deep-diary/trotbot_ws/src/trotbot_status_led/README.md

# trotbot_status_led（RQ-023）

鲁班猫 RK3588 上驱动 **WS2812** 直线灯带（默认 **8** 灯）：优先 **`spidev`（SPI MOSI）** 或 **`rockchip_mmap`（GPIO 寄存器）** / **`gpiod`**；订阅 `power_sequence_node` 的 **`/power_sequence/state`**、**`/power_sequence/gate_open`**，按 YAML 显示灯语。

## 依赖

- ROS 2 Humble：`rclcpp`、`std_msgs`、`yaml_cpp_vendor`
- 系统：**`libgpiod-dev`**（提供 `gpiod.h` 与 `libgpiod`）。若构建时未安装，CMake 会生成 **stub** 二进制（**不链 libgpiod**，**灯带绝不会亮**）。实机请先 **`sudo apt install -y libgpiod-dev`** 再 **`colcon build`**，并用 **`ldd …/status_led_node | grep gpiod`** 确认已链接。

## 构建

```bash
sudo apt install libgpiod-dev   # 实机 / 交叉编译环境（若仅用 rockchip_mmap 可不链 gpiod，仍建议安装以便可选 gpiod 后端）
cd /path/to/trotbot_ws
source /opt/ros/humble/setup.bash
colcon build --packages-select trotbot_status_led --allow-overriding trotbot_status_led
source install/setup.bash
```

### 完整编译 + 实机灯语自测（可复制）

在 **工作空间根目录** 执行。

- 默认参数为 **`ws2812_backend: spidev`**：只需 **`/dev/spidev*`** 存在且用户有权限（常见：`dialout` 组），**一般不必 sudo**。
- 若仍使用 **`rockchip_mmap`**：**必须 `sudo`** 才能 mmap **`/dev/mem`**（见「常见故障」）。

```bash
cd ~/trotbot_ws
source /opt/ros/humble/setup.bash
colcon build --packages-select trotbot_status_led --allow-overriding trotbot_status_led
source install/setup.bash

bash ~/trotbot_ws/install/trotbot_status_led/share/trotbot_status_led/scripts/test_status_led_manual.sh
```

使用 **`rockchip_mmap`** 时用：

```bash
sudo -E env "PATH=$PATH" bash -lc '
  source /opt/ros/humble/setup.bash
  source ~/trotbot_ws/install/setup.bash
  export TROTBOT_WS=$HOME/trotbot_ws
  bash ~/trotbot_ws/install/trotbot_status_led/share/trotbot_status_led/scripts/test_status_led_manual.sh
'
```

若工作空间不在 `~/trotbot_ws`，把路径与 **`TROTBOT_WS`** 改成实际目录。

也可 **`bash …/install/.../scripts/test_status_led_manual.sh`**：脚本会向上查找 **`install/setup.bash`**。失败时请 **`export TROTBOT_WS=/你的/trotbot_ws`**。

## 后端：`spidev`（默认）、`rockchip_mmap`、`gpiod`

- **`ws2812_backend: spidev`（推荐）**：通过 **`/dev/spidevX.Y`** 用 **MOSI** 送出编码后的字节流；波形由 **SPI 硬件** 移位，**CPU 抖动小**，通常**不需 root**。鲁班猫 **40PIN Pin19 = `SPI0_MOSI_M2`**，灯带 **DIN** 接该脚（详见 [`docs/SPI_WS2812_RK3588.md`](docs/SPI_WS2812_RK3588.md)）。需在设备树中 **启用对应 SPI 控制器 + `spidev`**，`ls /dev/spidev*` 应可见设备。
- **`ws2812_backend: rockchip_mmap`**：通过 **`/dev/mem`** mmap GPIO。**RK3588 为 GPIO V2**，须 **掩码写 DR**；启动时用 **gpiod 一次性 mux**。**需 `sudo`**。
- **`gpiod`**：**ioctl 过慢**，易 **发白**，仅调试用。

参数 **`mmap_gpio_phys_base`**（仅 mmap）：RK3588 **GPIO3** 一般为 **`0xFEC40000`**，与 **`gpio_line_offset`**（Pin16=`GPIO3_C1`→ **17**）组合。

## 参数与映射

- 默认参数：[`config/status_led_params.yaml`](config/status_led_params.yaml）（**spidev**：填写 **`spidev_path`**；**mmap**：按 **`gpioinfo`** 填写 **`gpiochip`** / **`gpio_line_offset`**）。
- 灯语规则：[`config/status_led_map.yaml`](config/status_led_map.yaml)（状态 → RGB；YAML 字段 **`effect`**：`solid` / `breath` / `chase`（流水预留）；**`breath_period_s`** 用于呼吸周期）。
- **`led_count`**：灯珠数量，默认 **8**。
- **刷新策略**：**`refresh_on_change_only`**（默认 **true**）— 仅在 **`/power_sequence/state`** 或 **`gate_open`** 变化（及启动延迟首帧）时写 WS2812；固态规则不按固定 **`refresh_hz`** 连续刷。**`change_repeat_count`** / **`change_repeat_interval_ms`**：同一变化下重复写次数与间隔（抗偶发丢帧）。**`animation_refresh_hz`**：呼吸等动画的独立刷新频率。**`initial_push_delay_ms`**：启动后延迟首帧，便于 **`transient_local`** 状态先到。**`refresh_on_change_only:=false`** 时恢复旧行为：按 **`refresh_hz`** 周期刷新（仍可用于排查闪烁）。
- **`simulate_hardware: true`**：不访问 GPIO（订阅与映射仍运行），用于无硬件桌面调试。
- **`debug_fixed_color: true`**：忽略灯语映射，全条同一 **`debug_fixed_r/g/b`**（再乘 **`global_brightness`**），由 **`refresh_hz`** 周期刷新；量产请 **`false`**。
- **联调话题（无需另写节点）**：**`publish_debug_rgb: true`** 时发布 **`debug_rgb_topic`**（默认 **`/status_led/debug_rgb`**，`std_msgs/UInt8MultiArray` 3 字节 R、G、B，已乘 **`global_brightness`**）与 **`debug_meta_topic`**（默认 **`/status_led/debug_meta`**，`std_msgs/String`，含 `state`、`gate_open`、**`map_match`** 等）。`map_match=0` 且灯色与预期不符时，多为状态字符串与 YAML 不一致。联调可并行：`ros2 topic echo /power_sequence/state` 与 `ros2 topic echo /status_led/debug_meta`。

## 启动

单独：

```bash
ros2 launch trotbot_status_led status_led.launch.py
```

仅 **`ros2 run`** 时若**不加参数文件**，只会用节点内置默认值（已与 **`ws2812_backend:=spidev`** 对齐）。要完整使用 **`config/status_led_params.yaml`**（灯语 / `debug_fixed_color` 等），请二选一：

```bash
ros2 launch trotbot_status_led status_led.launch.py
```

```bash
ros2 run trotbot_status_led status_led_node --ros-args \
  --params-file "$(ros2 pkg prefix trotbot_status_led)/share/trotbot_status_led/config/status_led_params.yaml"
```

整机（示例，`trotbot_basic` **默认不启用**，需显式打开）：

```bash
ros2 launch trotbot trotbot_basic.launch.py use_can_bridge:=true use_status_led:=true
```

覆盖参数文件：

```bash
ros2 launch trotbot_status_led status_led.launch.py params_file:=/path/to/my_params.yaml
```

## PS4 手柄灯条 / 振动反馈（`ds4_feedback_node`）

除了 WS2812 灯带，本包还提供 **PS4（DualShock 4）灯条 + 振动** 反馈：`ds4_feedback_node` 直接读 `status_led_map.yaml` 的灯语，把狗子状态同步到手柄。可与 WS2812 节点**并行运行**，两者互不冲突。

### 反馈内容

| 来源 | 手柄表现 |
|---|---|
| `/power_sequence/state` + `/power_sequence/gate_open` | 按 [`config/status_led_map.yaml`](config/status_led_map.yaml) 显示颜色（Idle 蓝、Running 绿、Precheck/SoftStand 橙、SoftProne 橙红、ProneHold 蓝、Fault 红等） |
| 进入 Running（gate 开） | 绿灯 + 弱震 120 ms |
| 进入 ProneHold | 蓝灯 + 弱震 120 ms |
| 进入 Idle/Disable/SoftProne 且 gate 关 | 对应灯色 + 强震 500 ms（下电/失控能提示） |
| `Fault` 或电机故障 | 红灯双闪 + 双强震（各 200 ms，间隔 350 ms） |
| `/cmd_vel` 行走/静止 | Running 时行走高亮绿灯，静止压暗到 35%；起步弱震 80 ms（可关） |
| `/diagnostics` 电机故障 | `trotbot_can_bridge:motor_feedback:*` 的 ERROR 或 `fault_mask != 0` → 红灯双闪 + 双震 |

> 电机故障需要 `trotbot_can_bridge/config/control_gains.yaml` 中 `publish_motor_diagnostics: true`（本仓库默认已开）。

### 依赖与权限

- Python：`rclpy`、`std_msgs`、`geometry_msgs`、`diagnostic_msgs`、`ament_index_python`、`python3-yaml`。
- 设备：自动扫描 `/dev/hidraw*`（DS4 VID `054C`，PID `05C4/09CC/0BA0`），USB/蓝牙均可；也可用 `hidraw_path` 指定。
- 权限：当前用户需对 `/dev/hidraw*` 可读写（常见为 `dialout` 组或 udev 规则）。无权限/无手柄时节点只 WARN 一次并继续发布调试话题，不影响遥控。

### 启动

```bash
# 单独启动
ros2 launch trotbot_status_led ps4_feedback.launch.py

# 随 teleop 一起（trotbot_teleop.launch.py 默认 use_ps4_feedback:=true）
ros2 launch trotbot trotbot_teleop.launch.py use_joystick:=true use_ps4_feedback:=true

# 整机（use_teleop:=true 时透传）
ros2 launch trotbot trotbot_basic.launch.py use_can_bridge:=true use_teleop:=true \
  use_joystick:=true use_xterm:=false use_status_led:=true use_ps4_feedback:=true
```

关闭手柄反馈：传 `use_ps4_feedback:=false`，或 `ros2 param set /ds4_feedback_node ...` 后重启。

### 调试话题

`/trotbot/ps4/feedback`（`std_msgs/String`，JSON）变化即发，并每 1 s 心跳一次，字段：

```json
{"state":"Running","gate":true,"cmd_linear_x":0.1,"cmd_angular_z":0.0,"moving":true,
 "class":"ready","rgb":[0,255,0],"color":"#00FF00","pattern":"solid",
 "rumble_weak":0.0,"rumble_strong":0.0,"motor_fault":false,"map_match":true,"device":"hidraw2"}
```

无手柄时 `device` 为空，其余逻辑仍可验收：

```bash
ros2 topic pub --once /power_sequence/gate_open std_msgs/msg/Bool "{data: true}"
ros2 topic pub --once /power_sequence/state std_msgs/msg/String "{data: Running}"
ros2 topic echo /trotbot/ps4/feedback
```

参数文件：[`config/ps4_feedback_params.yaml`](config/ps4_feedback_params.yaml)（振动强度/时长、行走阈值与亮度、调试心跳周期等）。

## 降级语义

- **GPIO 打开失败**或 **stub 构建**：节点保持运行，**不打断**运动栈；仅 WARN 一次，无灯带输出。
- **绿灯（就绪）语义**：仅在 **完整 ROS 栈已启动**、**映射条件成立**且 **硬件驱动成功**时成立；若 systemd 未拉起状态灯节点或映射未进入「可遥控」状态，**不得**仅凭「无灯」推断整机状态。

## RK3588 / GPIO 实测

填写模板见 [`docs/RK3588_GPIO_WS2812_HAL.md`](docs/RK3588_GPIO_WS2812_HAL.md)（**GPIO3_C1**、**Pin16**、`gpiochip`+line、镜像记录）。

## systemd 示例

- **只跑灯带**（不启整机）可用下例；**更常见**是开机直接起 **`trotbot_basic`**（含 `use_status_led:=true`），见仓库根 **`README.md`「开机自启（systemd）」** 与包内 **`trotbot/config/systemd/trotbot-basic.service.example`**。

```ini
[Unit]
Description=TrotBot WS2812 status LED (ROS 2)
After=network-online.target

[Service]
Type=simple
User=bot
Environment="ROS_DOMAIN_ID=0"
ExecStart=/bin/bash -lc 'source /opt/ros/humble/setup.bash && source /home/bot/trotbot_ws/install/setup.bash && ros2 launch trotbot_status_led status_led.launch.py'
Restart=on-failure

[Install]
WantedBy=multi-user.target
```

将 `ExecStart` 与整机 bringup 对齐；灯带与 `trotbot_basic` 同进程时，用 **同一 install/setup** 与 **`use_status_led:=true`** 的顶层 launch 即可，**不要**再单独 enable 上例，避免双起 `status_led`。

## 验证

```bash
ros2 node list | grep status_led
ros2 topic echo /power_sequence/state --once
# 预期 Running + gate_open 时呈绿色整条（见 status_led_map.yaml）
```

## 常见故障

| 现象 | 排查 |
|---|---|
| **各色都像白 / 全亮** | 多为位时序被判成全 **1**。已默认 **AArch64 CNTVCT 忙等** + 可调 **`timing_*_ns`**；建议 **`sudo`** 并启用 **`mlock_all`** / **`realtime_sched_priority`**（见 `status_led_params.yaml`）。仍发白则继续**减小** `timing_t0h_ns`、`timing_t1h_ns` 或微调 `t0l`/`t1l`。 |
| **无 sudo 时似乎永远停在上一档灯语（例如一直是 Precheck）** | `rockchip_mmap` 打不开 **`/dev/mem`** → 节点**不发帧**；灯珠仍显示**上一次成功点亮会话的最后一帧**，不是话题没更新。请 **`sudo`** 运行节点，或改用 **`ws2812_backend:=gpiod`**（见日志 WARN/ERROR）。 |
| **第一颗灯高频率闪、且偏绿** | WS2812 协议为 **GRB**，线路上**第一字节是 G**；首 bit 时序或总线边沿略抖时，常先反映为**绿通道**闪。可试：① 设 **`timing_lead_in_reset_us`** 为 **500～800**（帧前长低，比 `pre_frame` 更稳）；② 略增 **`timing_reset_us`**；③ 将 **`refresh_hz`** 降到 **30～40**；④ 硬件上 DIN 串 **200～470Ω**、**3.3V/5V 电平**与**共地**可靠。若仍明显，需考虑 **SPI/MOSI 发码** 等更稳的物理层。 |
| **第一颗灯偶尔乱色 / 闪**（一般） | 当不用 `lead_in` 时，可增大 **`timing_pre_frame_idle_us`**；与上一行二选一或组合试验。 |
| `Device or resource busy` | DTS/其它驱动占用该 GPIO；见野火文档与 `docs/RK3588_GPIO_WS2812_HAL.md` |
| 灯色错乱 | 微调 `timing_*_ns` / `timing_reset_us`；检查电平与供电共地 |
| 构建提示 stub | 安装 `libgpiod-dev` 后 **`colcon build` 重编** |
| **`spidev 打开失败`**（日志 WARN） | 常见为 **`/dev/spidev0.0` 权限不足**（如属 root 且 `600`）。临时：`sudo chmod 666 /dev/spidev0.0`；长期：用户加入 **`dialout`** 组并配置 **udev** 规则，或 **`sudo`** 运行节点。 |
| **SPI 灯色不对 / 全白乱闪** | 核对 **`spidev_max_speed_hz`**（默认 6.4 MHz）与 **`spidev_bit0_byte` / `spidev_bit1_byte`**；官方 overlay 若固定别的时钟需重算编码，见 **`docs/SPI_WS2812_RK3588.md`**。 |
| **SPI 首灯偶发闪绿** | WS2812 为 **GRB**，首字节为 G。可试：**`spidev_pre_write_idle_us`**（80～200）、**`spidev_reset_trailer_bytes`**（180～300）、**`spidev_leading_spi_zero_bytes`**（0～32，无效则置 0）、略降 **`refresh_hz`**；硬件：**DIN 串电阻**、电平与共地。 |
