deep-diary/trotbot_ws/.trae/documents/机器狗过温保护实现计划.md

# 机器狗过温保护（等效 R3 下电）实现计划

## 一、需求与结论

**需求**：任意电机温度达到 100°C 时，自动执行与「按下 R3」完全一致的动作——退出当前模式 → 软趴 safe-park → 失能 → 回到 `Idle` 休息降温。

**现状结论：狗子目前不具备该功能。**

- 温度数据已经存在：`/can_rx_frames` 里 `0x18`（主动上报）/`0x02`（应答反馈）帧的 `data[6..7]` 已被解析为 `MotorFeedback::current_temp`（单位 °C，分辨率 0.1，大端）。
- 但温度只被用于：`/motor_feedback` 字符串打印、`/diagnostics` 的 `temp_c` 字段；**不参与任何动作决策**。
- 固件 `temp_error` 故障位（CAN ID bit18）只被塞进诊断 `fault_mask` 的 bit3，进而只影响手柄红灯/震动，**不会停车或失能**。
- `SequenceState::Fault` 是空壳（无任何 `EnterState(Fault)`、无出口逻辑），不可直接复用。
- 全仓无 `thermal` / `overheat` / `max_temp` 之类阈值保护；`README.md:566` 的 `safety_manager_node` 仍是 Backlog。

**已确认的设计选择（用户选择）**

1. **锁定 + 滞回**：触发后屏蔽 L3 上电，直到所有有效电机温度降到恢复阈值（默认 80°C）以下，且仍需人工按 L3 才会上电。
2. **仅日志**：触发/解除只打 `RCLCPP_ERROR`/`WARN` 日志，不新增话题、不改状态机、不接灯。

## 二、现状关键代码位置（已实测确认）

| 关注点 | 位置 |
|---|---|
| 温度解码（唯一可信源） | [protocol_codec.hpp](file:///home/cat/trotbot_ws/src/trotbot_can_bridge/include/trotbot_can_bridge/protocol_codec.hpp#L139-L163)，温度在 **L160** |
| 反馈缓存（已订阅 `/can_rx_frames`） | [power_sequence_node.cpp](file:///home/cat/trotbot_ws/src/trotbot_can_bridge/src/power_sequence_node.cpp#L229-L255)，角度缓存在 **L237-242** |
| 参数声明区 | 同文件 **L66-136**；反馈相关参数在 **L98-100** |
| 主循环 `OnTimer` | **L338-429**；`motor_init_active_` 早退在 **L375-377**；`Idle` 分支 **L379-388** |
| R3 分支（`Running` L394-398、`ProneHold` L407-410、启动过程 L420-425） | 同文件 |
| 软趴/失能链路 | `BeginSoftProne(true)` **L504-520** → `TickState` **L463-479** → `Disable` **L484-495** → `Idle` |
| 状态枚举 | **L47-58** |
| 成员变量区 | **L1087-1194**；反馈缓存在 **L1152-1154** |
| 配置 | [power_sequence.yaml](file:///home/cat/trotbot_ws/src/trotbot_can_bridge/config/power_sequence.yaml) |
| 文档（按键表） | [README.md](file:///home/cat/trotbot_ws/README.md#L454-L464) |

## 三、改动方案

### 3.1 `src/trotbot_can_bridge/config/power_sequence.yaml`

在「反馈新鲜度」块之后（现 L88 之后）追加，并保持现有中文注释风格：

```yaml
    # --- 过温保护（等效按 R3：软趴 -> 失能 -> Idle）---
    # 任一路有效反馈温度 >= thermal_limit_c 并持续 thermal_debounce_s 后触发一次；
    # 触发后锁存，屏蔽 L3/start 上电，直到所有有效温度 <= thermal_recover_c 才解锁（仍需人工按 L3）。
    enable_thermal_protection: true
    thermal_limit_c: 100.0
    thermal_recover_c: 80.0
    thermal_debounce_s: 0.5
    # 超过该秒数没有 0x18/0x02 反馈的电机视为无效，不参与判定
    thermal_fresh_timeout_s: 2.0
```

### 3.2 `src/trotbot_can_bridge/src/power_sequence_node.cpp`

**(a) 构造函数新增参数（插在 L100 `motor_feedback_fresh_timeout_s_` 之后）**

```cpp
enable_thermal_protection_ = this->declare_parameter<bool>("enable_thermal_protection", true);
thermal_limit_c_ = this->declare_parameter<double>("thermal_limit_c", 100.0);
thermal_recover_c_ = this->declare_parameter<double>("thermal_recover_c", 80.0);
thermal_debounce_s_ = this->declare_parameter<double>("thermal_debounce_s", 0.5);
thermal_fresh_timeout_s_ = this->declare_parameter<double>("thermal_fresh_timeout_s", 2.0);
if (thermal_recover_c_ >= thermal_limit_c_) {
  RCLCPP_WARN(
    this->get_logger(), "thermal_recover_c=%.1f >= thermal_limit_c=%.1f invalid, fallback to %.1f",
    thermal_recover_c_, thermal_limit_c_, thermal_limit_c_ * 0.8);
  thermal_recover_c_ = thermal_limit_c_ * 0.8;
}
```

**(b) 成员变量（加在 L1111 `motor_feedback_fresh_timeout_s_` 之后 + 反馈缓存区 L1153-1154 之后）**

```cpp
bool enable_thermal_protection_{true};
double thermal_limit_c_{100.0};
double thermal_recover_c_{80.0};
double thermal_debounce_s_{0.5};
double thermal_fresh_timeout_s_{2.0};
double thermal_over_s_{0.0};      // 连续超限累计时间
bool thermal_latched_{false};     // 锁存：置位后禁止上电
int thermal_hot_motor_id_{-1};    // 最近一次触发电机（日志用）
double thermal_hot_temp_c_{0.0};
std::array<double, 64> last_feedback_temp_c_{};  // 新增，紧邻 last_feedback_angle_rad_
```

**时间戳复用**：不新增温度时间戳数组。温度与角度来自同一反馈帧，直接用现有 `last_feedback_stamp_ns_[id]`（L1154）判定新鲜度。

**(c) `OnCanRxFrame`（L237-242 现有 block 内）追加一行**

```cpp
last_feedback_temp_c_[fb->motor_id] = fb->current_temp;
```

**(d) 新增两个私有方法**（建议放在 `BeginSoftProne` 之前，L504 附近）

```cpp
/// 扫描缓存，返回最高有效温度；无有效数据返回 -1.0
double MaxFreshMotorTempC(int * motor_id_out)
{
  double max_temp = -1.0;
  int max_id = -1;
  const int64_t now_ns = this->now().nanoseconds();
  for (size_t id = 0; id < last_feedback_temp_c_.size(); ++id) {
    if (last_feedback_stamp_ns_[id] <= 0) {
      continue;
    }
    const double age_s = static_cast<double>(now_ns - last_feedback_stamp_ns_[id]) / 1e9;
    if (age_s > thermal_fresh_timeout_s_) {
      continue;
    }
    if (last_feedback_temp_c_[id] > max_temp) {
      max_temp = last_feedback_temp_c_[id];
      max_id = static_cast<int>(id);
    }
  }
  if (motor_id_out) {
    *motor_id_out = max_id;
  }
  return max_temp;
}

/// 过温判定 + 锁存/滞回。返回 true 表示本 tick 已触发（调用方应立即 return）
bool UpdateThermalProtection(double dt)
{
  if (!enable_thermal_protection_) {
    return false;
  }
  int max_id = -1;
  const double max_temp = MaxFreshMotorTempC(&max_id);

  if (thermal_latched_) {
    // 所有有效温度都回落到恢复阈值以下才解锁；无有效数据时保持锁存（保守）
    if (max_temp >= 0.0 && max_temp <= thermal_recover_c_) {
      thermal_latched_ = false;
      thermal_over_s_ = 0.0;
      RCLCPP_WARN(
        this->get_logger(),
        "thermal protection cleared: max temp %.1f C <= %.1f C; press L3 to power on again",
        max_temp, thermal_recover_c_);
    }
    return false;
  }

  if (max_temp >= thermal_limit_c_) {
    thermal_over_s_ += dt;
    if (thermal_over_s_ < thermal_debounce_s_) {
      return false;
    }
    thermal_latched_ = true;
    thermal_hot_motor_id_ = max_id;
    thermal_hot_temp_c_ = max_temp;
    RCLCPP_ERROR(
      this->get_logger(),
      "thermal protection TRIGGERED: motor=%d temp=%.1f C >= %.1f C; "
      "perform R3-equivalent safe-park -> disable (state=%s)",
      max_id, max_temp, thermal_limit_c_, StateName(state_));
    TriggerThermalShutdown();
    return true;
  }

  thermal_over_s_ = 0.0;
  return false;
}

/// 与 R3 完全等价的下电路径复用
void TriggerThermalShutdown()
{
  switch (state_) {
    case SequenceState::Running:
    case SequenceState::Precheck:
    case SequenceState::EnableInit:
    case SequenceState::SoftStand:
      BeginSoftProne(true);
      break;
    case SequenceState::SoftProne:
      // 已在趴下途中：不重新锚定 z0（避免高度跳变），仅升级为「趴完再失能」
      pending_start_after_prone_ = false;
      use_stand_resume_for_softstand_ = false;
      soft_prone_then_disable_ = true;
      break;
    case SequenceState::ProneHold:
      EnterState(SequenceState::Disable);
      break;
    case SequenceState::Idle:
    case SequenceState::Disable:
    case SequenceState::Fault:
    default:
      break;
  }
}
```

**(e) `OnTimer` 挂载（L375-377 的 `motor_init_active_` 早退之后、L379 `Idle` 分支之前）**

```cpp
    // 过温保护：等效 R3，最高优先级；触发当 tick 直接接管
    if (UpdateThermalProtection(dt)) {
      return;
    }
```

放在 `motor_init_active_` 之后的原因：设零期间电机未使能、门禁关闭，不应被热保护打断；且此时 `state_` 为 `Idle`，`TriggerThermalShutdown()` 本身也是 no-op。

**(f) 锁存期间屏蔽上电（3 处）**

1. `OnTimer` `Idle` 分支（L381）：

```cpp
      if (l3_edge) {
        if (thermal_latched_) {
          RCLCPP_WARN(
            this->get_logger(),
            "joy L3 ignored: thermal protection latched (motor=%d was %.1f C, need <= %.1f C)",
            thermal_hot_motor_id_, thermal_hot_temp_c_, thermal_recover_c_);
          return;
        }
        ... 原逻辑
      }
```

2. `OnTimer` `ProneHold` 分支的 `square_edge`（站起也是使能态延续）：同样先判 `thermal_latched_`，命中则 `WARN` 并忽略。

3. `OnCommand` 的 `start` 分支入口（L280 之后）：`if (thermal_latched_) { WARN; return; }`。

`R3`/`shutdown`/`prone`/`set_zero` 不受锁存影响（继续允许下电）。

## 四、行为定义（决策完备）

| 触发时状态 | 动作 |
|---|---|
| `Running` / `Precheck` / `EnableInit` / `SoftStand` | `BeginSoftProne(true)` → 软趴 2.5s → `Disable` 失能 → 0.25s → `Idle` |
| `SoftProne`（○ 趴下途中） | 升级为「趴完即失能」，不重锚 `z0` |
| `ProneHold` | 直接 `EnterState(Disable)` |
| `Idle` / `Disable` / `Fault` | 只记录日志并锁存，无额外动作（已失能） |

- **去抖**：连续 `>= thermal_limit_c` 累计 `thermal_debounce_s`（默认 0.5s ≈ 25 个 tick）才触发，避免单帧毛刺。
- **新鲜度**：只用 `<= thermal_fresh_timeout_s`（默认 2s）内的反馈；全部超时则视为无数据，不触发也不解锁。
- **锁存与解锁**：触发即锁存；当**有有效数据且最大值 `<= thermal_recover_c`** 时自动解锁并打 WARN；解锁后仍需人工按 L3。
- **进程重启**：锁存为内存态，重启节点/断电后清零（符合「休息降温后再上电」的直觉）。

## 五、假设与非目标

- 假设温度字段可信（`protocol_codec.hpp:160` 已验证 0.1°C、大端）。
- 不新增 `Fault` 状态、不改状态灯 `status_led_map.yaml`、不改 `ds4_feedback_node`。
- 不新增话题；不处理固件 `temp_error` 位（该位仍只走原诊断/红灯链路）。
- 不改 `motor_protocol_node`、不改 `motor_monitor_node`。
- 阈值仅对反馈温度生效，不做电流/力矩热模型估算。

## 六、验证步骤

1. **编译**

```bash
cd /home/cat/trotbot_ws
colcon build --packages-select trotbot_can_bridge --symlink-install
source install/setup.bash
```

2. **参数生效**

```bash
ros2 param get /power_sequence_node thermal_limit_c        # 100.0
ros2 param get /power_sequence_node thermal_recover_c      # 80.0
ros2 param get /power_sequence_node enable_thermal_protection  # True
```

3. **无硬件注入测试**（推荐先做，不接电机）

`power_sequence_node` 已订阅 `/can_rx_frames`，手工发一帧伪造的 `0x18` 上报帧即可。打包格式见 [frame_codec.hpp](file:///home/cat/trotbot_ws/src/trotbot_can_bridge/include/trotbot_can_bridge/frame_codec.hpp#L16-L19)：`[bus, is_ext, dlc, id3, id2, id1, id0, d0..d7]`。

电机 51、温度 100.0°C（1000 = 0x03E8）时 `can_id = 0x180033FD`：

```bash
ros2 topic pub --once /can_rx_frames std_msgs/msg/UInt8MultiArray \
  "{data: [0, 1, 8, 24, 0, 51, 253, 0, 0, 0, 0, 0, 0, 3, 232]}"
```

- 以 `thermal_limit_c:=35.0 thermal_debounce_s:=0.0` 启动节点，发上述帧后应出现
  `thermal protection TRIGGERED: motor=51 temp=100.0 C`。
- 发温度 20°C（200 = 0x00C8 → `[...,0,0,0,200]`，即 `data[6]=0x00,data[7]=0xC8`）后，应出现
  `thermal protection cleared`，随后 L3 可上电。

4. **实机测试**

低阈值跑一次全链路（`thermal_limit_c:=40.0`）：确认 `Running` → `SoftProne` → 软趴到 `prone_z` → `Disable` 失能 → `Idle`，且 `/power_sequence/state` 序列与按 R3 时一致；锁存期间按 L3 应被 WARN 拒绝。

5. **回归**

R3 / ○ / □ / L3 / L1+R1 原行为不变（重点确认 `Running` 下 R3 仍先软趴再失能，`ProneHold` 下 R3 直接失能）。

## 七、文档更新

`README.md` 的按键/状态机章节（L454-464 表格后）补一小段「过温保护」，说明阈值参数、等效 R3 行为、锁存与滞回、恢复方式。`power_sequence.yaml` 注释已覆盖参数语义，不另建文档。
