deep-diary/trotbot_ws/docs/trotbot/本地运行指南.md

# 本地运行指南（入口）

## 主文档位置

**详细步骤（安装、编译、遥控、RViz、CAN 调研章节等）**在包内：

- **`src/trotbot/本地运行指南.md`**

本文档为 `docs/trotbot/` 下的**入口与实机基线摘要**，便于与需求/架构文档交叉引用。

---

## 实机 EL05 双 CAN + 遥控（当前推荐基线）

1. **编译与环境**（至少包含 `trotbot`、`trotbot_can_bridge`、`champ_base`、`champ_teleop`）：
   ```bash
   source /opt/ros/humble/setup.bash
   cd ~/trotbot_ws
   colcon build --symlink-install --packages-select champ_msgs champ champ_base champ_teleop trotbot trotbot_can_bridge
   source install/setup.bash
   ```
2. **CAN**：确认 `can0`/`can1` 已 `up`、波特率与电机一致（常见 1Mbps）。参见根目录 **`README.md`**「MIT 双 CAN」章节与 `src/trotbot/本地运行指南.md` 11.7 节。
3. **整机启动**（步态 + CAN 桥 + 上电状态机，默认 **无** `servo_interface` 时勿再依赖舵机）：
   ```bash
   ros2 launch trotbot trotbot_basic.launch.py use_servo_interface:=false use_can_bridge:=true
   ```
4. **遥控**（另一终端，`champ_teleop` + 手柄/键盘）：
   ```bash
   ros2 launch trotbot trotbot_teleop.launch.py use_joystick:=true use_xterm:=false
   ```
5. **启停与姿态**：由 **`power_sequence_node`** 处理（默认随 `can_bridge.launch.py` 启动）。手柄约定见 **`src/trotbot_can_bridge/config/power_sequence.yaml`** 与 **[遥控与电源启停.md](./遥控与电源启停.md)**；无手柄时可用 `/power_sequence/command`（`start` / `prone` / `shutdown` / **`set_zero`**（仅 Idle+门禁关））。
6. **RViz 双模型**：`trotbot_basic.launch.py` 设 `rviz:=true` 时加载 `share/trotbot/rviz/trotbot.rviz`；反馈模型订阅 `/robot_description_feedback` 与 `fb/` TF 前缀，依赖 **`/joint_states_feedback`**（`motor_protocol_node` 定时发布 + CAN 更新缓存）。

---

## 文档放置原则

| 路径 | 用途 |
|---|---|
| `docs/trotbot/` | 需求清单、架构、问题跟踪、本入口（协作型） |
| `src/trotbot/本地运行指南.md` | 逐步操作、排障、CHAMP 补丁、长章节（执行型） |
| 根 `README.md` | 编译/启动、常用话题查看、遥控简表 |
| **CAN配置与报文调试.md** | 设备树 overlay、can-up、1Mbps 配置、`cansend` / `candump` |
| `src/trotbot_can_bridge/README.md` | 桥接脚本、协议调试、`power_sequence` 按键与话题 |
| **[音频使用说明.md](./音频使用说明.md)** | 实机蓝牙/板载音频：`pactl`、默认设备、录音与播放命令 |
