deep-diary/trotbot_ws/docs/trotbot/架构说明.md

# TrotBot 架构说明（ROS 2 Humble + EL05 双 CAN）

本文档面向当前硬件与代码基线，给出可落地的软件架构、ROS 节点、话题分布与数据流向。

- 计算平台：鲁班猫4-V1（RK3588S）
- 系统：ROS 2 Humble
- 执行器：灵足 EL05 无刷关节电机（12 路）
- 总线拓扑：`can0` 前腿 6 电机（11/12/13/21/22/23），`can1` 后腿 6 电机（51/52/53/61/62/63）
- 通信基线：CAN 2.0，`1Mbps`

---

## 1. 设计目标与边界

### 1.1 版本目标（当前阶段）

1. 打通 CHAMP 轨迹到 12 电机的稳定执行链路。
2. 建立可观测闭环（至少覆盖原始反馈和映射后状态）。
3. 对总线、越限、失联等问题具备基础保护能力。
4. 保持架构可演进，支持后续一键上/下电流程与双模型可视化。

### 1.2 边界约束

- 步态控制核心继续复用 `champ_base`，不改 CHAMP 内核。
- 下位机协议遵循 EL05 文档，控制模式以 MIT 运控链路为主。
- 现阶段优先“功能可用与稳定”，控制频率后续按实测再收敛。

---

## 2. 当前代码基线架构（As-Is）

当前真实链路（已与代码对齐）如下：

```mermaid
flowchart LR
  teleop[champ_teleop<br/>键盘/手柄] -->|/cmd_vel| qc
  teleop -->|/body_pose| qc
  teleop -->|/joy| ps
  qc[champ_base/quadruped_controller_node] -->|/joint_group_effort_controller/joint_trajectory| mp
  ps[power_sequence_node] -->|/power_sequence/gate_open Bool| mp
  ps -->|/body_pose Pose| qc
  ps -->|/can_tx_frames UInt8MultiArray| ct
  se[champ_base/state_estimation_node]:::node
  mp[motor_protocol_node] -->|/can_tx_frames UInt8MultiArray| ct
  ct[can_transport_node] -->|SocketCAN can0| can0[(Front 6 motors)]
  ct -->|SocketCAN can1| can1[(Rear 6 motors)]
  can0 -->|feedback frames| ct
  can1 -->|feedback frames| ct
  ct -->|/can_rx_frames UInt8MultiArray| mp
  mp -->|/motor_feedback String| obs[观测/日志]
  mp -->|/mit_motor_position_rad JointState| obs
  mp -->|/joint_states_feedback JointState| rspfb[robot_state_publisher_feedback]
  rsp[robot_state_publisher] --> rviz[RViz]
  rspfb --> rviz
  classDef node fill:#eef,stroke:#88a;
```

### 2.1 已落地节点

- `champ_base/quadruped_controller_node`
  - 订阅 `cmd_vel`，发布关节轨迹到 `joint_group_effort_controller/joint_trajectory`。
- `champ_base/state_estimation_node`
  - 状态估计节点，提供 CHAMP 状态闭环所需估计量。
- `trotbot_can_bridge/motor_protocol_node`
  - 订阅 `joint_trajectory`，按关节映射生成 MIT 五元组并发布到 `can_tx_frames`。
  - 订阅 `can_rx_frames`，解析 **0x02 应答反馈** 与 **0x18 主动上报**（数据域与 0x02 一致）；`enable_rx_decode_log` **仅**控制 `/motor_feedback` 字符串与解码 INFO，**不**影响反馈解析与关节角缓存。
  - 发布 `/joint_states_feedback`（CHAMP 关节名顺序，`SensorDataQoS`）；默认 **`feedback_joint_states_timer_hz`** 定时发布，与 CAN 反馈解耦，供 `robot_state_publisher_feedback` 与 RViz **`RobotModelFeedback`** 使用。**RQ-012**：当 **`publish_feedback_velocity_effort=true`** 时填充 **`velocity`**（rad/s，CHAMP 语义，`ω_champ = ω_mit / joint_signs`）与 **`effort`**（Nm，EL05 电机报告力矩，与 MIT `tau_ff` 同号）；缺失样本由 **`feedback_joint_fill_nan`** 决定 NaN 或 0。可选 **`publish_motor_diagnostics`** → **`motor_diagnostics_topic`**（默认 `/diagnostics`）发布 **`diagnostic_msgs/DiagnosticArray`**（每关节 `mode_status`、`temp_c`、`fault_*`）。**RQ-022**：MIT **`tau_ff`** = **`Clamp(runtime_tau_bus + gravity_ff_scale * tau_ff_nominal_nm[i], …)`**，由 **`enable_joint_tau_ff`** 开关；关闭时仍为前后总线标量 **`runtime_tau_can0/can1`**。
  - 可发布 MIT 映射角到 `/mit_motor_position_rad`。
  - 可选 `enable_power_sequence_gate`：仅当 `/power_sequence/gate_open=true` 时透传轨迹（与 `power_sequence_node` 联调）。
- `trotbot_dynamics/pinocchio_tau_ff_node`（**RQ-025**，可选，默认不启动）
  - 用 URDF（launch 通过 `xacro` 注入 `robot_description`）建立 **定基 12 自由度** Pinocchio 模型，校验关节名与 `DogMapper::kChampJointNames` 一致。
  - 订阅 `/joint_states_feedback`（按关节名映射），以 **`publish_hz`（默认 50Hz）** 计算广义重力项 `g(q)`，发布 `/model_tau_ff`（`sensor_msgs/JointState`，仅 `name` + `effort`，URDF 关节符号）。
  - 反馈超过 `input_timeout_s`（默认 0.2s）未更新时停止发布，由 `motor_protocol_node` 回落到查表/总线偏置。
- `trotbot_can_bridge/can_transport_node`
  - 订阅 `/can_tx_frames`，通过 SocketCAN 下发 `can0/can1`。
  - 轮询 `can0/can1` 回包并发布 `/can_rx_frames`。
  - 内置队列、重试、统计日志。
- `trotbot_can_bridge/power_sequence_node`
  - 订阅 `/joy`、`/power_sequence/command`、`/body_pose`（可选跟踪当前高度指令），处理上电/下电/趴下与 **`start`/`prone`/`shutdown`/`set_zero`/`motor_init`** 话题。
  - 发布 `/power_sequence/gate_open`、`/power_sequence/state`；可选 **`set_zero_event_topic`**（事件字符串：`set_zero_ok` / `set_zero_rejected:…`）与 **`motor_init_event_topic`**（`motor_init_ok` / `motor_init_fail` / `motor_init_rejected` / `zero_sta_verify_*`）。
  - 状态含 **`Idle / Precheck / EnableInit / SoftStand / Running / SoftProne / ProneHold / Disable / Fault`**：**`L3` 短按** = 上电/使能 **`start`**（唯一上电入口）；**`○` 短按** → `SoftProne` → **`ProneHold`**（idle 趴姿，保持使能）；**`□` 短按** → 从 `ProneHold` **`SoftStand`** 站起（stand，Running 时无动作）；`shutdown` 与 **`R3` 短按** → `SoftProne` → **`Disable`**（全机 Reset；`R3` 为唯一下电入口，Running/启动过程走 SoftProne，ProneHold 直接 Disable）。
  - `SoftProne`/`SoftStand` 高度：默认 **`track_body_pose_height`** 用当前 `body_pose.z` 作趴下起点；**`□` 短按站起**目标为 **`stand_z`**（名义站姿），话题 `start` 路径沿用 `stand_resume_z`。
  - **RQ-024**：话题 **`set_zero`** → **`TryRemoteSetZero`**：仅 **`Idle`** 且 **`gate_open=false`** 时连续 **`set_zero_repeat_count`** 轮 **`SendSetZeroAll()`**（CMD 0x06），轮间隔 **`set_zero_repeat_interval_ms`**；否则 WARN 拒绝。`Options` / `Share+Options` 手柄入口已取消。
  - **一次性电机标定初始化**：唯一手柄入口是未上电时 **`L1+R1`** 长按 **`motor_init_longpress_s`**（或话题 **`motor_init`**）→ 12 路 **`set_zero`**（当前姿态=机械零位，仅 `motor_init_do_set_zero=true`）→ 写 `zero_sta(0x7029)=1`（-180°~180°）→ CMD 0x16 保存 flash（data `01..08`）→ CMD 0x11 回读校验；仅 **`Idle`** 且 **`gate_open=false`**，初始化期间屏蔽 start/shutdown/prone，**必须在零位工装姿态下操作，写后需断电重启生效**。日常上电不再 set_zero。
  - 直接发布使能/失能/MIT 保持帧到 `/can_tx_frames` 完成启停编排；**`start`** 时先校验 12/12 反馈新鲜（`require_feedback_before_enable`），再使能，并按各电机当前反馈角发 MIT 保持帧（`send_mit_hold_in_startup`，不再发 `p=0`）。可选 **launch 后 Idle**（参数 **`enable_active_report_at_launch`**）即写 **0x7026** 并打开 **0x18**，无需等待 **`start`**；**`start`** 后的 **`EnableInit`** 仍会再跑完整使能链（可与 launch 阶段重复发上报，无害）。**`Disable` 仅发失能，不发送「上报 OFF」**，以便进程与 RViz 仍在运行时仍能收到周期反馈；需要关上报请用 `el05_motor_cansend.sh reset` 等。
- `trotbot_status_led/status_led_node`（**可选**，`trotbot/launch/trotbot_basic.launch.py` 中 **`use_status_led:=true`** 时随 **`trotbot_status_led/launch/status_led.launch.py`** 启动，默认不启用以免无硬件开发机失败）
  - 订阅 `/power_sequence/state`、`/power_sequence/gate_open`（**QoS** 与 `power_sequence` 发布端一致：`transient_local` + `reliable`），按 **`trotbot_status_led/config/status_led_map.yaml`** 将状态映射为 **8×WS2812** RGB 帧；**默认**在状态或 gate **变化时**写硬件（`refresh_on_change_only`，固态不周期狂刷），呼吸类规则用独立动画定时器。硬件输出由参数 **`ws2812_backend`** 选择：**`spidev`（SPI MOSI，默认）**、**`rockchip_mmap`（GPIO 寄存器 + `/dev/mem`）** 或 **`gpiod`**。设备不可用时**降级**（仅 WARN，不阻塞运动栈；见包 **README**）。

### 2.2 当前主要话题

| 话题 | 类型 | 方向 | 说明 |
|---|---|---|---|
| `/cmd_vel` | `geometry_msgs/Twist` | teleop -> CHAMP | 速度输入 |
| `/joint_group_effort_controller/joint_trajectory` | `trajectory_msgs/JointTrajectory` | CHAMP -> bridge | 12关节目标 |
| `/power_sequence/gate_open` | `std_msgs/Bool` | power_sequence -> protocol | 启动门禁开关（true 才透传轨迹） |
| `/power_sequence/command` | `std_msgs/String` | 外部 -> power_sequence | 无手柄时 `start`/`prone`/`shutdown` 文本指令 |
| `/power_sequence/state` | `std_msgs/String` | power_sequence -> 观测 | 状态机字符串（如 `Running`、`ProneHold`） |
| `/body_pose` | `geometry_msgs/Pose` | teleop / power_sequence -> quadruped_controller | 体态指令（`position.z` 为相对名义高度增量）；`power_sequence` 亦订阅以跟踪高度 |
| `/can_tx_frames` | `std_msgs/UInt8MultiArray` | protocol -> transport | 编码后的 CAN 帧 |
| `/can_rx_frames` | `std_msgs/UInt8MultiArray` | transport -> protocol | 回读 CAN 帧 |
| `/motor_feedback` | `std_msgs/String` | protocol -> debug | 解析后的电机反馈摘要（受 `enable_rx_decode_log` 控制是否刷屏） |
| `/mit_motor_position_rad` | `sensor_msgs/JointState` | protocol -> debug | 映射后的 MIT 位置 |
| `/joint_states_feedback` | `sensor_msgs/JointState` | protocol -> RSP/RViz | CHAMP 语义反馈：**`position`**；可选 **`velocity`/`effort`**（参数 **`publish_feedback_velocity_effort`**）；供 **`robot_state_publisher_feedback`**（`fb/` TF）与 RViz 反馈模型 |
| `/model_tau_ff`（可配置 **`pinocchio_tau_ff_topic`**） | `sensor_msgs/JointState` | dynamics -> protocol | **RQ-025** 模型重力前馈：`name` 为 12 个 CHAMP 关节，`effort` 为 URDF 关节空间 `g(q)`（Nm）；`motor_protocol_node` 经 `tau_signs`/`pinocchio_tau_ff_scale` 转换后写入 MIT `tau_ff` |
| `/diagnostics`（可配置 **`motor_diagnostics_topic`**） | `diagnostic_msgs/DiagnosticArray` | protocol -> 监控 | 可选：每关节电机 **`mode_status`**、温度、离散故障位（**`publish_motor_diagnostics`**） |

> 注：CHAMP 控制器仍发布 **`/joint_states`**（指令/估计链）；**反馈实测链**使用 **`/joint_states_feedback`**，与双模型 RViz 配置对应。

> **RQ-023**：`status_led_node` **仅订阅**上表已列出的 `/power_sequence/state` 与 `/power_sequence/gate_open`，不新增对外发布话题。

**MIT `tau_ff`（RQ-022）**：轨迹与最小刷新路径均使用 **`ComputeMitTorqueFf(i, bus)`**；总线偏置仍来自 **`default_tau_ff`** 与 **`/mit_gains_cmd`**（`runtime_tau_can0/can1`）；按关节前馈表为参数 **`tau_ff_nominal_nm`**（12 维，顺序同 **`DogMapper::kChampJointNames`**），全局增益 **`gravity_ff_scale`**，总开关 **`enable_joint_tau_ff`**（默认 **false**）。限幅：`ProtocolCodec::kTMin/kTMax`。

**RQ-025 模型前馈数据流（首版：定基 + 仅重力项）**：

```mermaid
flowchart LR
  js["/joint_states_feedback<br/>JointState.position"] --> dyn["pinocchio_tau_ff_node<br/>50Hz · computeGeneralizedGravity"]
  dyn -->|"/model_tau_ff<br/>JointState.effort (URDF 符号)"| mp["motor_protocol_node<br/>ComputeMitTorqueFf()"]
  mp -->|"MIT tau_ff"| can["/can_tx_frames"]
```

- 合并策略由 **`pinocchio_tau_ff_mode`** 决定：`off`（默认）/ `replace`（替代查表）/ `add`（与查表叠加，注意双计重力）。
- 安全链：模型数据超过 **`pinocchio_tau_ff_timeout_s`** 未更新 → 回落查表/总线偏置；门禁打开后按 **`pinocchio_tau_ff_ramp_s`** 线性斜坡；总增益 **`pinocchio_tau_ff_scale`** + 每关节 **`pinocchio_tau_ff_gain`**（默认 `0.5` / 全 1.0）；输出限幅 `kTMin/kTMax`。
- URDF τ → 电机 τ 的符号由 **`tau_signs`**（12 维）单独配置，初值同 `joint_signs`，但**必须逐关节做静力验证**，不得默认沿用位置符号。

---

## 3. 推荐目标架构（To-Be，V1.1）

目标是在不打断现有链路前提下，补齐“标准状态闭环 + 安全流程编排”。

```mermaid
flowchart LR
  subgraph Input["输入层"]
    joy[手柄/键盘]
    teleop2[champ_teleop]
  end
  subgraph Ctrl["控制层"]
    qc2[quadruped_controller_node]
    se2[state_estimation_node]
  end
  subgraph Bridge["执行桥接层"]
    mp2[motor_protocol_node]
    ct2[can_transport_node]
    sm[safety_manager_node<br/>建议新增]
    ps2[power_sequence_node<br/>已落地]
  end
  subgraph HW["硬件层"]
    can0b[(can0 front)]
    can1b[(can1 rear)]
    mtrs[(12x EL05)]
  end
  subgraph Viz["可视化与观测"]
    js[/joint_states feedback]
    cjs[/cmd_joint_states command]
    rviz2[RViz 单狗/双狗]
    diag[/diagnostics]
  end

  joy --> teleop2 -->|/cmd_vel| qc2
  qc2 -->|/joint_group_effort_controller/joint_trajectory| mp2
  mp2 -->|/can_tx_frames| ct2
  ct2 --> can0b --> mtrs
  ct2 --> can1b --> mtrs
  mtrs --> can0b --> ct2
  mtrs --> can1b --> ct2
  ct2 -->|/can_rx_frames| mp2

  mp2 --> js
  mp2 --> cjs
  mp2 --> diag
  ct2 --> diag
  sm -->|急停/限幅/门禁| mp2
  ps2 -->|gate_open / body_pose| mp2
  js --> rviz2
  cjs --> rviz2
```

### 3.1 新增/增强建议

1. ~~`motor_protocol_node` 增强反馈反解并发布标准 JointState~~：**已实现** `/joint_states_feedback`（反解 `urdf_pos = (motor_pos - offset) / sign`，顺序同 `kChampJointNames`；可选与标准 `/joint_states` 命名合并属产品口径问题）。
2. 增加 `cmd_joint_states`（命令态）用于双模型可视化（当前 RViz 指令侧仍主要依赖 `/joint_states`）。
3. 增加 `safety_manager_node`（可先内聚在 `motor_protocol_node`，后续再拆分）
   - 负责急停、越限截断、超时门禁、恢复条件。
4. ~~增加 `power_sequence_node`~~（**已落地**：`trotbot_can_bridge/power_sequence_node.cpp`，参数 `power_sequence.yaml`）
   - 后续可增强：与 `safety_manager` 统一急停接口、Action/Service 封装。

---

## 4. 数据流与时序

### 4.0 频率分解总览（2026-04-29 实测）

> 目的：定位“期望 200Hz 为何在链路中下降”。

```mermaid
flowchart LR
  joy["/cmd_vel<br/>geometry_msgs/Twist<br/>人工输入"] --> qc
  qc["quadruped_controller_node"] -->|"topic: /joint_group_effort_controller/joint_trajectory<br/>type: trajectory_msgs/JointTrajectory<br/>配置: loop_rate=200Hz<br/>真链路实测: ~200.0Hz"| mp

  mp["motor_protocol_node"] -->|"topic: /can_tx_frames<br/>type: std_msgs/UInt8MultiArray<br/>真链路实测: ~253.5fps"| ct
  mp -.->|"MP TX window(5s) 真链路:<br/>traj_cb:1000(≈200Hz)<br/>tx_total:3000(600fps)<br/>tx_traj:2976~3000(can0≈can1)<br/>tx_refresh:0~24<br/>skip_max_rate:9000+ "| mp

  ct["can_transport_node"] -->|"SocketCAN can0<br/>前腿ID:11/12/13/21/22/23"| can0
  ct -->|"SocketCAN can1<br/>后腿ID:51/52/53/61/62/63"| can1
  can0 -->|"反馈 /can_rx_frames<br/>真链路统计: enq_can0≈342~495/5s"| ct
  can1 -->|"反馈 /can_rx_frames<br/>真链路统计: enq_can1≈1248~1334/5s"| ct

  subgraph ext["外部显式脚本链路（非ROS）"]
    s1["el05_mit_stream_200hz_12_direct.sh<br/>目标:200Hz"] -->|"实测 loop:23.2Hz<br/>约 139fps/总线"| s2["cansend + sleep 调度"]
    s2 --> can0
    s2 --> can1
  end
```

- 关键结论1：真链路下 `/joint_group_effort_controller/joint_trajectory` 已稳定在约 `200Hz`，上游 CHAMP 频率本身正常。
- 关键结论2：`motor_protocol_node` 已观测到大量 `skip_max_rate`（每 5 秒约 `9000`），`max_tx_rate_per_motor_hz=60` 会主动削峰，导致协议层无法把 200Hz 全量透传到 `can_tx_frames`。
- 关键结论3（历史现象，已修复）：曾出现 `motor_protocol` 统计 `can0/can1` 近似 1:1，但 `can_transport` 的 `TX enqueue bus split(5s)` 偏向 `can1`。根因为 **`/can_tx_frames` 使用 BEST_EFFORT 浅队列导致 DDS 丢帧**；现改为 **Reliable + 足够深度** 后，两节点统计已一致（约 **1:1**，ratio≈1.01）。
- 关键结论4：外部 `bash+cansend` 显式脚本本身达不到 200Hz（实测约 23Hz loop），不能作为高频基线发送器。

### 4.1 控制主链路时序

```mermaid
sequenceDiagram
  participant U as 用户/手柄
  participant T as champ_teleop
  participant Q as quadruped_controller
  participant MP as motor_protocol
  participant CT as can_transport
  participant M as EL05电机

  U->>T: 摇杆/按键
  T->>Q: /cmd_vel
  Q->>MP: /joint_group_effort_controller/joint_trajectory
  MP->>MP: sign/offset 映射 + MIT打包
  MP->>CT: /can_tx_frames
  CT->>M: can0/can1 帧发送
  M-->>CT: 反馈帧
  CT-->>MP: /can_rx_frames
  MP-->>MP: 反馈解码 + 反向映射(建议)
  MP-->>RVIZ: /joint_states 与调试话题
```

### 4.3 频率预算（建议排障顺序）

1. 上游输入频率：先确认 `/joint_group_effort_controller/joint_trajectory` 实际 Hz（不要只看配置值）。
2. 协议层限频：观察 `MP TX window(5s)` 的 `skip_max_rate` 是否持续偏大。
3. 刷新补发：观察 `tx_refresh` 占比，若过高说明上游输入不稳或掉拍。
4. 传输层分配：对照 `can_transport_node` 的 `TX enqueue bus split(5s)` 是否接近 1:1。
5. 总线与电机反馈：最终用 `candump` 对照 can0/can1 的发送与反馈帧率是否同量级。

### 4.2 上/下电流程状态机（建议）

```mermaid
stateDiagram-v2
  [*] --> Idle
  Idle --> Zeroing: 上电触发
  Zeroing --> ZeroCheck
  ZeroCheck --> InitMotors: 零位通过
  ZeroCheck --> SafeAbort: 零位失败
  InitMotors --> LaunchControl
  LaunchControl --> AutoStand
  AutoStand --> Ready
  Ready --> MoveToProne: 下电触发
  MoveToProne --> DisableMotors
  DisableMotors --> ShutdownReady
  SafeAbort --> Idle
  ShutdownReady --> [*]
```

---

## 5. 话题与接口规划（建议基线）

### 5.1 运动与状态接口

- 输入
  - `/cmd_vel`
  - `/joint_group_effort_controller/joint_trajectory`
- 执行桥接内部
  - `/can_tx_frames`
  - `/can_rx_frames`
- 输出（建议强制标准化）
  - `/joint_states`（实时反馈，URDF语义）
  - `/cmd_joint_states`（命令态，便于双模型）
  - `/motor_feedback`（保留调试文本）
  - `/diagnostics`（总线/协议/保护状态）

### 5.2 参数分层建议

- `control_gains.yaml`
  - `kp` `kd` `default_velocity` `default_tau_ff`
- `calibration_profiles.yaml`
  - `joint_signs[12]` `joint_offsets_rad[12]` `joint_limits_*`
- `motor_map.yaml`
  - `joint -> motor_id -> can_bus`
- `bridge.yaml`
  - `rx_poll_ms` `tx_queue_max` `max_retry_per_frame`

---

## 6. 故障处理流向（建议）

```mermaid
flowchart TD
  A[运行中] --> B{检测异常}
  B -->|CAN超时/掉线| C[进入降级: 停止轨迹下发]
  B -->|越限/非法参数| D[截断并计数告警]
  B -->|电机故障位| E[触发急停流程]
  C --> F{恢复条件满足?}
  D --> F
  E --> G[失能并锁故障态]
  F -->|是| H[复位门禁后恢复]
  F -->|否| G
  H --> A
```

---

## 7. 与硬件平台匹配建议（RK3588S）

1. 进程部署
   - `can_transport_node` 与 `motor_protocol_node` 常驻，建议 systemd 级守护。
2. 资源隔离
   - 控制节点与可视化节点分组运行，避免 RViz 抢占实时链路。
3. 总线诊断
   - 保留 `can_transport_node` 5s 统计日志，作为现场首要健康指标。
4. 调参顺序
   - 先保守 `kp/kd` 与低速动作，再逐步提高动态性能。

---

## 8. 当前版本建议优先级（从功能性出发）

### P0（立即）

1. ~~完成反馈 JointState 发布~~：已实现 **`/joint_states_feedback`**（与标准 `/joint_states` 并存；字段扩展见 RQ-012）。
2. ~~在 launch 中明确真机 CAN~~：`trotbot_basic.launch.py` 使用 **`use_can_bridge`**；舵机路径由 **`use_servo_interface`** 控制（实机无刷常关）。
3. 增加最小安全门禁：反馈超时停止下发（可部分由 `motor_protocol` 步进限幅与门禁覆盖，独立 **safety_manager** 仍为 To-Be）。

### P1（短期）

1. ~~上/下电流程状态机节点化~~：**`power_sequence_node`** 已提供 Idle→Running、ProneHold、Disable 等。
2. ~~双模型 RViz~~：指令模型 + **`RobotModelFeedback`**（`/joint_states_feedback`，`fb/` TF）；`cmd_joint_states` 仍为可选增强。
3. 统一故障码与 `/diagnostics` 输出。

### P2（中期）

1. 安全管理独立成 `safety_manager_node`。
2. 形成自动化验收脚本（链路、方向、零位、故障注入）。

---

## 9. 架构相关关键文件索引

- 启动编排：`src/trotbot/launch/trotbot_basic.launch.py`（默认 `description_file=minidog_champ.urdf.xacro`、`gait_config_file=gait_minidog.yaml`）
- CHAMP 控制：`src/trotbot/launch/champ_controllers.launch.py`（同上默认，与 basic 传入一致）
- CAN bridge 启动：`src/trotbot_can_bridge/launch/can_bridge.launch.py`
- 协议节点：`src/trotbot_can_bridge/src/motor_protocol_node.cpp`
- 传输节点：`src/trotbot_can_bridge/src/can_transport_node.cpp`
- 上电状态机：`src/trotbot_can_bridge/src/power_sequence_node.cpp`
- 关节映射：`src/trotbot_can_bridge/include/trotbot_can_bridge/dog_mapper.hpp`
- 增益参数：`src/trotbot_can_bridge/config/control_gains.yaml`
- 启停与按键：`src/trotbot_can_bridge/config/power_sequence.yaml`
- 总线映射：`src/trotbot_can_bridge/config/motor_map.yaml`
- RViz 双模型：`src/trotbot/rviz/trotbot.rviz`

---

## 10. 备注

1. 本文档优先描述“可落地架构与演进路径”，目录级说明已弱化。
2. 如果你确认，我下一步可以直接补一版“节点接口契约表（消息字段级）”和“上/下电流程接口定义（service/action）”到本文件，便于直接进入开发。
