deep-diary/trotbot_ws/docs/README.md

# Workspace 文档总览

## 目录建议

- `docs/trotbot/`：TrotBot 项目核心文档（需求、架构、问题跟踪、运行指南入口）
- `docs/*.txt|*.cmd`：历史调试记录与临时脚本（建议后续按主题归档）

## TrotBot 文档入口

- `docs/trotbot/README.md`
- 根 `README.md` 的运行 / 调试专题已拆分到 `docs/trotbot/`：CAN 配置与报文调试、遥控与电源启停、CAN 桥架构与话题细节、CAN 频率与负载、模型重力前馈、部署与开机自启。
