deep-diary/trotbot_ws/docs/trotbot/部署与开机自启.md

# 部署与开机自启（systemd）

## 1) 改代码后：编译 + systemd 重启

`systemctl restart` 会按单元里的 `ExecStart` 重新跑一遍 `source install/setup.bash` 和 `ros2 launch …`，**前提是已把新代码编进 `install/`**。主栈包可只编到 `trotbot` 相关，避免工作区里 **minidog**（需 catkin）、**champ_gazebo**（需 Gazebo 依赖）等包导致全量 `colcon build` 失败：

```bash
cd ~/trotbot_ws
source /opt/ros/humble/setup.bash
colcon build --symlink-install --allow-overriding champ champ_msgs --packages-up-to trotbot trotbot_status_led trotbot_can_bridge trotbot_dynamics
sudo systemctl restart trotbot-basic
sudo systemctl status trotbot-basic --no-pager
# 可选：看启动日志
# journalctl -u trotbot-basic -b -e --no-pager
```

- 服务名以 `/etc/systemd/system/` 下实际 **`.service` 文件名** 为准（示例为 **`trotbot-basic`**）。若曾修改过 unit 文件，需先 **`sudo systemctl daemon-reload`** 再 **`restart`**。  
- 仅手跑 launch、**未**用 systemd 时，没有可 `restart` 的 unit，请用 `./main.sh restart` 或自行 `ros2 launch`。

## 2) 开机自启（systemd）

将示例单元复制为系统服务并修改 **`User`**、**`/home/bot/trotbot_ws`** 为你的账户与工作空间路径：

```bash
source /opt/ros/humble/setup.bash && source ~/trotbot_ws/install/setup.bash
sudo cp "$(ros2 pkg prefix trotbot)/share/trotbot/config/systemd/trotbot-basic.service.example" /etc/systemd/system/trotbot-basic.service
sudo nano /etc/systemd/system/trotbot-basic.service   # 改 User、WorkingDirectory、ExecStart 中的路径
sudo systemctl daemon-reload
sudo systemctl enable --now trotbot-basic.service
journalctl -u trotbot-basic.service -f
```

**灯带与 sudo**：`use_status_led:=true` 时，`status_led` 默认 **`sudo -E`** 启动灯节点；systemd 无交互终端，若未配置 **NOPASSWD**，请在 **`ExecStart` 同一行末尾**追加 **`status_led_use_sudo:=false`**（适用 **spidev** + 用户已在 **dialout** 等组）。详见 [`src/trotbot_status_led/README.md`](../../src/trotbot_status_led/README.md)。

**遥控**：无图形、无分配 TTY 时，键盘遥控无法像终端里一样使用；手柄需运行用户在 **`input`** 组。

## 3) `restart_trotbot_basic.sh`（已废弃，兼容保留）

脚本仍在原路径并可执行，但只是转发到 `trotbot_ctl.sh restart`（改为后台运行、带 PID/日志）。新操作请统一用 `./main.sh restart`。若由 **systemd** 管理整机启动，请优先用本文第 1 节，不要在机器上双起第二套 launch。
