deep-diary/trotbot_ws/docs/image/LubanCat-4-V1 pins.png

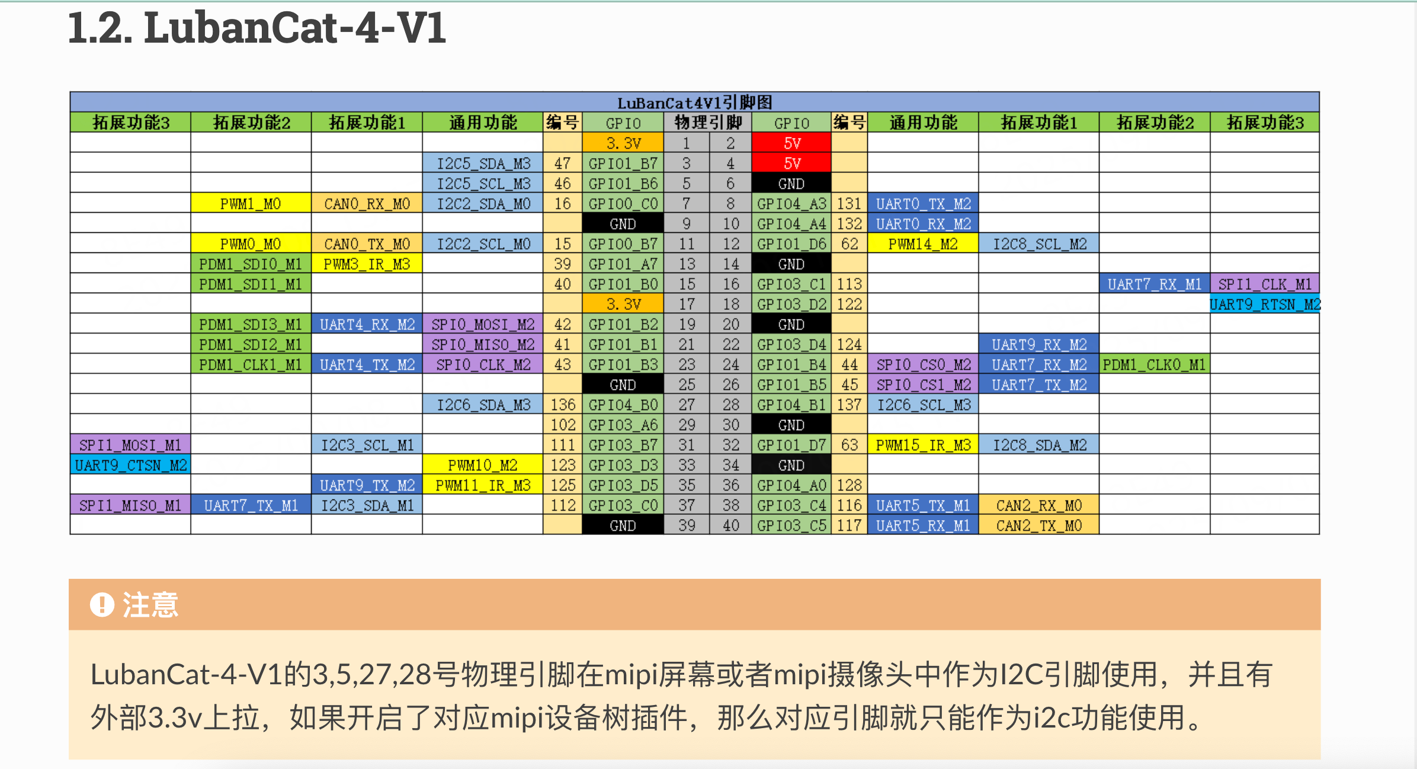
docs/image/LubanCat-4-V1 pins.png
