deep-diary/trotbot_ws/src/champ/champ_description/meshes/arm/wrist2.stl

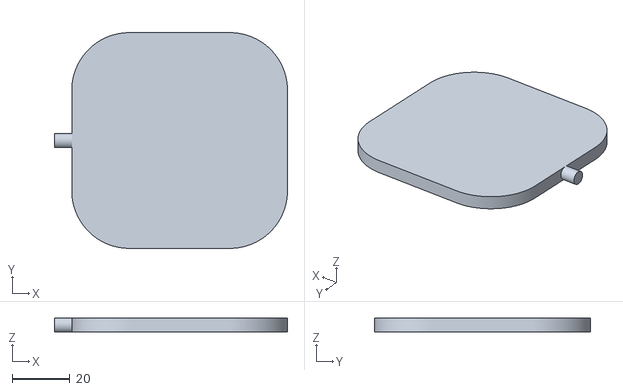
[picture p2: CAD file, 2026-04-12]
src/champ/champ_description/meshes/arm/wrist2.stl
81.0 x 75.0 x 5.00
