deep-diary/trotbot_ws/src/champ/champ_description/meshes/lower_leg_simple.stl

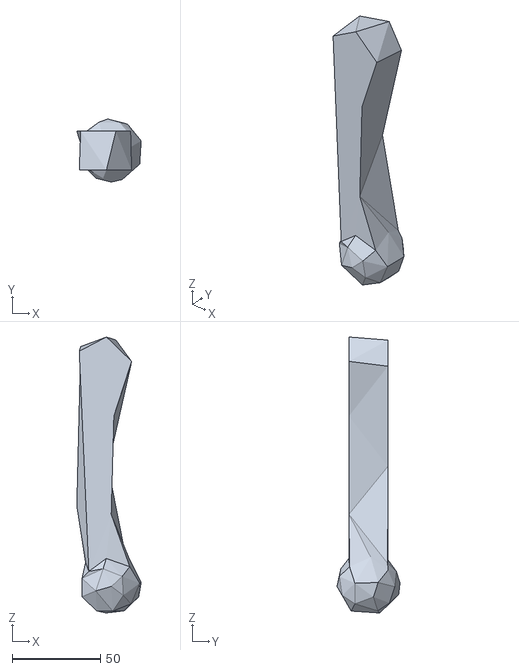
[picture p3: CAD file, 2026-04-12]
src/champ/champ_description/meshes/lower_leg_simple.stl
36.4 x 35.6 x 156.0
