deep-diary/trotbot_ws/src/minidog/meshes/lr_calf.STL

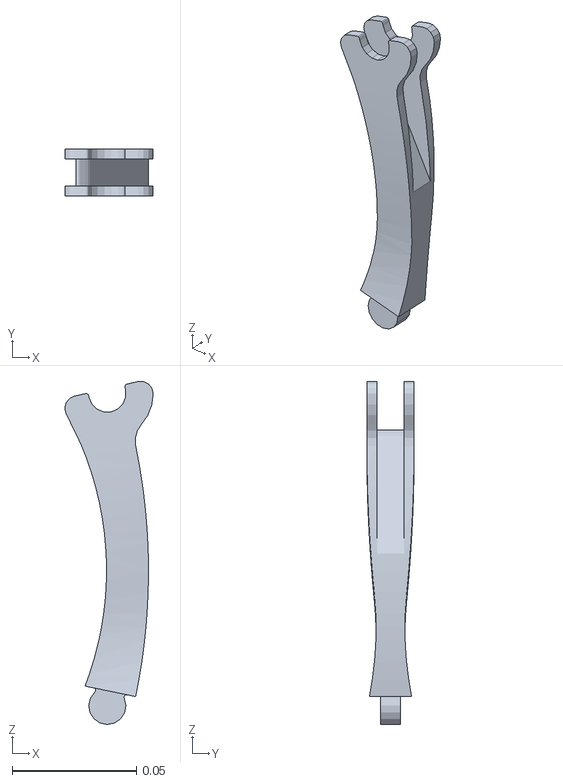
[picture p4: CAD file, 2026-04-12]
src/minidog/meshes/lr_calf.STL
0.0357 x 0.019 x 0.138
