deep-diary/trotbot_ws/src/trotbot/meshes/minidog/base_head.STL

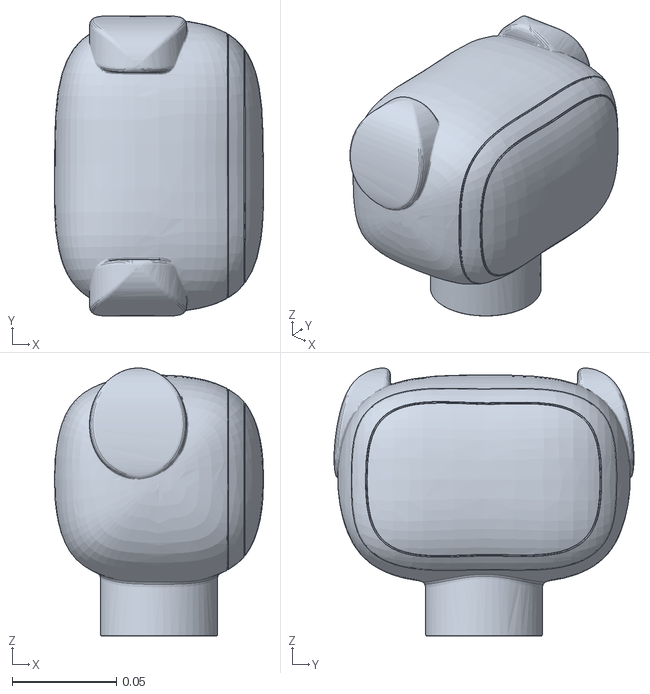
[picture p5: CAD file, 2026-11-03]
src/trotbot/meshes/minidog/base_head.STL
0.1 x 0.144 x 0.128
