deep-diary/trotbot_ws/src/trotbot/meshes/trotbot/rf2.STL

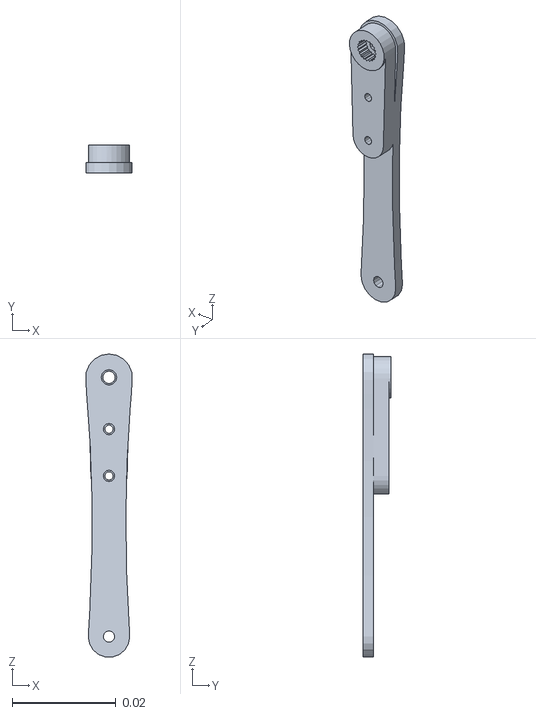
[picture p6: CAD file, 2026-04-12]
src/trotbot/meshes/trotbot/rf2.STL
0.00894 x 0.0054 x 0.0584
