deep-diary/trotbot_ws/src/champ/champ_description/meshes/arm/wrist1.stl

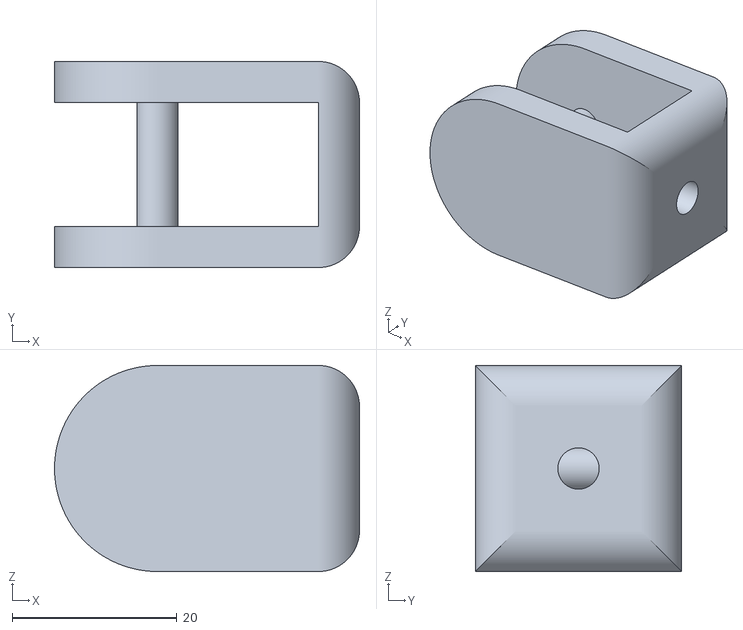
[picture p7: CAD file, 2026-04-12]
src/champ/champ_description/meshes/arm/wrist1.stl
37.0 x 25.0 x 25.0
