deep-diary/trotbot_ws/src/champ/champ_description/meshes/upper_leg_simple.stl

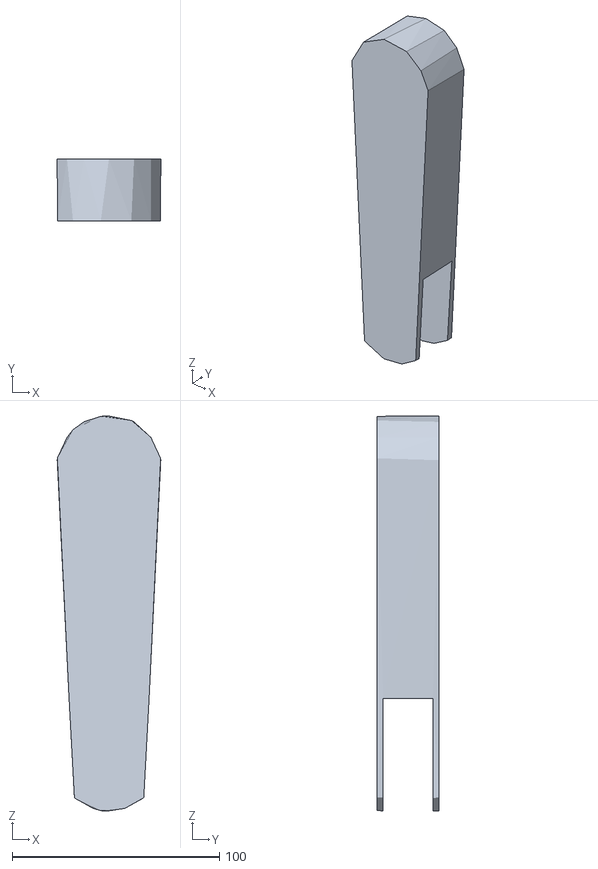
[picture p8: CAD file, 2026-04-12]
src/champ/champ_description/meshes/upper_leg_simple.stl
50.0 x 30.0 x 190.6
