deep-diary/trotbot_ws/src/trotbot/meshes/minidog/base_body.STL

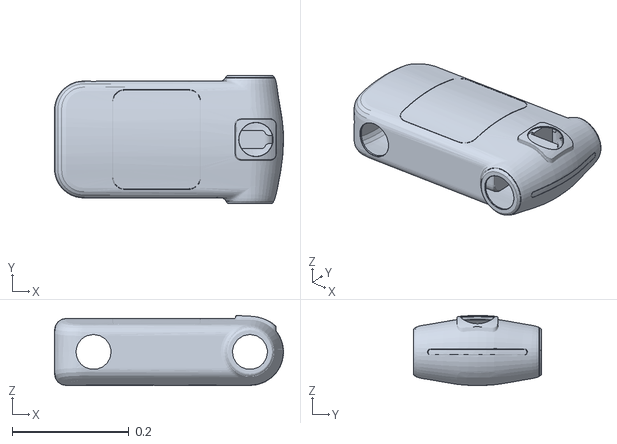
[picture p9: CAD file, 2026-11-03]
src/trotbot/meshes/minidog/base_body.STL
0.392 x 0.22 x 0.12
