deep-diary/trotbot_ws/src/trotbot/meshes/trotbot/rpf1.STL

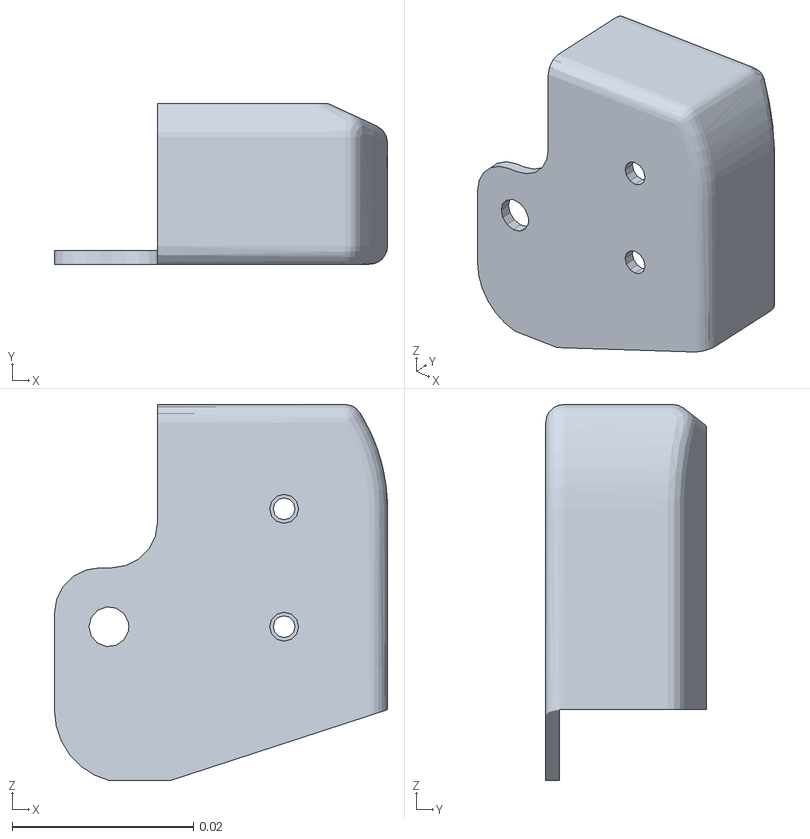
[picture p10: CAD file, 2026-04-12]
src/trotbot/meshes/trotbot/rpf1.STL
0.0367 x 0.0177 x 0.0415
