deep-diary/trotbot_ws/src/champ/champ_description/meshes/arm/lower_arm.stl

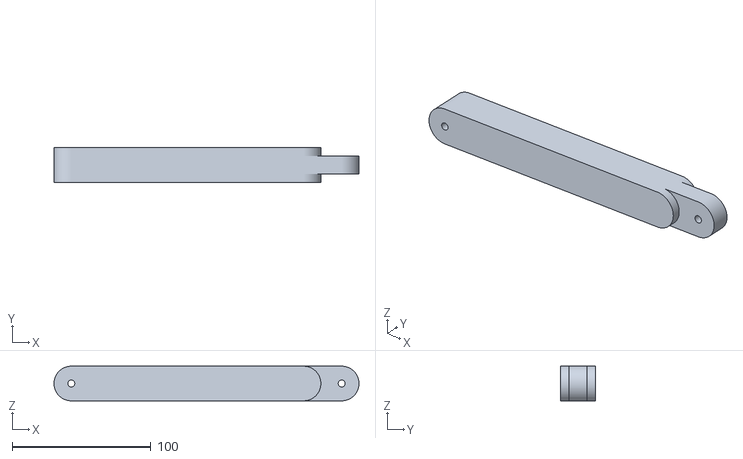
[picture p11: CAD file, 2026-04-12]
src/champ/champ_description/meshes/arm/lower_arm.stl
220.0 x 25.0 x 25.0
