deep-diary/trotbot_ws/src/champ/champ_description/meshes/lower_leg.stl

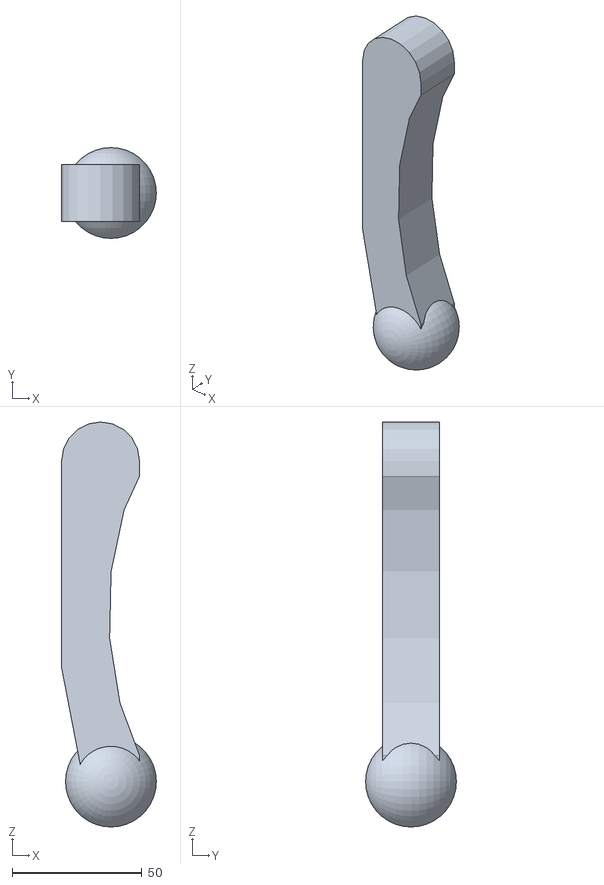
[picture p12: CAD file, 2026-04-12]
src/champ/champ_description/meshes/lower_leg.stl
36.5 x 35.0 x 156.0
