deep-diary/trotbot_ws/src/minidog/meshes/lr_hip.STL

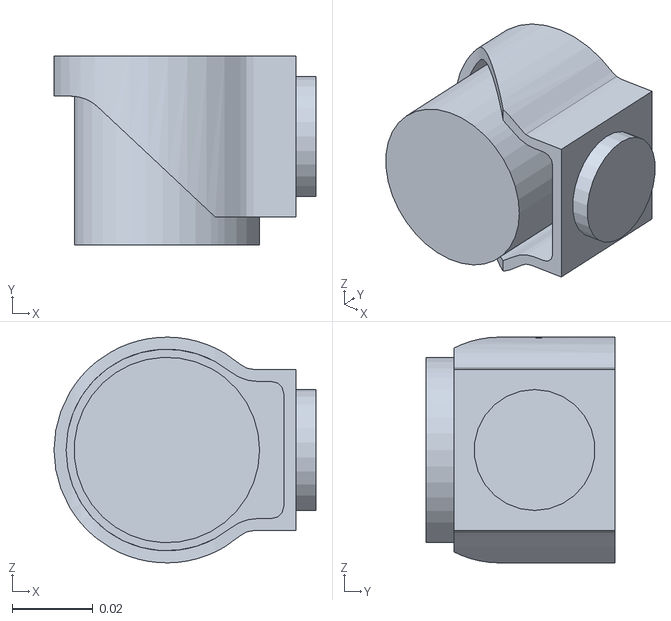
[picture p13: CAD file, 2026-04-12]
src/minidog/meshes/lr_hip.STL
0.065 x 0.047 x 0.056
