deep-diary/trotbot_ws/src/trotbot/meshes/minidog/lf_thigh.STL

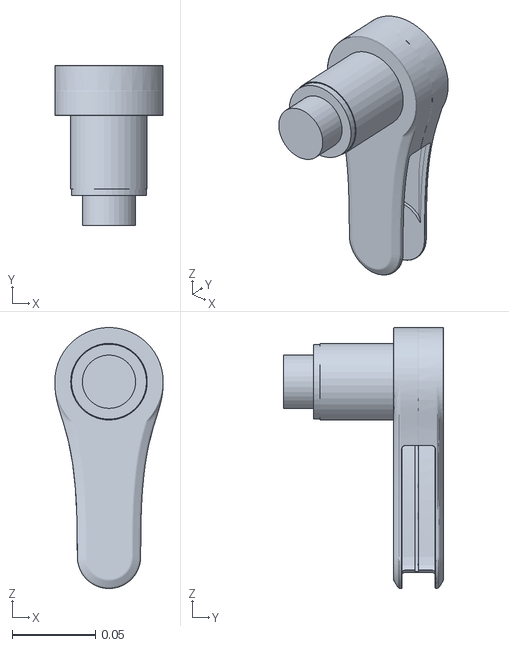
[picture p14: CAD file, 2026-04-12]
src/trotbot/meshes/minidog/lf_thigh.STL
0.065 x 0.096 x 0.156
