deep-diary/trotbot_ws/src/trotbot/meshes/minidog/base.STL

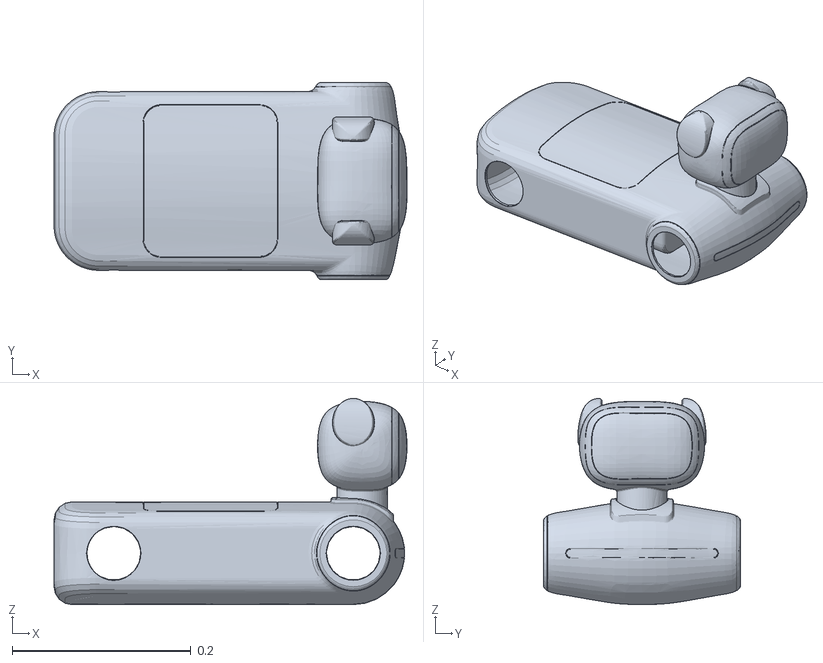
[picture p16: CAD file, 2026-04-12]
src/trotbot/meshes/minidog/base.STL
0.395 x 0.22 x 0.231
