deep-diary/trotbot_ws/src/trotbot/meshes/trotbot/rf3.STL

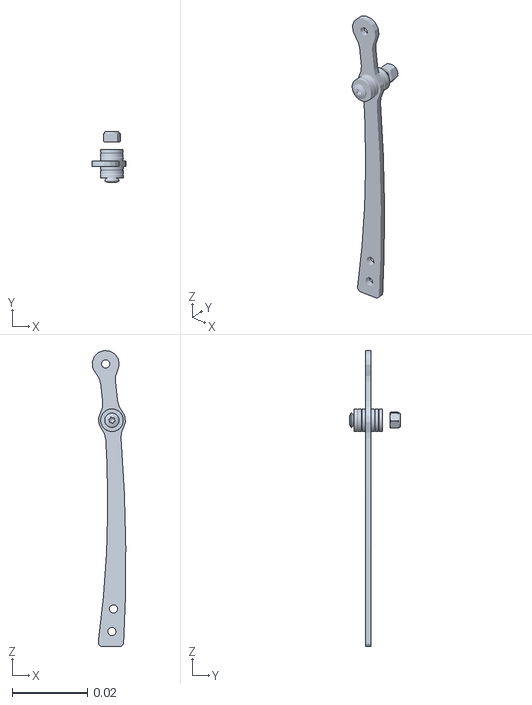
[picture p17: CAD file, 2026-04-12]
src/trotbot/meshes/trotbot/rf3.STL
0.0089 x 0.0136 x 0.0784
