deep-diary/trotbot_ws/src/champ/champ_description/meshes/arm/base.stl

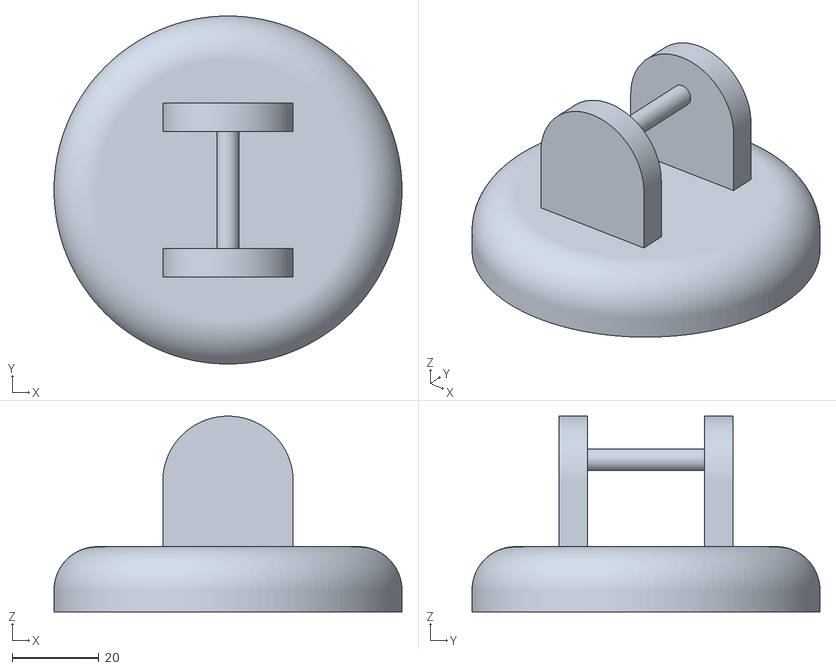
[picture p18: CAD file, 2026-04-12]
src/champ/champ_description/meshes/arm/base.stl
80.0 x 80.0 x 45.0
