deep-diary/trotbot_ws/src/champ/champ_description/meshes/hip.stl

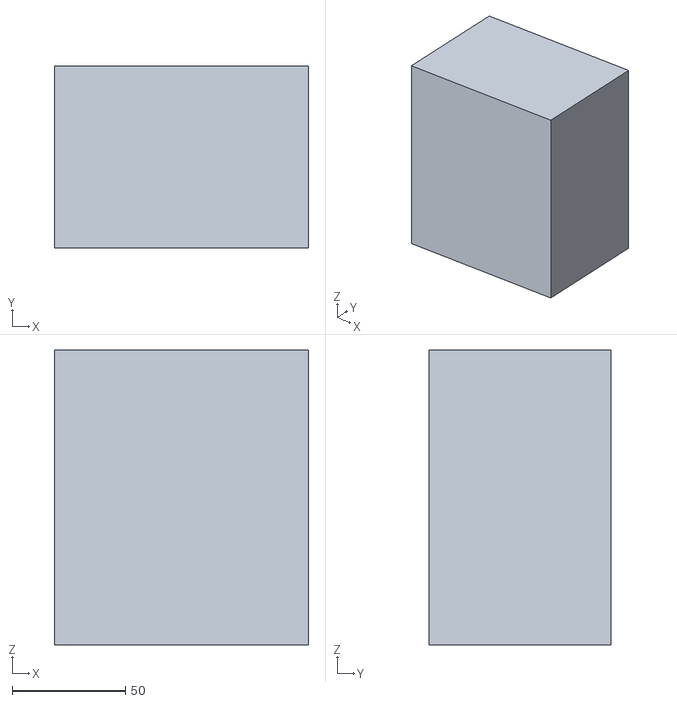
[picture p19: CAD file, 2026-04-12]
src/champ/champ_description/meshes/hip.stl
112.0 x 80.0 x 130.0
