deep-diary/trotbot_ws/src/trotbot/meshes/minidog/rr_foot.STL

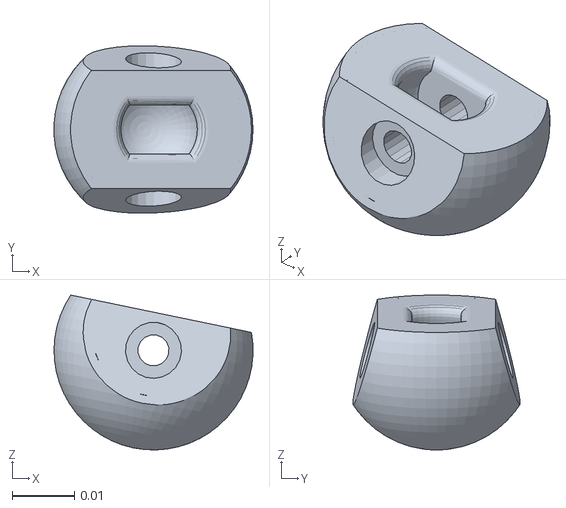
[picture p20: CAD file, 2026-04-12]
src/trotbot/meshes/minidog/rr_foot.STL
0.032 x 0.0269 x 0.0249
