deep-diary/trotbot_ws/src/trotbot/meshes/trotbot/rffoot.STL

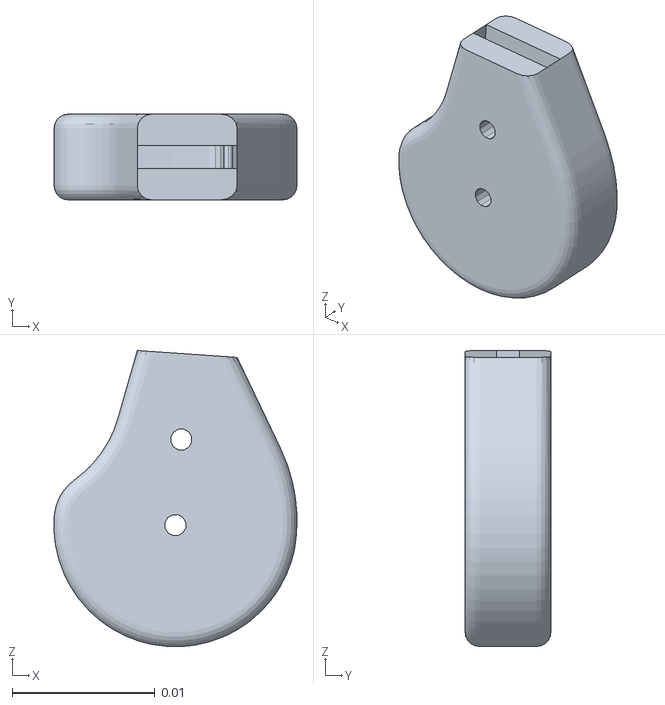
[picture p21: CAD file, 2026-04-12]
src/trotbot/meshes/trotbot/rffoot.STL
0.017 x 0.006 x 0.0207
