deep-diary/trotbot_ws/src/champ/champ_description/meshes/base_simple.stl

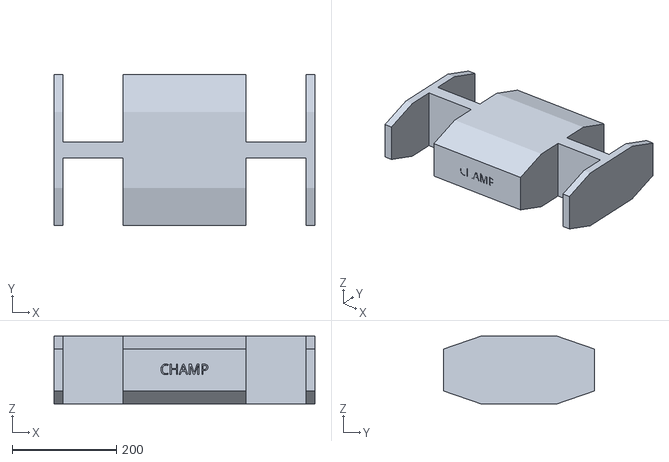
[picture p22: CAD file, 2026-04-12]
src/champ/champ_description/meshes/base_simple.stl
500.0 x 290.0 x 130.0
