deep-diary/trotbot_ws/src/trotbot/meshes/trotbot/rb1.STL

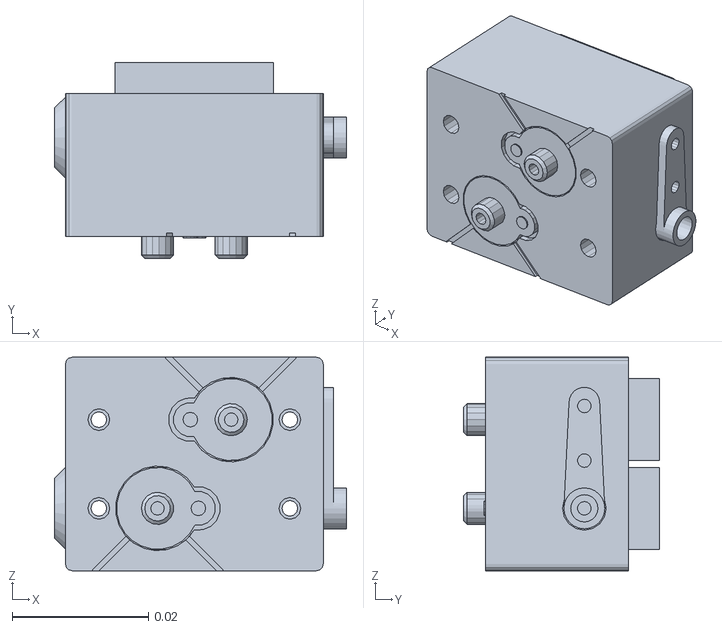
[picture p23: CAD file, 2026-04-12]
src/trotbot/meshes/trotbot/rb1.STL
0.0428 x 0.0287 x 0.0313
