deep-diary/trotbot_ws/src/trotbot/meshes/trotbot/lidar.STL

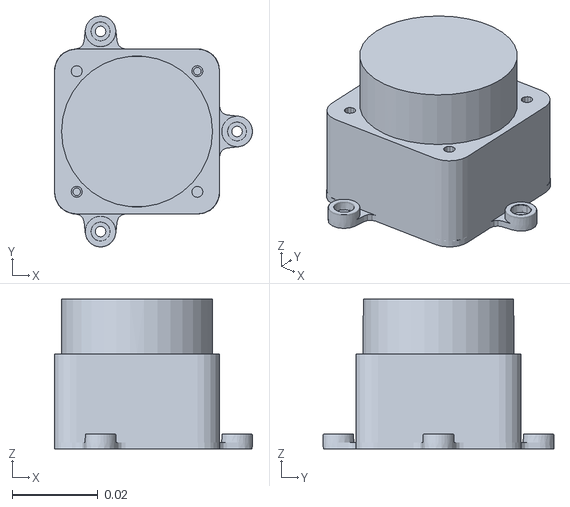
[picture p24: CAD file, 2026-04-12]
src/trotbot/meshes/trotbot/lidar.STL
0.0463 x 0.054 x 0.035
