deep-diary/trotbot_ws/src/trotbot/meshes/trotbot/rpf2.STL

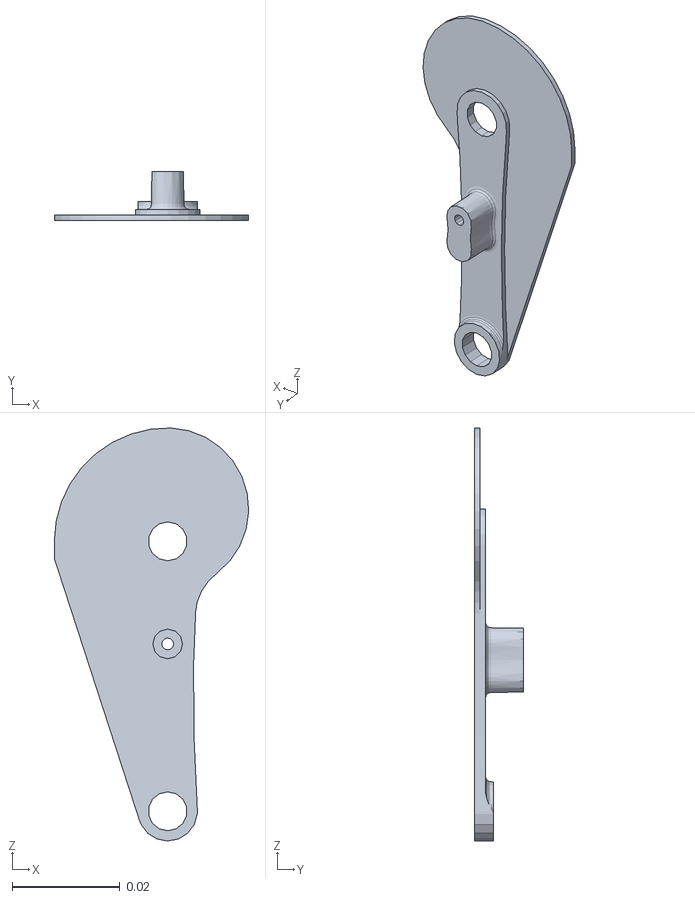
[picture p25: CAD file, 2026-04-12]
src/trotbot/meshes/trotbot/rpf2.STL
0.036 x 0.009 x 0.0765
