deep-diary/trotbot_ws/src/trotbot/meshes/trotbot/base_link.STL

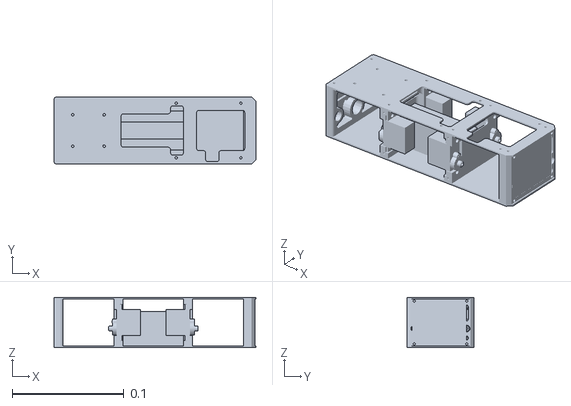
[picture p26: CAD file, 2026-04-12]
src/trotbot/meshes/trotbot/base_link.STL
0.181 x 0.06 x 0.045
