deep-diary/trotbot_ws/src/trotbot/meshes/trotbot/yellow_plate.STL

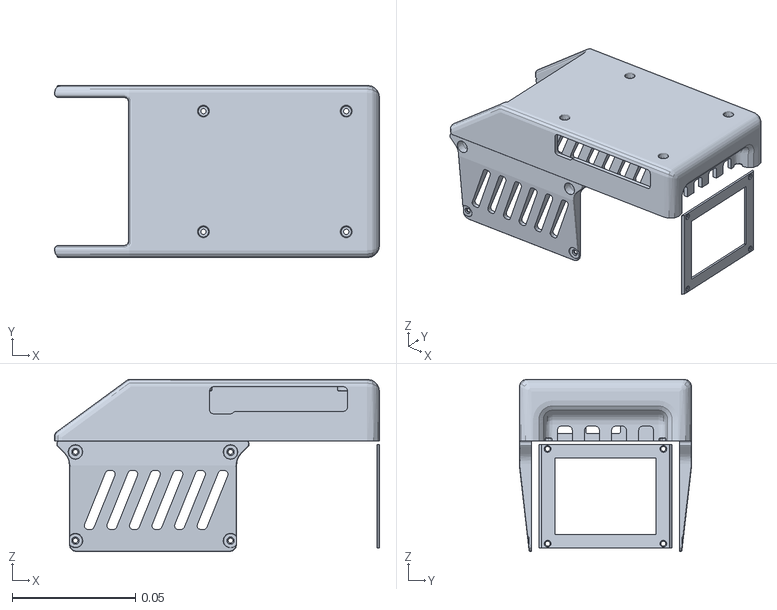
[picture p27: CAD file, 2026-04-12]
src/trotbot/meshes/trotbot/yellow_plate.STL
0.132 x 0.07 x 0.07
