deep-diary/trotbot_ws/src/trotbot/meshes/trotbot/plug_collision.stl

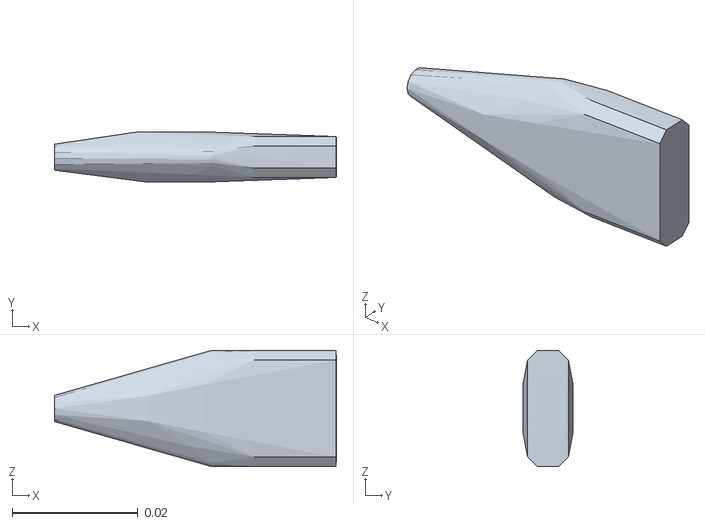
[picture p28: CAD file, 2026-04-12]
src/trotbot/meshes/trotbot/plug_collision.stl
0.0448 x 0.008 x 0.0185
