deep-diary/trotbot_ws/src/trotbot/meshes/trotbot/plug.stl

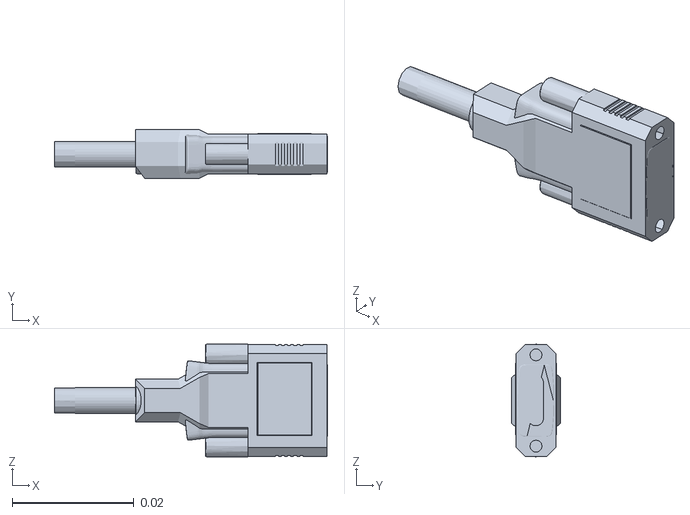
[picture p29: CAD file, 2026-04-12]
src/trotbot/meshes/trotbot/plug.stl
0.0448 x 0.008 x 0.0185
