deep-diary/trotbot_ws/(list of files, cad)

Other CAD files:
src/minidog/meshes/rr_calf.STL
src/trotbot/meshes/trotbot/rb2.STL
src/champ/champ_description/meshes/upper_leg.stl
src/minidog/meshes/rf_thigh.STL
src/minidog/meshes/lf_foot.STL
src/trotbot/meshes/minidog/rr_calf.STL
src/champ/champ_description/meshes/base.stl
src/minidog/meshes/lf_hip.STL
src/minidog/meshes/lf_calf.STL
src/trotbot/meshes/minidog/rr_hip.STL
src/minidog/meshes/rr_hip.STL
src/trotbot/meshes/minidog/lf_foot.STL
src/trotbot/meshes/trotbot/lpb2.STL
src/trotbot/meshes/trotbot/lb1.STL
src/trotbot/meshes/minidog/lf_calf.STL
src/trotbot/meshes/trotbot/lf3.STL
src/minidog/meshes/rf_calf.STL
src/trotbot/meshes/trotbot/lpb1.STL
src/minidog/meshes/rf_hip.STL
src/trotbot/meshes/minidog/rr_thigh.STL
src/trotbot/meshes/trotbot/lf1.STL
src/trotbot/meshes/minidog/lf_hip.STL
src/trotbot/meshes/trotbot/lb2.STL
src/trotbot/meshes/minidog/lr_thigh.STL
src/trotbot/meshes/trotbot/lffoot.STL
src/minidog/meshes/lr_thigh.STL
src/trotbot/meshes/minidog/rf_calf.STL
src/trotbot/meshes/trotbot/lpf1.STL
src/minidog/meshes/rr_thigh.STL
src/trotbot/meshes/minidog/rf_thigh.STL
src/trotbot/meshes/trotbot/rpb2.STL
src/trotbot/meshes/minidog/rf_hip.STL
src/trotbot/meshes/trotbot/rpb1.STL
src/trotbot/meshes/trotbot/rf1.STL
src/trotbot/meshes/trotbot/lbfoot.STL
src/trotbot/meshes/trotbot/lb3.STL
src/trotbot/meshes/trotbot/lpf2.STL
src/trotbot/meshes/trotbot/rb3.STL
src/trotbot/meshes/trotbot/lf2.STL
src/trotbot/meshes/trotbot/rbfoot.STL
