deep-diary/trotbot_ws/docs/image/LubanCat-4-V1 pins usage.jpg

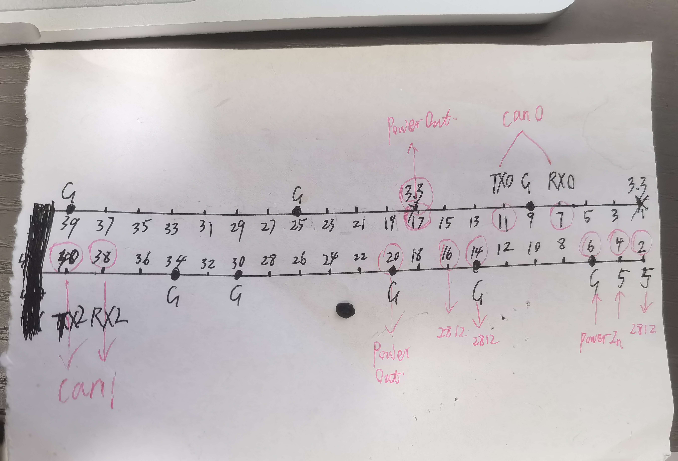
docs/image/LubanCat-4-V1 pins usage.jpg
