deep-diary/trotbot_ws/src/trotbot_can_bridge/config/control_gains.yaml

/**:
  ros__parameters:
    kp: 100.0
    kd: 4.0
    default_velocity: 0.0
    default_tau_ff: 0.0

    # --- 规划位置差分速度前馈：v_ff = clamp(scale * d/dt(q_cmd), ±velocity_ff_max_rad_s) ---
    # q_cmd 为平滑后实际下发的 CHAMP 关节角，v_ff 按 joint_signs 映射到 MIT 域后填入 MIT velocity 字段；
    # 关闭时 velocity 字段仍为 default_velocity，行为与旧版完全一致
    enable_velocity_ff: true
    # 整体比例系数（1.0=直接用差分速度；0.7 更保守）
    velocity_ff_scale: 0.7
    # 电机侧绝对上限（rad/s，MIT 编码再受 ProtocolCodec::kVMax(50) 约束）
    velocity_ff_max_rad_s: 6.0
    # 一阶低通截止频率（Hz），<=0 关闭滤波；CHAMP 指令约 50Hz，建议 8~15（上游 200Hz 时可用 15~25）
    velocity_ff_lpf_hz: 10.0
    # 是否把 dq_ff 填进 /mit_motor_position_rad 的 velocity 字段（验证/绘图用）
    publish_velocity_ff: true
    # 运行时在线联调（std_msgs/String，key=value 空格分隔）默认话题：
    #   /mit_gains_cmd
    # 示例：
    #   scope=all kp=50 kd=2.5
    #   scope=rear tau=0.6
    #   reset=1
    runtime_tune_topic: /mit_gains_cmd
    # 临时总线发送开关：用于定位前后腿卡顿来源（true=允许发送）
    tx_enable_can0: true
    tx_enable_can1: true
    # 每电机最小发送刷新（秒）：防止个别电机因上游/调度抖动长期低频
    enable_min_tx_refresh: true
    min_tx_refresh_interval_s: 0.02
    # 每电机最大发送频率上限（Hz）：防止个别链路异常高频挤占总线
    # 与 CHAMP loop_rate=200Hz 对齐；过低会导致大量 skip_max_rate、有效命令过低频
    enable_max_tx_rate_limit: true
    max_tx_rate_per_motor_hz: 200.0
    # /can_tx_frames 与 can_transport 订阅端一致：Reliable + 足够深度，避免 DDS 丢帧造成假 bus 失衡
    can_tx_frames_qos_depth: 4000
    # 启动流程门禁：true 时，需收到 /power_sequence/gate_open=true 才会透传轨迹发送
    enable_power_sequence_gate: true
    power_sequence_gate_topic: /power_sequence/gate_open

    # 发布反馈关节角（CHAMP/URDF 关节语义，便于 RViz 对比期望 vs 实际）
    publish_feedback_joint_states: true
    feedback_joint_states_topic: /joint_states_feedback
    # 定时发布反馈 JointState（Hz）；与 CAN 帧解耦，门禁未开/无总线反馈时仍供 RViz robot_state_publisher_feedback 用。≤0 则关闭定时器（不推荐）。
    feedback_joint_states_timer_hz: 50.0
    # --- RQ-012：JointState.velocity（rad/s CHAMP 语义）、effort（Nm，EL05 电机报告力矩，与 MIT tau 同号约定）---
    publish_feedback_velocity_effort: true
    # true：尚未收到该关节反馈时 velocity/effort 填 NaN；false：填 0（慎用：RViz 部分插件对 NaN 不友好时可将此项设为 false）
    feedback_joint_fill_nan: true
    # RQ-012 可选：模式字 / 温度 / 离散故障位 → diagnostic_msgs/DiagnosticArray（不经字符串日志）
    # 供 ds4_feedback_node 检测电机故障（手柄红灯双闪 + 双震）；如无需求可改回 false
    publish_motor_diagnostics: true
    motor_diagnostics_topic: /diagnostics

    # --- RQ-022：MIT 帧 tau_ff = Clamp(runtime_tau_bus + gravity_ff_scale * tau_ff_nominal_nm[i], kTMin, kTMax) ---
    # runtime_tau_bus 仍来自 default_tau_ff + /mit_gains_cmd 按前后总线（can0/can1）在线调节。
    enable_joint_tau_ff: false
    gravity_ff_scale: 0.5
    # 顺序同 DogMapper::kChampJointNames（base_lf1…）；符号与 EL05/MIT 一致；不经 joint_signs 二次取反
    # 站立实测：约 8s、120 帧 `effort` 均值（仅作前馈初值；左右/前后不对称来自载荷与标定，属常见现象）
    tau_ff_nominal_nm: [0.100772, 0.150262, -0.635247, -0.055963, -0.044155, 0.919803, -0.154716, -0.476715, -1.278698, 0.220113, 0.171255, 1.020762]

    # --- RQ-025：Pinocchio 定基重力前馈（默认关闭）---
    # off=不启用；replace=用模型前馈替代查表；add=模型+查表叠加（注意双计重力）
    pinocchio_tau_ff_mode: "replace"
    pinocchio_tau_ff_topic: /model_tau_ff
    # 2026-11-05 悬空标定（720 静态样本）：
    #   tau_signs 与拟合符号一致（未改）；大腿可信增益≈1.0，左后大腿 0.65；
    #   髋关节行程不足无法辨识斜率，按静态力矩比值取 0.4；小腿受摩擦影响取保守 0.5。
    pinocchio_tau_ff_scale: 1.0
    pinocchio_tau_ff_gain: [0.4, 1.0, 0.5, 0.4, 1.0, 0.5, 0.4, 0.65, 0.5, 0.4, 1.0, 0.5]
    pinocchio_tau_ff_timeout_s: 0.2
    pinocchio_tau_ff_ramp_s: 1.0
    # URDF τ -> 电机 τ_cmd 的符号（初值同 joint_signs；必须做静力/对拉验证后固化，勿只依赖位置符号）
    tau_signs: [-1.0, -1.0, -1.0, -1.0, 1.0, 1.0, 1.0, -1.0, -1.0, 1.0, 1.0, 1.0]

    # 启动平滑与发送限速（减少趴姿->站立突变）
    enable_startup_smoothing: true
    startup_smoothing_duration_s: 3.0
    command_max_velocity_rad_s: 1.0
    # true: 仅在启动/使能后的平滑窗口内执行速度限幅；稳态步态不再持续压幅
    limit_velocity_only_during_smoothing: true

    # 电机模式上升沿（Reset/Cali -> Motor）触发平滑锚点重置
    # 规格书反馈模式：0=Reset, 1=Cali, 2=Motor
    # 上电不再发 MIT p=0：使能瞬间把平滑锚点重置为当前实际反馈角，避免按启动前的旧锚点插值
    enable_mode_rising_smoothing: true
    motor_enabled_mode_status: 2

    # 基于“当前位置反馈”的阈值步进发送（避免大步阶直接冲击）
    # 当 |target - feedback| > feedback_step_limit_rad 时，只发送 feedback ± threshold
    enable_feedback_step_limit: false
    feedback_step_limit_rad: 2.0
    feedback_fresh_timeout_s: 0.30

    # 发送前关节限位（CHAMP/URDF 关节域，单位 rad，顺序同 joint_signs/joint_offsets）
    # 来源：config/minidog position.jpg 的“运动范围(URDF零位)”。
    # 每腿范围：hip[-0.17444, +0.17444] thigh[-2.6167, +2.6167] calf[-2.5469, -0.4884]
    use_joint_cmd_limits: true
    joint_cmd_min_rad: [-0.17444, -2.6167, -2.5469, -0.17444, -2.6167, -2.5469, -0.17444, -2.6167, -2.5469, -0.17444, -2.6167, -2.5469]
    joint_cmd_max_rad: [0.17444, 2.6167, -0.4884, 0.17444, 2.6167, -0.4884, 0.17444, 2.6167, -0.4884, 0.17444, 2.6167, -0.4884]

    # 电机域（MIT角）显式限位（单位 rad）
    # use_motor_domain_limits=true 时生效。
    # derive_motor_limits_from_joint_cmd=true：按 θ_mit=sign*θ_champ+offset 从 joint_cmd_* 自动推导（推荐）
    # derive_motor_limits_from_joint_cmd=false：使用下面 joint_mit_* 显式数组（线性硬限位）
    use_motor_domain_limits: true
    derive_motor_limits_from_joint_cmd: true
    joint_mit_min_rad: [-12.57, -12.57, -12.57, -12.57, -12.57, -12.57, -12.57, -12.57, -12.57, -12.57, -12.57, -12.57]
    joint_mit_max_rad: [12.57, 12.57, 12.57, 12.57, 12.57, 12.57, 12.57, 12.57, 12.57, 12.57, 12.57, 12.57]
    # 若需使用实测机械限位（src/trotbot/hal/ref/dog/README.md 表 56-73）：
    # derive_motor_limits_from_joint_cmd: false
    # joint_mit_min_rad: [-0.3, -0.6, -2.26, -0.3, -1.4, 0.0, -0.3, -0.6, -2.26, -0.3, -1.4, 0.0]
    # joint_mit_max_rad: [0.3, 1.4, 0.0, 0.3, 0.6, 2.26, 0.3, 1.4, 0.0, 0.3, 0.6, 2.26]
    # 仅控制 RX 解码字符串话题与 INFO 日志；为 false 时仍会解析反馈并发布 /joint_states_feedback（供 RViz RobotModelFeedback）
    enable_rx_decode_log: true
    prefer_joint_name_mapping: true
    # 观测：motor_protocol 发布 /mit_motor_position_rad (sensor_msgs/JointState)，position 为 MIT 帧内弧度 θ_mit=sign*θ_champ+offset；name 与 CHAMP 关节名同序。电机 ID 11–63 见 dog_mapper 注释。
    # publish_mit_mapped_positions: true
    # mit_mapped_positions_topic: /mit_motor_position_rad
    # --- 关节方向 / 零位（与 motor_protocol_node 一致）---
    # joint_signs: 仅 ±1，表示 URDF/CHAMP 正方向与电机指令正方向是否一致（标定得出，勿填 0）。
    # joint_offsets_rad: θ_mit = joint_signs[i] * θ_champ[i] + joint_offsets_rad[i]
    #
    # 若将「趴姿」作为电机 EL05 机械零位（该姿态下电机读数为 0），并希望 CHAMP 仍用 URDF 关节角 θ：
    #   在**同一趴姿**下录制 /joint_group_effort_controller/joint_trajectory 的 positions[0..11]（记 θ_prone），则
    #     joint_offsets_rad[i] = - joint_signs[i] * θ_prone[i]
    #   之后任意指令 θ 时：θ_mit = joint_signs[i] * (θ[i] - θ_prone[i])，即电机侧为「相对趴姿」的角。
    # **不可**仅用站立姿态一条轨迹推算 θ_prone；站立数据只能用于核对步态，不能代替趴姿采样。
    # minidog URDF 小腿限位为负区间时，θ=0 往往不在限位内，勿假设「趴姿 = URDF 全 0」。
    #
    # 顺序（与 joints.yaml / JointTrajectory）：base_lf1, lf1_lf2, lf2_lf3 | base_rf1, rf1_rf2, rf2_rf3 |
    #   base_lb1, lb1_lb2, lb2_lb3 | base_rb1, rb1_rb2, rb2_rb3
    #
    # 站立参考（仅记录，不代入 offset；来自 CHAMP 实测）：每腿约 hip≈0, thigh≈0.578, calf≈-1.051
    joint_signs: [-1.0, -1.0, -1.0, -1.0, 1.0, 1.0, 1.0, -1.0, -1.0, 1.0, 1.0, 1.0]

    # --- 镜像展开：四腿 hip/thigh/calf 幅值对称，只需改下面 3 个数 ---
    # expand_joint_offsets_from_mirror=true 时，节点启动后用下面三数重算 joint_offsets_rad。
    # 也就是说：运行时以 joint_offset_hip_rad / thigh / calf 为准；joint_offsets_rad 主要用于记录与人工核对。
    # 生成规则（与 DogMapper LF|RF|LH|RH × [hip,thigh,calf] 一致）：
    #   LF: +hip, +thigh, -calf_mag | RF: -hip, -thigh, +calf_mag
    #   LH: -hip, +thigh, -calf_mag | RH: +hip, -thigh, +calf_mag
    # calf 填**正数**幅值（小腿偏移在 LF/LH 为负，RF/RH 为正）。
    # 2026-11-05 站立平衡试验：后膝 CHAMP 域 -0.02 rad 在“控制器暂停、同一 base 姿态”下
    # 可把 53:-0.70/63:+0.81 降到 53:-0.59/63:+0.52；但直接改 joint_offsets_rad 会同时改变
    # 反馈映射与站姿，整机复测不可重复，故先恢复镜像展开，后续应在“后腿指令侧”加偏移。
    expand_joint_offsets_from_mirror: true
    # 场景B（备用）：装外壳、外壳触地时，4个髋关节相对“水平零位”会上翘
    # 该场景下 hip 通常采用 0.17444（示例值），thigh/calf 与当前一致
    # joint_offset_hip_rad: 0.17444
    # joint_offset_thigh_rad: 1.0031
    # joint_offset_calf_rad: 2.5469
    # joint_offsets_rad: [0.17444, 1.0031, -2.5469, -0.17444, -1.0031, 2.5469, -0.17444, 1.0031, -2.5469, 0.17444, -1.0031, 2.5469]

    # 场景A（当前生效）：未装外壳，底部垫高使机身保持水平后执行 set_zero
    # 该场景下 URDF 髋关节零位与电机零位重合，因此 hip=0.0
    # 注意：须写 0.0，勿写 0，否则 ROS 2 参数类型会变成 integer
    joint_offset_hip_rad: 0.0
    joint_offset_thigh_rad: 1.0031
    joint_offset_calf_rad: 2.5469

    # 由上行三数按镜像规则展开的 12 维（LF|RF|LH|RH × hip/thigh/calf）。
    # 场景A（hip=0.0）对应：
    joint_offsets_rad: [0.0, 1.0031, -2.5469, -0.0, -1.0031, 2.5469, -0.0, 1.0031, -2.5469, 0.0, -1.0031, 2.5469]
    # 指令侧静态补偿（CHAMP 域，12 维）：只加在下发目标，不改变反馈映射/零位。
    # 2026-11-05 真机站立（无泡沫、四腿着地）动态整定：
    #   13:+0.01  23:-0.02  53:-0.01  63:-0.035
    #   四膝力矩约 0.51 / 0.68 / 0.85 / 0.76 Nm，左右基本拉平（~1.06），后/前约 1.35。
    joint_cmd_offsets_rad: [0.0, 0.0, 0.01, 0.0, 0.0, -0.02, 0.0, 0.0, -0.01, 0.0, 0.0, -0.035]
    # 场景B（hip=0.17444）参考：
    # joint_offsets_rad: [0.17444, 1.0031, -2.5469, -0.17444, -1.0031, 2.5469, -0.17444, 1.0031, -2.5469, 0.17444, -1.0031, 2.5469]
