deep-diary/trotbot_ws/src/trotbot_can_bridge/src/motor_protocol_node.cpp

#include <algorithm>
#include <array>
#include <cctype>
#include <cmath>
#include <functional>
#include <limits>
#include <memory>
#include <sstream>
#include <string>
#include <unordered_map>
#include <vector>

#include "diagnostic_msgs/msg/diagnostic_array.hpp"
#include "diagnostic_msgs/msg/diagnostic_status.hpp"
#include "diagnostic_msgs/msg/key_value.hpp"
#include "rcl_interfaces/msg/set_parameters_result.hpp"
#include "rclcpp/node_interfaces/node_parameters_interface.hpp"
#include "rclcpp/rclcpp.hpp"
#include "sensor_msgs/msg/joint_state.hpp"
#include "std_msgs/msg/bool.hpp"
#include "std_msgs/msg/string.hpp"
#include "std_msgs/msg/u_int8_multi_array.hpp"
#include "trajectory_msgs/msg/joint_trajectory.hpp"
#include "trotbot_can_bridge/dog_mapper.hpp"
#include "trotbot_can_bridge/frame_codec.hpp"
#include "trotbot_can_bridge/protocol_codec.hpp"

using diagnostic_msgs::msg::DiagnosticArray;
using diagnostic_msgs::msg::DiagnosticStatus;
using diagnostic_msgs::msg::KeyValue;
using trajectory_msgs::msg::JointTrajectory;
using sensor_msgs::msg::JointState;
using std_msgs::msg::Bool;
using std_msgs::msg::String;
using std_msgs::msg::UInt8MultiArray;

namespace trotbot_can_bridge
{

/// CHAMP 顺序：LF | RF | LH | RH，每腿 hip / thigh / calf；四腿关于机体镜像，偏移可由三个幅值生成：
/// LF(+h,+t,-c) RF(-h,-t,+c) LH(-h,+t,-c) RH(+h,-t,+c)，与 DogMapper::kTemporaryIndexMap 索引一致。
static std::vector<double> BuildMirrorJointOffsetsRad(double hip, double thigh, double calf_mag)
{
  return {
    hip, thigh, -calf_mag,
    -hip, -thigh, calf_mag,
    -hip, thigh, -calf_mag,
    hip, -thigh, calf_mag};
}

enum class TuneScope
{
  ALL = 0,
  FRONT = 1,
  REAR = 2
};

static std::string ToLower(std::string v)
{
  std::transform(v.begin(), v.end(), v.begin(), [](unsigned char c) {return static_cast<char>(std::tolower(c));});
  return v;
}

static std::vector<std::string> SplitTokens(const std::string & text)
{
  std::istringstream iss(text);
  std::vector<std::string> out;
  std::string token;
  while (iss >> token) {
    out.push_back(token);
  }
  return out;
}

static bool ParseBool(const std::string & text)
{
  const std::string v = ToLower(text);
  return (v == "1" || v == "true" || v == "yes" || v == "on");
}

static TuneScope ParseScope(const std::string & text)
{
  const std::string v = ToLower(text);
  if (v == "front" || v == "can0") {
    return TuneScope::FRONT;
  }
  if (v == "rear" || v == "can1") {
    return TuneScope::REAR;
  }
  return TuneScope::ALL;
}

enum class PinocchioTauFfMode
{
  OFF,
  REPLACE,
  ADD,
};

static PinocchioTauFfMode ParsePinocchioTauFfMode(const std::string & text)
{
  const std::string v = ToLower(text);
  if (v == "replace") {
    return PinocchioTauFfMode::REPLACE;
  }
  if (v == "add") {
    return PinocchioTauFfMode::ADD;
  }
  return PinocchioTauFfMode::OFF;
}

static const char * PinocchioTauFfModeName(PinocchioTauFfMode mode)
{
  switch (mode) {
    case PinocchioTauFfMode::REPLACE:
      return "replace";
    case PinocchioTauFfMode::ADD:
      return "add";
    default:
      return "off";
  }
}

static std::optional<MotorRoute> GetRouteByMotorId(uint8_t motor_id)
{
  for (const auto & route : DogMapper::kTemporaryIndexMap) {
    if (route.motor_id == motor_id) {
      return route;
    }
  }
  return std::nullopt;
}

class MotorProtocolNode : public rclcpp::Node
{
public:
  MotorProtocolNode()
  : Node("motor_protocol_node")
  {
    kp_ = this->declare_parameter<double>("kp", 30.0);
    kd_ = this->declare_parameter<double>("kd", 1.5);
    default_velocity_ = this->declare_parameter<double>("default_velocity", 0.0);
    default_tau_ff_ = this->declare_parameter<double>("default_tau_ff", 0.0);
    enable_velocity_ff_ = this->declare_parameter<bool>("enable_velocity_ff", false);
    velocity_ff_scale_ = this->declare_parameter<double>("velocity_ff_scale", 1.0);
    velocity_ff_max_rad_s_ = this->declare_parameter<double>("velocity_ff_max_rad_s", 8.0);
    velocity_ff_lpf_hz_ = this->declare_parameter<double>("velocity_ff_lpf_hz", 20.0);
    publish_velocity_ff_ = this->declare_parameter<bool>("publish_velocity_ff", true);
    velocity_ff_max_clamp_ = std::min(
      std::fabs(velocity_ff_max_rad_s_), static_cast<double>(ProtocolCodec::kVMax));
    runtime_tune_topic_ = this->declare_parameter<std::string>("runtime_tune_topic", "/mit_gains_cmd");
    publish_feedback_joint_states_ = this->declare_parameter<bool>("publish_feedback_joint_states", true);
    feedback_joint_states_topic_ = this->declare_parameter<std::string>(
      "feedback_joint_states_topic", "/joint_states_feedback");
    feedback_joint_states_timer_hz_ = this->declare_parameter<double>("feedback_joint_states_timer_hz", 50.0);
    publish_feedback_velocity_effort_ = this->declare_parameter<bool>("publish_feedback_velocity_effort", true);
    feedback_joint_fill_nan_ = this->declare_parameter<bool>("feedback_joint_fill_nan", true);
    publish_motor_diagnostics_ = this->declare_parameter<bool>("publish_motor_diagnostics", false);
    motor_diagnostics_topic_ = this->declare_parameter<std::string>("motor_diagnostics_topic", "/diagnostics");
    enable_joint_tau_ff_ = this->declare_parameter<bool>("enable_joint_tau_ff", false);
    gravity_ff_scale_ = this->declare_parameter<double>("gravity_ff_scale", 0.5);
    tau_ff_nominal_nm_ = this->declare_parameter<std::vector<double>>(
      "tau_ff_nominal_nm", std::vector<double>(12, 0.0));
    use_joint_cmd_limits_ = this->declare_parameter<bool>("use_joint_cmd_limits", true);
    joint_cmd_min_rad_ = this->declare_parameter<std::vector<double>>(
      "joint_cmd_min_rad", std::vector<double>(12, -3.14));
    joint_cmd_max_rad_ = this->declare_parameter<std::vector<double>>(
      "joint_cmd_max_rad", std::vector<double>(12, 3.14));
    use_motor_domain_limits_ = this->declare_parameter<bool>("use_motor_domain_limits", true);
    derive_motor_limits_from_joint_cmd_ = this->declare_parameter<bool>(
      "derive_motor_limits_from_joint_cmd", true);
    joint_mit_min_rad_ = this->declare_parameter<std::vector<double>>(
      "joint_mit_min_rad", std::vector<double>(12, ProtocolCodec::kPMin));
    joint_mit_max_rad_ = this->declare_parameter<std::vector<double>>(
      "joint_mit_max_rad", std::vector<double>(12, ProtocolCodec::kPMax));
    enable_startup_smoothing_ = this->declare_parameter<bool>("enable_startup_smoothing", true);
    startup_smoothing_duration_s_ = this->declare_parameter<double>("startup_smoothing_duration_s", 1.5);
    command_max_velocity_rad_s_ = this->declare_parameter<double>("command_max_velocity_rad_s", 6.0);
    limit_velocity_only_during_smoothing_ = this->declare_parameter<bool>(
      "limit_velocity_only_during_smoothing", true);
    enable_mode_rising_smoothing_ = this->declare_parameter<bool>("enable_mode_rising_smoothing", true);
    motor_enabled_mode_status_ = this->declare_parameter<int>("motor_enabled_mode_status", 2);
    enable_feedback_step_limit_ = this->declare_parameter<bool>("enable_feedback_step_limit", true);
    feedback_step_limit_rad_ = this->declare_parameter<double>("feedback_step_limit_rad", 0.20);
    feedback_fresh_timeout_s_ = this->declare_parameter<double>("feedback_fresh_timeout_s", 0.30);
    enable_rx_decode_log_ = this->declare_parameter<bool>("enable_rx_decode_log", true);
    prefer_joint_name_mapping_ = this->declare_parameter<bool>("prefer_joint_name_mapping", true);
    enable_power_sequence_gate_ = this->declare_parameter<bool>("enable_power_sequence_gate", true);
    power_sequence_gate_topic_ = this->declare_parameter<std::string>("power_sequence_gate_topic", "/power_sequence/gate_open");
    tx_enable_can0_ = this->declare_parameter<bool>("tx_enable_can0", true);
    tx_enable_can1_ = this->declare_parameter<bool>("tx_enable_can1", true);
    enable_min_tx_refresh_ = this->declare_parameter<bool>("enable_min_tx_refresh", true);
    min_tx_refresh_interval_s_ = this->declare_parameter<double>("min_tx_refresh_interval_s", 0.02);
    enable_max_tx_rate_limit_ = this->declare_parameter<bool>("enable_max_tx_rate_limit", true);
    max_tx_rate_per_motor_hz_ = this->declare_parameter<double>("max_tx_rate_per_motor_hz", 60.0);
    joint_signs_ = this->declare_parameter<std::vector<double>>(
      "joint_signs", std::vector<double>(12, 1.0));

    joint_offsets_rad_ = this->declare_parameter<std::vector<double>>(
      "joint_offsets_rad", std::vector<double>(12, 0.0));

    // 指令侧补偿（CHAMP 域，12 维）：只加在下发目标上，不改变反馈映射/joint_offsets_rad。
    // 用于站立平衡等静态补偿，例如后膝 53/63 加 -0.02 rad（更弯曲一点）。
    joint_cmd_offsets_rad_ = this->declare_parameter<std::vector<double>>(
      "joint_cmd_offsets_rad", std::vector<double>(12, 0.0));

    const double off_hip = this->declare_parameter<double>("joint_offset_hip_rad", 0.0);
    const double off_thigh = this->declare_parameter<double>("joint_offset_thigh_rad", 0.0);
    const double off_calf = this->declare_parameter<double>("joint_offset_calf_rad", 0.0);

    const bool expand_mirror = this->declare_parameter<bool>(
      "expand_joint_offsets_from_mirror", false);
    if (expand_mirror) {
      joint_offsets_rad_ = BuildMirrorJointOffsetsRad(off_hip, off_thigh, off_calf);
      RCLCPP_INFO(
        this->get_logger(),
        "expand_joint_offsets_from_mirror: hip=%.5f thigh=%.5f calf_mag=%.5f (overrides joint_offsets_rad)",
        off_hip, off_thigh, off_calf);
    }

    if (joint_signs_.size() != 12 || joint_offsets_rad_.size() != 12) {
      RCLCPP_WARN(
        this->get_logger(),
        "joint_signs/joint_offsets_rad size mismatch, reset to 12 defaults.");
      joint_signs_ = std::vector<double>(12, 1.0);
      joint_offsets_rad_ = std::vector<double>(12, 0.0);
    }
    if (joint_cmd_offsets_rad_.size() != 12) {
      RCLCPP_WARN(
        this->get_logger(), "joint_cmd_offsets_rad size != 12, reset to zeros.");
      joint_cmd_offsets_rad_ = std::vector<double>(12, 0.0);
    }
    if (tau_ff_nominal_nm_.size() != 12) {
      RCLCPP_WARN(this->get_logger(), "tau_ff_nominal_nm size != 12, padding/truncating.");
      tau_ff_nominal_nm_.resize(12, 0.0);
    }

    // RQ-025：Pinocchio 定基重力前馈（默认关闭）
    pinocchio_tau_ff_mode_ = ParsePinocchioTauFfMode(
      this->declare_parameter<std::string>("pinocchio_tau_ff_mode", "off"));
    pinocchio_tau_ff_topic_ = this->declare_parameter<std::string>(
      "pinocchio_tau_ff_topic", "/model_tau_ff");
    pinocchio_tau_ff_scale_ = this->declare_parameter<double>("pinocchio_tau_ff_scale", 0.5);
    pinocchio_tau_ff_gain_ = this->declare_parameter<std::vector<double>>(
      "pinocchio_tau_ff_gain", std::vector<double>(12, 1.0));
    pinocchio_tau_ff_timeout_s_ = this->declare_parameter<double>("pinocchio_tau_ff_timeout_s", 0.2);
    pinocchio_tau_ff_ramp_s_ = this->declare_parameter<double>("pinocchio_tau_ff_ramp_s", 1.0);
    tau_signs_ = this->declare_parameter<std::vector<double>>(
      "tau_signs", std::vector<double>{});

    if (pinocchio_tau_ff_gain_.size() != 12) {
      RCLCPP_WARN(
        this->get_logger(), "pinocchio_tau_ff_gain size %zu != 12, reset to all 1.0",
        pinocchio_tau_ff_gain_.size());
      pinocchio_tau_ff_gain_ = std::vector<double>(12, 1.0);
    }

    if (pinocchio_tau_ff_timeout_s_ <= 0.0) {
      RCLCPP_WARN(
        this->get_logger(), "pinocchio_tau_ff_timeout_s <= 0, fallback to 0.2 s");
      pinocchio_tau_ff_timeout_s_ = 0.2;
    }
    if (pinocchio_tau_ff_ramp_s_ < 0.0) {
      RCLCPP_WARN(this->get_logger(), "pinocchio_tau_ff_ramp_s < 0, fallback to 0.0 s");
      pinocchio_tau_ff_ramp_s_ = 0.0;
    }
    if (tau_signs_.size() != 12) {
      if (!tau_signs_.empty()) {
        RCLCPP_WARN(
          this->get_logger(), "tau_signs size %zu != 12, fallback to joint_signs",
          tau_signs_.size());
      } else {
        RCLCPP_WARN(
          this->get_logger(),
          "tau_signs not set, fallback to joint_signs; verify URDF->motor torque sign on bench");
      }
      tau_signs_ = joint_signs_;
      tau_signs_explicit_ = false;
    } else {
      tau_signs_explicit_ = true;
    }
    if (pinocchio_tau_ff_mode_ != PinocchioTauFfMode::OFF) {
      RCLCPP_WARN(
        this->get_logger(),
        "RQ-025 model feedforward enabled: mode=%s scale=%.3f timeout=%.3fs ramp=%.3fs",
        PinocchioTauFfModeName(pinocchio_tau_ff_mode_), pinocchio_tau_ff_scale_,
        pinocchio_tau_ff_timeout_s_, pinocchio_tau_ff_ramp_s_);
    }

    publish_mit_mapped_ = this->declare_parameter<bool>("publish_mit_mapped_positions", true);
    mit_mapped_topic_ = this->declare_parameter<std::string>(
      "mit_mapped_positions_topic", "/mit_motor_position_rad");

    traj_sub_ = this->create_subscription<JointTrajectory>(
      "/joint_group_effort_controller/joint_trajectory", rclcpp::SensorDataQoS(),
      std::bind(&MotorProtocolNode::OnTrajectory, this, std::placeholders::_1));
    rx_sub_ = this->create_subscription<UInt8MultiArray>(
      "/can_rx_frames", rclcpp::SensorDataQoS(),
      std::bind(&MotorProtocolNode::OnRxFrame, this, std::placeholders::_1));
    tune_sub_ = this->create_subscription<String>(
      runtime_tune_topic_, 10,
      std::bind(&MotorProtocolNode::OnTuneCommand, this, std::placeholders::_1));
    model_tau_sub_ = this->create_subscription<JointState>(
      pinocchio_tau_ff_topic_, rclcpp::SensorDataQoS(),
      std::bind(&MotorProtocolNode::OnModelTauFf, this, std::placeholders::_1));
    if (enable_power_sequence_gate_) {
      gate_sub_ = this->create_subscription<Bool>(
        power_sequence_gate_topic_, 10,
        std::bind(&MotorProtocolNode::OnPowerGate, this, std::placeholders::_1));
    }

    const int can_tx_qos_depth = this->declare_parameter<int>("can_tx_frames_qos_depth", 4000);
    rclcpp::QoS qos_can_tx(static_cast<size_t>(std::max(1, can_tx_qos_depth)));
    qos_can_tx.reliable();
    tx_pub_ = this->create_publisher<UInt8MultiArray>("/can_tx_frames", qos_can_tx);
    feedback_pub_ = this->create_publisher<String>("/motor_feedback", 50);
    if (publish_feedback_joint_states_) {
      feedback_joint_states_pub_ = this->create_publisher<JointState>(
        feedback_joint_states_topic_, rclcpp::SensorDataQoS());
    }
    if (publish_motor_diagnostics_) {
      diagnostics_pub_ = this->create_publisher<DiagnosticArray>(motor_diagnostics_topic_, 10);
    }
    if (
      (publish_feedback_joint_states_ || publish_motor_diagnostics_) &&
      feedback_joint_states_timer_hz_ > 1e-3)
    {
      const int64_t period_ns = static_cast<int64_t>(1e9 / feedback_joint_states_timer_hz_);
      feedback_js_timer_ = this->create_wall_timer(
        std::chrono::nanoseconds(period_ns),
        std::bind(&MotorProtocolNode::OnFeedbackJointStatesTimer, this));
    }

    if (publish_mit_mapped_) {
      mapped_positions_pub_ = this->create_publisher<JointState>(mit_mapped_topic_, 10);
      RCLCPP_INFO(
        this->get_logger(),
        "Publishing MIT-mapped angles (θ_mit=sign*θ_champ+offset) on '%s' (same joint order as trajectory)",
        mit_mapped_topic_.c_str());
    }
    tx_refresh_timer_ = this->create_wall_timer(
      std::chrono::milliseconds(2),
      std::bind(&MotorProtocolNode::OnTxRefreshTimer, this));
    tx_stats_timer_ = this->create_wall_timer(
      std::chrono::seconds(5),
      std::bind(&MotorProtocolNode::LogTxWindowStats, this));

    RCLCPP_WARN(
      this->get_logger(),
      "P1 temporary mapping enabled: positions[0..11] -> IDs [11,12,13,21,22,23,51,52,53,61,62,63], "
      "front legs on can0, rear legs on can1.");
    RCLCPP_INFO(
      this->get_logger(),
      "Runtime MIT tuning topic: %s (example: 'scope=all kp=25 kd=1.8 tau=0.3' or 'scope=rear tau=0.6' or 'reset=1')",
      runtime_tune_topic_.c_str());
    if (enable_power_sequence_gate_) {
      RCLCPP_WARN(
        this->get_logger(),
        "Power sequence gate enabled: waiting gate_open on topic '%s' before forwarding trajectory",
        power_sequence_gate_topic_.c_str());
    } else {
      RCLCPP_INFO(this->get_logger(), "Power sequence gate disabled, trajectory forwarding always enabled");
    }
    ResetRuntimeTuning();
    last_commanded_mit_rad_.fill(std::numeric_limits<double>::quiet_NaN());
    last_feedback_champ_rad_.fill(std::numeric_limits<double>::quiet_NaN());
    last_feedback_joint_vel_rad_s_.fill(std::numeric_limits<double>::quiet_NaN());
    last_feedback_effort_nm_.fill(std::numeric_limits<double>::quiet_NaN());
    last_feedback_mode_status_.fill(-1);
    last_feedback_temp_c_.fill(std::numeric_limits<double>::quiet_NaN());
    last_feedback_fault_mask_.fill(0);
    last_sent_champ_rad_.fill(std::numeric_limits<double>::quiet_NaN());
    boot_feedback_champ_rad_.fill(std::numeric_limits<double>::quiet_NaN());
    boot_feedback_captured_.fill(false);
    has_last_sent_.fill(false);
    has_mode_status_.fill(false);
    last_mode_status_.fill(-1);
    last_feedback_stamp_ns_.fill(0);
    first_command_time_by_joint_ns_.fill(0);
    last_command_time_by_joint_ns_.fill(0);
    last_tx_pub_stamp_ns_.fill(0);
    last_vel_sample_champ_rad_.fill(0.0);
    last_vel_ff_rad_s_.fill(0.0);
    last_commanded_mit_vel_rad_s_.fill(std::numeric_limits<double>::quiet_NaN());
    last_vel_sample_ns_.fill(0);
    has_vel_sample_.fill(false);
    latest_input_champ_rad_.fill(0.0);
    has_latest_input_.fill(false);
    model_tau_ff_urdf_.fill(std::numeric_limits<double>::quiet_NaN());
    model_tau_ff_valid_.fill(false);
    has_model_tau_ff_ = false;
    model_tau_ff_max_abs_ = 0.0;
    if (!enable_power_sequence_gate_) {
      model_ff_ramp_start_ns_ = this->now().nanoseconds();
    }

    if (joint_cmd_min_rad_.size() != 12 || joint_cmd_max_rad_.size() != 12) {
      RCLCPP_WARN(this->get_logger(), "joint_cmd_min_rad/max size mismatch, using default [-3.14, 3.14]x12");
      joint_cmd_min_rad_ = std::vector<double>(12, -3.14);
      joint_cmd_max_rad_ = std::vector<double>(12, 3.14);
    }
    if (joint_mit_min_rad_.size() != 12 || joint_mit_max_rad_.size() != 12) {
      RCLCPP_WARN(this->get_logger(), "joint_mit_min_rad/max size mismatch, using protocol default range x12");
      joint_mit_min_rad_ = std::vector<double>(12, ProtocolCodec::kPMin);
      joint_mit_max_rad_ = std::vector<double>(12, ProtocolCodec::kPMax);
    }
    RebuildMotorLimitTable();

    if (!std::isfinite(velocity_ff_scale_) || velocity_ff_scale_ < 0.0) {
      RCLCPP_WARN(
        this->get_logger(), "velocity_ff_scale invalid (%.3f), clamped to 0", velocity_ff_scale_);
      velocity_ff_scale_ = 0.0;
    }
    if (!std::isfinite(velocity_ff_max_rad_s_) || velocity_ff_max_rad_s_ <= 0.0) {
      RCLCPP_WARN(
        this->get_logger(), "velocity_ff_max_rad_s invalid (%.3f), fallback to 8.0 rad/s",
        velocity_ff_max_rad_s_);
      velocity_ff_max_rad_s_ = 8.0;
    }
    velocity_ff_max_clamp_ = std::min(
      std::fabs(velocity_ff_max_rad_s_), static_cast<double>(ProtocolCodec::kVMax));
    if (enable_velocity_ff_) {
      RCLCPP_WARN(
        this->get_logger(),
        "Velocity FF enabled: v_ff = clamp(sign*scale*dq_champ, ±%.2f rad/s), scale=%.2f, lpf=%.1f Hz",
        velocity_ff_max_clamp_, velocity_ff_scale_, velocity_ff_lpf_hz_);
    }

    on_set_params_handle_ = this->add_on_set_parameters_callback(
      [this](const std::vector<rclcpp::Parameter> & parameters) {
        return this->OnSetParameters(parameters);
      });
  }

private:
  rcl_interfaces::msg::SetParametersResult OnSetParameters(
    const std::vector<rclcpp::Parameter> & parameters)
  {
    rcl_interfaces::msg::SetParametersResult out;
    out.successful = true;
    out.reason = "ok";
    for (const rclcpp::Parameter & p : parameters) {
      const std::string & name = p.get_name();
      if (name == "enable_joint_tau_ff") {
        if (p.get_type() != rclcpp::ParameterType::PARAMETER_BOOL) {
          out.successful = false;
          out.reason = "enable_joint_tau_ff must be bool";
          return out;
        }
        enable_joint_tau_ff_ = p.as_bool();
        RCLCPP_WARN(
          this->get_logger(), "Runtime param: enable_joint_tau_ff=%d", enable_joint_tau_ff_ ? 1 : 0);
      } else if (name == "gravity_ff_scale") {
        if (p.get_type() != rclcpp::ParameterType::PARAMETER_DOUBLE) {
          out.successful = false;
          out.reason = "gravity_ff_scale must be double";
          return out;
        }
        gravity_ff_scale_ = p.as_double();
        RCLCPP_WARN(this->get_logger(), "Runtime param: gravity_ff_scale=%.6f", gravity_ff_scale_);
      } else if (name == "enable_velocity_ff") {
        if (p.get_type() != rclcpp::ParameterType::PARAMETER_BOOL) {
          out.successful = false;
          out.reason = "enable_velocity_ff must be bool";
          return out;
        }
        const bool prev = enable_velocity_ff_;
        enable_velocity_ff_ = p.as_bool();
        if (prev != enable_velocity_ff_) {
          ResetAllVelocityFf();
        }
        RCLCPP_WARN(
          this->get_logger(), "Runtime param: enable_velocity_ff=%d",
          enable_velocity_ff_ ? 1 : 0);
      } else if (name == "velocity_ff_scale") {
        if (p.get_type() != rclcpp::ParameterType::PARAMETER_DOUBLE) {
          out.successful = false;
          out.reason = "velocity_ff_scale must be double";
          return out;
        }
        velocity_ff_scale_ = Clamp(p.as_double(), 0.0, 3.0);
        RCLCPP_WARN(
          this->get_logger(), "Runtime param: velocity_ff_scale=%.4f", velocity_ff_scale_);
      } else if (name == "velocity_ff_max_rad_s") {
        if (p.get_type() != rclcpp::ParameterType::PARAMETER_DOUBLE) {
          out.successful = false;
          out.reason = "velocity_ff_max_rad_s must be double";
          return out;
        }
        velocity_ff_max_rad_s_ = p.as_double();
        if (!std::isfinite(velocity_ff_max_rad_s_) || velocity_ff_max_rad_s_ <= 0.0) {
          velocity_ff_max_rad_s_ = 8.0;
        }
        velocity_ff_max_clamp_ = std::min(
          std::fabs(velocity_ff_max_rad_s_), static_cast<double>(ProtocolCodec::kVMax));
        RCLCPP_WARN(
          this->get_logger(), "Runtime param: velocity_ff_max_rad_s=%.3f (clamp=%.3f)",
          velocity_ff_max_rad_s_, velocity_ff_max_clamp_);
      } else if (name == "velocity_ff_lpf_hz") {
        if (p.get_type() != rclcpp::ParameterType::PARAMETER_DOUBLE) {
          out.successful = false;
          out.reason = "velocity_ff_lpf_hz must be double";
          return out;
        }
        velocity_ff_lpf_hz_ = p.as_double();
        RCLCPP_WARN(
          this->get_logger(), "Runtime param: velocity_ff_lpf_hz=%.3f", velocity_ff_lpf_hz_);
      } else if (name == "publish_velocity_ff") {
        if (p.get_type() != rclcpp::ParameterType::PARAMETER_BOOL) {
          out.successful = false;
          out.reason = "publish_velocity_ff must be bool";
          return out;
        }
        publish_velocity_ff_ = p.as_bool();
        RCLCPP_WARN(
          this->get_logger(), "Runtime param: publish_velocity_ff=%d",
          publish_velocity_ff_ ? 1 : 0);
      } else if (name == "tau_ff_nominal_nm") {
        if (p.get_type() != rclcpp::ParameterType::PARAMETER_DOUBLE_ARRAY) {
          out.successful = false;
          out.reason = "tau_ff_nominal_nm must be double[]";
          return out;
        }
        const auto v = p.as_double_array();
        if (v.size() != 12) {
          out.successful = false;
          out.reason = "tau_ff_nominal_nm must have 12 elements";
          return out;
        }
        tau_ff_nominal_nm_.assign(v.begin(), v.end());
        RCLCPP_WARN(this->get_logger(), "Runtime param: tau_ff_nominal_nm updated (12 doubles)");
      } else if (name == "joint_cmd_offsets_rad") {
        if (p.get_type() != rclcpp::ParameterType::PARAMETER_DOUBLE_ARRAY) {
          out.successful = false;
          out.reason = "joint_cmd_offsets_rad must be double[]";
          return out;
        }
        const auto v = p.as_double_array();
        if (v.size() != 12) {
          out.successful = false;
          out.reason = "joint_cmd_offsets_rad must have 12 elements";
          return out;
        }
        joint_cmd_offsets_rad_.assign(v.begin(), v.end());
        RCLCPP_WARN(
          this->get_logger(), "Runtime param: joint_cmd_offsets_rad updated (12 doubles)");
      } else if (name == "pinocchio_tau_ff_mode") {
        if (p.get_type() != rclcpp::ParameterType::PARAMETER_STRING) {
          out.successful = false;
          out.reason = "pinocchio_tau_ff_mode must be string (off|replace|add)";
          return out;
        }
        const auto prev = pinocchio_tau_ff_mode_;
        pinocchio_tau_ff_mode_ = ParsePinocchioTauFfMode(p.as_string());
        if (prev == PinocchioTauFfMode::OFF && pinocchio_tau_ff_mode_ != PinocchioTauFfMode::OFF) {
          model_ff_ramp_start_ns_ =
            (power_gate_open_ || !enable_power_sequence_gate_) ? this->now().nanoseconds() : 0;
        } else if (pinocchio_tau_ff_mode_ == PinocchioTauFfMode::OFF) {
          model_ff_ramp_start_ns_ = 0;
        }
        RCLCPP_WARN(
          this->get_logger(), "Runtime param: pinocchio_tau_ff_mode=%s",
          PinocchioTauFfModeName(pinocchio_tau_ff_mode_));
      } else if (name == "pinocchio_tau_ff_scale") {
        if (p.get_type() != rclcpp::ParameterType::PARAMETER_DOUBLE) {
          out.successful = false;
          out.reason = "pinocchio_tau_ff_scale must be double";
          return out;
        }
        pinocchio_tau_ff_scale_ = std::max(0.0, p.as_double());
        if (pinocchio_tau_ff_scale_ > 1.0) {
          RCLCPP_WARN(
            this->get_logger(), "pinocchio_tau_ff_scale=%.3f > 1.0, model feedforward may over-compensate",
            pinocchio_tau_ff_scale_);
        }
        RCLCPP_WARN(
          this->get_logger(), "Runtime param: pinocchio_tau_ff_scale=%.6f",
          pinocchio_tau_ff_scale_);
      } else if (name == "pinocchio_tau_ff_gain") {
        if (p.get_type() != rclcpp::ParameterType::PARAMETER_DOUBLE_ARRAY) {
          out.successful = false;
          out.reason = "pinocchio_tau_ff_gain must be double[]";
          return out;
        }
        const auto v = p.as_double_array();
        if (v.size() != 12) {
          out.successful = false;
          out.reason = "pinocchio_tau_ff_gain must have 12 elements";
          return out;
        }
        for (const double g : v) {
          if (!std::isfinite(g) || g < 0.0) {
            out.successful = false;
            out.reason = "pinocchio_tau_ff_gain elements must be finite and >= 0";
            return out;
          }
        }
        pinocchio_tau_ff_gain_.assign(v.begin(), v.end());
        RCLCPP_WARN(this->get_logger(), "Runtime param: pinocchio_tau_ff_gain updated (12 doubles)");
      } else if (name == "pinocchio_tau_ff_timeout_s") {
        if (p.get_type() != rclcpp::ParameterType::PARAMETER_DOUBLE) {
          out.successful = false;
          out.reason = "pinocchio_tau_ff_timeout_s must be double";
          return out;
        }
        const double v = p.as_double();
        if (v <= 0.0) {
          out.successful = false;
          out.reason = "pinocchio_tau_ff_timeout_s must be > 0";
          return out;
        }
        pinocchio_tau_ff_timeout_s_ = v;
        RCLCPP_WARN(
          this->get_logger(), "Runtime param: pinocchio_tau_ff_timeout_s=%.6f",
          pinocchio_tau_ff_timeout_s_);
      } else if (name == "pinocchio_tau_ff_ramp_s") {
        if (p.get_type() != rclcpp::ParameterType::PARAMETER_DOUBLE) {
          out.successful = false;
          out.reason = "pinocchio_tau_ff_ramp_s must be double";
          return out;
        }
        const double v = p.as_double();
        if (v < 0.0) {
          out.successful = false;
          out.reason = "pinocchio_tau_ff_ramp_s must be >= 0";
          return out;
        }
        pinocchio_tau_ff_ramp_s_ = v;
        RCLCPP_WARN(
          this->get_logger(), "Runtime param: pinocchio_tau_ff_ramp_s=%.6f",
          pinocchio_tau_ff_ramp_s_);
      } else if (name == "tau_signs") {
        if (p.get_type() != rclcpp::ParameterType::PARAMETER_DOUBLE_ARRAY) {
          out.successful = false;
          out.reason = "tau_signs must be double[]";
          return out;
        }
        const auto v = p.as_double_array();
        if (v.size() != 12) {
          out.successful = false;
          out.reason = "tau_signs must have 12 elements";
          return out;
        }
        for (const double s : v) {
          if (std::fabs(s) < 1e-6) {
            out.successful = false;
            out.reason = "tau_signs elements must be non-zero";
            return out;
          }
        }
        tau_signs_.assign(v.begin(), v.end());
        tau_signs_explicit_ = true;
        RCLCPP_WARN(this->get_logger(), "Runtime param: tau_signs updated (12 doubles)");
      }
    }
    return out;
  }

  void OnTrajectory(const JointTrajectory::SharedPtr msg)
  {
    ++traj_cb_count_window_;
    if (msg->points.empty()) {
      RCLCPP_WARN_THROTTLE(
        this->get_logger(), *this->get_clock(), 2000,
        "Ignore trajectory without points");
      return;
    }

    const auto & positions = msg->points.front().positions;
    traj_joint_count_window_ += std::min(positions.size(), DogMapper::kTemporaryIndexMap.size());
    uint32_t front_count = 0;
    uint32_t rear_count = 0;
    size_t total_sent = 0;

    std::array<double, 12> mapped_rad{};
    mapped_rad.fill(std::numeric_limits<double>::quiet_NaN());
    std::array<double, 12> mapped_vel{};
    mapped_vel.fill(std::numeric_limits<double>::quiet_NaN());

    // 强制固定索引映射，保证每个周期尽量覆盖 12 个电机，避免名称映射分支造成分布不均。
    const size_t count = std::min(positions.size(), DogMapper::kTemporaryIndexMap.size());
    if (count < DogMapper::kTemporaryIndexMap.size()) {
      RCLCPP_WARN_THROTTLE(
        this->get_logger(), *this->get_clock(), 2000,
        "Trajectory positions size=%zu (<12), use last target for missing joints", positions.size());
    }
    for (size_t i = 0; i < DogMapper::kTemporaryIndexMap.size(); ++i) {
      const auto route = DogMapper::GetRouteByTrajectoryIndex(i);
      if (!route.has_value()) {
        continue;
      }
      double target = 0.0;
      if (i < count) {
        target = positions[i];
        latest_input_champ_rad_[i] = target;
        has_latest_input_[i] = true;
      } else if (has_latest_input_[i]) {
        target = latest_input_champ_rad_[i];
      } else {
        continue;
      }
      if (enable_power_sequence_gate_ && !power_gate_open_) {
        ++skip_power_gate_window_;
        continue;
      }
      SendMitFrame(route.value(), target, front_count, rear_count, &mapped_rad, &mapped_vel);
      ++total_sent;
    }

    if (publish_mit_mapped_ && mapped_positions_pub_) {
      JointState js;
      js.header.stamp = this->now();
      js.name.reserve(DogMapper::kChampJointNames.size());
      for (const char * jn : DogMapper::kChampJointNames) {
        js.name.emplace_back(jn);
      }
      js.position.assign(mapped_rad.begin(), mapped_rad.end());
      if (publish_velocity_ff_ && enable_velocity_ff_) {
        js.velocity.assign(mapped_vel.begin(), mapped_vel.end());
      }
      mapped_positions_pub_->publish(js);
    }

    RCLCPP_INFO_THROTTLE(
      this->get_logger(), *this->get_clock(), 1000,
      "MIT publish: total=%zu front(can0)=%u rear(can1)=%u kp=%.2f kd=%.2f v=%.2f tau=%.2f vff=%d scale=%.2f max=%.2f",
      total_sent, front_count, rear_count, runtime_kp_can0_, runtime_kd_can0_, default_velocity_, runtime_tau_can0_,
      enable_velocity_ff_ ? 1 : 0, velocity_ff_scale_, velocity_ff_max_clamp_);
    const size_t joint_total = joint_cmd_clamp_count_total_ + joint_cmd_no_clamp_count_total_;
    const size_t motor_total = motor_cmd_clamp_count_total_ + motor_cmd_no_clamp_count_total_;
    const double joint_clamp_ratio = joint_total > 0 ?
      (100.0 * static_cast<double>(joint_cmd_clamp_count_total_) / static_cast<double>(joint_total)) : 0.0;
    const double motor_clamp_ratio = motor_total > 0 ?
      (100.0 * static_cast<double>(motor_cmd_clamp_count_total_) / static_cast<double>(motor_total)) : 0.0;
    RCLCPP_INFO_THROTTLE(
      this->get_logger(), *this->get_clock(), 1000,
      "Command clamp stats(total): CHAMP=%zu/%zu(%.2f%%) MIT=%zu/%zu(%.2f%%)",
      joint_cmd_clamp_count_total_, joint_total, joint_clamp_ratio,
      motor_cmd_clamp_count_total_, motor_total, motor_clamp_ratio);
  }

  void SendMitFrame(
    const MotorRoute & route, double champ_position_raw,
    uint32_t & front_count, uint32_t & rear_count,
    std::array<double, 12> * mapped_out = nullptr,
    std::array<double, 12> * velocity_out = nullptr)
  {
    const size_t idx = std::min(route.trajectory_index, static_cast<size_t>(11));
    const int64_t now_ns = this->now().nanoseconds();
    if (
      enable_max_tx_rate_limit_ &&
      max_tx_rate_per_motor_hz_ > 1e-6 &&
      idx < last_tx_pub_stamp_ns_.size() &&
      last_tx_pub_stamp_ns_[idx] > 0)
    {
      const int64_t min_interval_ns = static_cast<int64_t>(1e9 / max_tx_rate_per_motor_hz_);
      if ((now_ns - last_tx_pub_stamp_ns_[idx]) < min_interval_ns) {
        ++skip_max_rate_limit_window_;
        return;
      }
    }
    const double champ_cmd =
      champ_position_raw + (idx < joint_cmd_offsets_rad_.size() ? joint_cmd_offsets_rad_[idx] : 0.0);
    const double champ_limited = ClampJointCommand(idx, champ_cmd);
    const double champ_smoothed = SmoothJointCommand(idx, champ_limited);
    const double mapped_position_raw = joint_signs_[idx] * champ_smoothed + joint_offsets_rad_[idx];
    const double mapped_position = ClampMotorCommand(idx, mapped_position_raw);
    if (mapped_out != nullptr) {
      (*mapped_out)[idx] = mapped_position;
    }

    const bool is_front = (route.bus == CanBus::CAN0);
    if ((is_front && !tx_enable_can0_) || (!is_front && !tx_enable_can1_)) {
      ++skip_bus_disabled_window_;
      return;
    }
    const double use_kp = is_front ? runtime_kp_can0_ : runtime_kp_can1_;
    const double use_kd = is_front ? runtime_kd_can0_ : runtime_kd_can1_;
    const double use_tau = ComputeMitTorqueFf(idx, is_front);
    const double use_velocity = Clamp(
      default_velocity_ + ComputeVelocityFf(idx, champ_smoothed, now_ns),
      static_cast<double>(ProtocolCodec::kVMin),
      static_cast<double>(ProtocolCodec::kVMax));
    last_commanded_mit_vel_rad_s_[idx] = use_velocity;
    if (velocity_out != nullptr) {
      (*velocity_out)[idx] = use_velocity;
    }

    const auto frame = ProtocolCodec::BuildMitControlFrame(
      route.bus,
      route.motor_id,
      static_cast<float>(mapped_position),
      static_cast<float>(use_velocity),
      static_cast<float>(use_kp),
      static_cast<float>(use_kd),
      static_cast<float>(use_tau));

    auto packed = FrameCodec::Pack(frame);
    tx_pub_->publish(packed);
    ++tx_traj_total_window_;
    if (route.bus == CanBus::CAN0) {
      ++front_count;
      ++tx_traj_can0_window_;
    } else {
      ++rear_count;
      ++tx_traj_can1_window_;
    }

    RCLCPP_DEBUG(
      this->get_logger(),
      "MIT TX joint=%s motor=%u raw=%.4f lim=%.4f smooth=%.4f %s",
      route.joint_hint,
      route.motor_id,
      champ_position_raw,
      champ_limited,
      champ_smoothed,
      ProtocolCodec::FrameSummary(frame).c_str());

    if (route.motor_id < last_commanded_mit_rad_.size()) {
      last_commanded_mit_rad_[route.motor_id] = mapped_position;
    }
    if (idx < last_tx_pub_stamp_ns_.size()) {
      last_tx_pub_stamp_ns_[idx] = now_ns;
    }
  }

  void OnTxRefreshTimer()
  {
    if (!enable_min_tx_refresh_ || min_tx_refresh_interval_s_ <= 1e-6) {
      return;
    }
    if (enable_power_sequence_gate_ && !power_gate_open_) {
      return;
    }
    const int64_t now_ns = this->now().nanoseconds();
    const int64_t refresh_ns = static_cast<int64_t>(min_tx_refresh_interval_s_ * 1e9);
    for (const auto & route : DogMapper::kTemporaryIndexMap) {
      const size_t idx = std::min(route.trajectory_index, static_cast<size_t>(11));
      if (idx >= last_tx_pub_stamp_ns_.size()) {
        continue;
      }
      if (last_tx_pub_stamp_ns_[idx] > 0 && (now_ns - last_tx_pub_stamp_ns_[idx]) < refresh_ns) {
        continue;
      }
      const bool is_front = (route.bus == CanBus::CAN0);
      if ((is_front && !tx_enable_can0_) || (!is_front && !tx_enable_can1_)) {
        continue;
      }
      const double mapped_position =
        route.motor_id < last_commanded_mit_rad_.size() ? last_commanded_mit_rad_[route.motor_id] :
        std::numeric_limits<double>::quiet_NaN();
      if (!std::isfinite(mapped_position)) {
        continue;
      }
      const double use_kp = is_front ? runtime_kp_can0_ : runtime_kp_can1_;
      const double use_kd = is_front ? runtime_kd_can0_ : runtime_kd_can1_;
      const double use_tau = ComputeMitTorqueFf(idx, is_front);
      const double refresh_velocity = last_commanded_mit_vel_rad_s_[idx];
      const double use_velocity =
        std::isfinite(refresh_velocity) ? refresh_velocity : default_velocity_;
      const auto frame = ProtocolCodec::BuildMitControlFrame(
        route.bus,
        route.motor_id,
        static_cast<float>(mapped_position),
        static_cast<float>(use_velocity),
        static_cast<float>(use_kp),
        static_cast<float>(use_kd),
        static_cast<float>(use_tau));
      auto packed = FrameCodec::Pack(frame);
      tx_pub_->publish(packed);
      ++tx_refresh_total_window_;
      if (is_front) {
        ++tx_refresh_can0_window_;
      } else {
        ++tx_refresh_can1_window_;
      }
      last_tx_pub_stamp_ns_[idx] = now_ns;
    }
  }

  void LogTxWindowStats()
  {
    const size_t tx_total = tx_traj_total_window_ + tx_refresh_total_window_;
    RCLCPP_INFO(
      this->get_logger(),
      "MP TX window(5s): traj_cb=%zu traj_joint_targets=%zu tx_total=%zu tx_traj=%zu(can0=%zu can1=%zu) tx_refresh=%zu(can0=%zu can1=%zu) skip_max_rate=%zu skip_bus_disabled=%zu",
      traj_cb_count_window_,
      traj_joint_count_window_,
      tx_total,
      tx_traj_total_window_,
      tx_traj_can0_window_,
      tx_traj_can1_window_,
      tx_refresh_total_window_,
      tx_refresh_can0_window_,
      tx_refresh_can1_window_,
      skip_max_rate_limit_window_,
      skip_bus_disabled_window_);
    RCLCPP_INFO_THROTTLE(
      this->get_logger(), *this->get_clock(), 1000,
      "MP gate window(5s): gate_open=%d skip_gate=%zu",
      power_gate_open_ ? 1 : 0,
      skip_power_gate_window_);

    if (pinocchio_tau_ff_mode_ != PinocchioTauFfMode::OFF) {
      const double model_age_s = has_model_tau_ff_ ?
        (this->now() - model_tau_ff_stamp_).seconds() : -1.0;
      RCLCPP_INFO(
        this->get_logger(),
        "MP model_ff: mode=%s age=%.3fs max|g|=%.4f scale=%.3f tau_signs=%s",
        PinocchioTauFfModeName(pinocchio_tau_ff_mode_), model_age_s,
        model_tau_ff_max_abs_, pinocchio_tau_ff_scale_,
        tau_signs_explicit_ ? "param" : "joint_signs-fallback");
    }

    traj_cb_count_window_ = 0;
    traj_joint_count_window_ = 0;
    tx_traj_total_window_ = 0;
    tx_traj_can0_window_ = 0;
    tx_traj_can1_window_ = 0;
    tx_refresh_total_window_ = 0;
    tx_refresh_can0_window_ = 0;
    tx_refresh_can1_window_ = 0;
    skip_max_rate_limit_window_ = 0;
    skip_bus_disabled_window_ = 0;
    skip_power_gate_window_ = 0;
  }

  void OnPowerGate(const Bool::SharedPtr msg)
  {
    const bool next = msg->data;
    if (next == power_gate_open_) {
      return;
    }
    power_gate_open_ = next;
    RCLCPP_WARN(this->get_logger(), "Power sequence gate changed: gate_open=%d", power_gate_open_ ? 1 : 0);
    if (power_gate_open_) {
      model_ff_ramp_start_ns_ = this->now().nanoseconds();
    } else {
      model_ff_ramp_start_ns_ = 0;
      last_tx_pub_stamp_ns_.fill(0);
      ResetAllVelocityFf();
    }
  }

  void OnRxFrame(const UInt8MultiArray::SharedPtr msg)
  {
    const auto frame = FrameCodec::Unpack(*msg);
    if (!frame.has_value()) {
      return;
    }

    const auto feedback = ProtocolCodec::DecodeFeedback(frame.value());
    if (!feedback.has_value()) {
      return;
    }

    const double expected_mit = feedback->motor_id < last_commanded_mit_rad_.size() ?
      last_commanded_mit_rad_[feedback->motor_id] :
      std::numeric_limits<double>::quiet_NaN();
    if (std::isfinite(expected_mit)) {
      const double abs_err = std::fabs(expected_mit - feedback->current_angle);
      ++error_sample_count_;
      error_abs_sum_ += abs_err;
      error_abs_max_ = std::max(error_abs_max_, abs_err);
    }

    if (const auto route = GetRouteByMotorId(feedback->motor_id); route.has_value()) {
      const size_t idx = std::min(route->trajectory_index, static_cast<size_t>(11));
      const double sign = std::fabs(joint_signs_[idx]) < 1e-6 ? 1.0 : joint_signs_[idx];
      const double champ_feedback = (feedback->current_angle - joint_offsets_rad_[idx]) / sign;
      const rclcpp::Time now = this->now();
      last_feedback_champ_rad_[idx] = champ_feedback;
      // CHAMP 关节角速度：θ_champ = (θ_mit - offset)/sign ⇒ ω_champ ≈ ω_mit/sign（直连模型）
      last_feedback_joint_vel_rad_s_[idx] = static_cast<double>(feedback->current_speed) / sign;
      // effort：与 EL05 / MIT 协议同号的电机报告力矩 (Nm)；与 tau_ff_nominal_nm 同一约定，不经 joint_signs 二次取反
      last_feedback_effort_nm_[idx] = static_cast<double>(feedback->current_torque);
      last_feedback_mode_status_[idx] = static_cast<int>(feedback->mode_status);
      last_feedback_temp_c_[idx] = static_cast<double>(feedback->current_temp);
      {
        uint32_t mask = 0;
        if (feedback->error_status) {
          mask |= 1u << 0;
        }
        if (feedback->hall_error) {
          mask |= 1u << 1;
        }
        if (feedback->magnet_error) {
          mask |= 1u << 2;
        }
        if (feedback->temp_error) {
          mask |= 1u << 3;
        }
        if (feedback->current_error) {
          mask |= 1u << 4;
        }
        if (feedback->voltage_error) {
          mask |= 1u << 5;
        }
        last_feedback_fault_mask_[idx] = mask;
      }
      last_feedback_stamp_ns_[idx] = now.nanoseconds();
      if (!boot_feedback_captured_[idx]) {
        boot_feedback_champ_rad_[idx] = champ_feedback;
        boot_feedback_captured_[idx] = true;
      }

      const int mode_curr = static_cast<int>(feedback->mode_status);
      const uint8_t mid = feedback->motor_id;
      if (enable_mode_rising_smoothing_) {
        const bool prev_known = has_mode_status_[mid];
        const int mode_prev = last_mode_status_[mid];
        const bool rising_to_enabled = IsEnabledMode(mode_curr) && (!prev_known || !IsEnabledMode(mode_prev));
        if (rising_to_enabled) {
          ResetSmoothingForJoint(idx, champ_feedback, now);
          RCLCPP_WARN(
            this->get_logger(),
            "Mode rising edge detected: motor=%u mode %d->%d, reset smoothing anchor to %.4f rad",
            static_cast<unsigned>(mid), mode_prev, mode_curr, champ_feedback);
        }
      }
      has_mode_status_[mid] = true;
      last_mode_status_[mid] = mode_curr;
    }

    if (enable_rx_decode_log_) {
      std::ostringstream oss;
      oss << "bus=" << feedback->source_bus
          << " motor=" << static_cast<int>(feedback->motor_id)
          << " mode=" << static_cast<int>(feedback->mode_status)
          << " angle=" << feedback->current_angle
          << " speed=" << feedback->current_speed
          << " torque=" << feedback->current_torque
          << " temp=" << feedback->current_temp
          << " err=" << (feedback->error_status ? "1" : "0");
      if (std::isfinite(expected_mit)) {
        oss << " cmd_angle=" << expected_mit
            << " abs_err=" << std::fabs(expected_mit - feedback->current_angle);
      }

      String out;
      out.data = oss.str();
      feedback_pub_->publish(out);

      RCLCPP_INFO_THROTTLE(this->get_logger(), *this->get_clock(), 1000, "%s", out.data.c_str());
      RCLCPP_INFO_THROTTLE(
        this->get_logger(), *this->get_clock(), 1000,
        "MIT tracking abs_err(rad): mean=%.4f max=%.4f samples=%zu | can0(kp=%.2f,kd=%.2f,tau=%.2f) can1(kp=%.2f,kd=%.2f,tau=%.2f)",
        error_sample_count_ > 0 ? (error_abs_sum_ / static_cast<double>(error_sample_count_)) : 0.0,
        error_abs_max_,
        error_sample_count_,
        runtime_kp_can0_, runtime_kd_can0_, runtime_tau_can0_,
        runtime_kp_can1_, runtime_kd_can1_, runtime_tau_can1_);
    }
  }

  void OnFeedbackJointStatesTimer()
  {
    if (publish_feedback_joint_states_ && feedback_joint_states_pub_) {
      PublishFeedbackJointStates();
    }
    if (publish_motor_diagnostics_ && diagnostics_pub_) {
      PublishMotorDiagnostics();
    }
  }

  void PublishMotorDiagnostics()
  {
    if (!diagnostics_pub_) {
      return;
    }
    DiagnosticArray da;
    da.header.stamp = this->now();
    for (size_t i = 0; i < DogMapper::kChampJointNames.size(); ++i) {
      DiagnosticStatus st;
      st.name = std::string("trotbot_can_bridge:motor_feedback:") + DogMapper::kChampJointNames[i];
      st.hardware_id = std::to_string(static_cast<int>(DogMapper::kTemporaryIndexMap[i].motor_id));
      st.level = DiagnosticStatus::OK;
      st.message = "feedback";

      auto push_kv = [&](const std::string & key, const std::string & val) {
        KeyValue kv;
        kv.key = key;
        kv.value = val;
        st.values.push_back(kv);
      };

      if (last_feedback_mode_status_[i] >= 0) {
        push_kv("mode_status", std::to_string(last_feedback_mode_status_[i]));
      } else {
        push_kv("mode_status", "unknown");
      }
      if (std::isfinite(last_feedback_temp_c_[i])) {
        push_kv("temp_c", std::to_string(last_feedback_temp_c_[i]));
      } else {
        push_kv("temp_c", "nan");
      }

      const uint32_t m = last_feedback_fault_mask_[i];
      push_kv("fault_mask", std::to_string(m));
      push_kv("fault_error_status", (m & (1u << 0)) ? "1" : "0");
      push_kv("fault_hall", (m & (1u << 1)) ? "1" : "0");
      push_kv("fault_magnet", (m & (1u << 2)) ? "1" : "0");
      push_kv("fault_temp", (m & (1u << 3)) ? "1" : "0");
      push_kv("fault_current", (m & (1u << 4)) ? "1" : "0");
      push_kv("fault_voltage", (m & (1u << 5)) ? "1" : "0");

      if (m != 0u) {
        st.level = DiagnosticStatus::ERROR;
        st.message = "motor fault bits set";
      }

      da.status.push_back(st);
    }
    diagnostics_pub_->publish(da);
  }

  void PublishFeedbackJointStates()
  {
    if (!feedback_joint_states_pub_) {
      return;
    }
    JointState js;
    js.header.stamp = this->now();
    const size_t n = DogMapper::kChampJointNames.size();
    js.name.reserve(n);
    js.position.reserve(n);
    for (size_t i = 0; i < n; ++i) {
      js.name.emplace_back(DogMapper::kChampJointNames[i]);
      const double pos = std::isfinite(last_feedback_champ_rad_[i]) ? last_feedback_champ_rad_[i] : 0.0;
      js.position.emplace_back(pos);
    }
    if (publish_feedback_velocity_effort_) {
      const double nan_vel = std::numeric_limits<double>::quiet_NaN();
      const double nan_eff = std::numeric_limits<double>::quiet_NaN();
      js.velocity.assign(n, 0.0);
      js.effort.assign(n, 0.0);
      for (size_t i = 0; i < n; ++i) {
        const bool v_ok = std::isfinite(last_feedback_joint_vel_rad_s_[i]);
        const bool e_ok = std::isfinite(last_feedback_effort_nm_[i]);
        if (feedback_joint_fill_nan_) {
          js.velocity[i] = v_ok ? last_feedback_joint_vel_rad_s_[i] : nan_vel;
          js.effort[i] = e_ok ? last_feedback_effort_nm_[i] : nan_eff;
        } else {
          js.velocity[i] = v_ok ? last_feedback_joint_vel_rad_s_[i] : 0.0;
          js.effort[i] = e_ok ? last_feedback_effort_nm_[i] : 0.0;
        }
      }
    }
    feedback_joint_states_pub_->publish(js);
  }

  void OnModelTauFf(const JointState::SharedPtr msg)
  {
    if (pinocchio_tau_ff_mode_ == PinocchioTauFfMode::OFF) {
      return;
    }

    std::array<double, 12> values;
    values.fill(std::numeric_limits<double>::quiet_NaN());
    std::array<bool, 12> got{};
    size_t matched = 0;

    const size_t count = std::min(msg->name.size(), msg->effort.size());
    for (size_t k = 0; k < count; ++k) {
      size_t slot = DogMapper::kChampJointNames.size();
      for (size_t i = 0; i < DogMapper::kChampJointNames.size(); ++i) {
        if (msg->name[k] == DogMapper::kChampJointNames[i]) {
          slot = i;
          break;
        }
      }
      if (slot >= DogMapper::kChampJointNames.size()) {
        continue;
      }
      const double tau = msg->effort[k];
      if (!std::isfinite(tau)) {
        RCLCPP_WARN_THROTTLE(
          this->get_logger(), *this->get_clock(), 2000,
          "non-finite model tau_ff for joint '%s', ignore frame", msg->name[k].c_str());
        return;
      }
      values[slot] = tau;
      if (!got[slot]) {
        got[slot] = true;
        ++matched;
      }
    }

    if (matched != 12) {
      RCLCPP_WARN_THROTTLE(
        this->get_logger(), *this->get_clock(), 2000,
        "model tau_ff missing joints (%zu/12), ignore frame", matched);
      return;
    }

    double max_abs = 0.0;
    for (const double v : values) {
      max_abs = std::max(max_abs, std::fabs(v));
    }
    model_tau_ff_urdf_ = values;
    model_tau_ff_valid_ = got;
    model_tau_ff_max_abs_ = max_abs;
    model_tau_ff_stamp_ = this->now();
    has_model_tau_ff_ = true;
  }

  double RampFactor(const rclcpp::Time & now) const
  {
    if (pinocchio_tau_ff_ramp_s_ <= 1e-6) {
      return 1.0;
    }
    if (model_ff_ramp_start_ns_ <= 0) {
      return 0.0;
    }
    const double elapsed =
      static_cast<double>(now.nanoseconds() - model_ff_ramp_start_ns_) * 1e-9;
    return Clamp(elapsed / pinocchio_tau_ff_ramp_s_, 0.0, 1.0);
  }

  double ComputeMitTorqueFf(size_t idx, bool is_front)
  {
    const auto now = this->now();
    const double bus_tau = is_front ? runtime_tau_can0_ : runtime_tau_can1_;
    const double nominal = idx < tau_ff_nominal_nm_.size() ? tau_ff_nominal_nm_[idx] : 0.0;
    const double table_tau = enable_joint_tau_ff_ ? gravity_ff_scale_ * nominal : 0.0;

    if (pinocchio_tau_ff_mode_ == PinocchioTauFfMode::OFF) {
      return Clamp(bus_tau + table_tau, ProtocolCodec::kTMin, ProtocolCodec::kTMax);
    }

    const bool fresh = has_model_tau_ff_ &&
      (now - model_tau_ff_stamp_).seconds() <= pinocchio_tau_ff_timeout_s_ &&
      idx < model_tau_ff_valid_.size() && model_tau_ff_valid_[idx];
    if (!fresh) {
      RCLCPP_WARN_THROTTLE(
        this->get_logger(), *this->get_clock(), 2000,
        "model tau_ff stale/invalid, fallback to table/bus bias (mode=%s)",
        PinocchioTauFfModeName(pinocchio_tau_ff_mode_));
      return Clamp(bus_tau + table_tau, ProtocolCodec::kTMin, ProtocolCodec::kTMax);
    }

    const double sign = idx < tau_signs_.size() ? tau_signs_[idx] : 1.0;
    const double gain = idx < pinocchio_tau_ff_gain_.size() ? pinocchio_tau_ff_gain_[idx] : 1.0;
    const double model_tau =
      model_tau_ff_urdf_[idx] * sign * gain * pinocchio_tau_ff_scale_ * RampFactor(now);
    double tau = bus_tau + model_tau;
    if (pinocchio_tau_ff_mode_ == PinocchioTauFfMode::ADD) {
      tau += table_tau;
    }
    return Clamp(tau, ProtocolCodec::kTMin, ProtocolCodec::kTMax);
  }

  bool IsEnabledMode(int mode_status) const
  {
    return mode_status == motor_enabled_mode_status_;
  }

  void ResetSmoothingForJoint(size_t idx, double current_champ_feedback, const rclcpp::Time & now)
  {
    if (idx >= boot_feedback_champ_rad_.size()) {
      return;
    }
    boot_feedback_champ_rad_[idx] = current_champ_feedback;
    boot_feedback_captured_[idx] = true;
    has_last_sent_[idx] = false;
    last_sent_champ_rad_[idx] = current_champ_feedback;
    first_command_time_by_joint_ns_[idx] = now.nanoseconds();
    last_command_time_by_joint_ns_[idx] = now.nanoseconds();
    ResetVelocityFf(idx);
  }

  void ResetRuntimeTuning()
  {
    runtime_kp_can0_ = Clamp(kp_, ProtocolCodec::kKpMin, ProtocolCodec::kKpMax);
    runtime_kp_can1_ = runtime_kp_can0_;
    runtime_kd_can0_ = Clamp(kd_, ProtocolCodec::kKdMin, ProtocolCodec::kKdMax);
    runtime_kd_can1_ = runtime_kd_can0_;
    runtime_tau_can0_ = Clamp(default_tau_ff_, ProtocolCodec::kTMin, ProtocolCodec::kTMax);
    runtime_tau_can1_ = runtime_tau_can0_;
  }

  static double Clamp(double v, double lo, double hi)
  {
    return std::max(lo, std::min(v, hi));
  }

  double ClampJointCommand(size_t idx, double champ_position)
  {
    if (!use_joint_cmd_limits_ || idx >= joint_cmd_min_rad_.size() || idx >= joint_cmd_max_rad_.size()) {
      return champ_position;
    }
    const double clamped = Clamp(champ_position, joint_cmd_min_rad_[idx], joint_cmd_max_rad_[idx]);
    if (std::fabs(clamped - champ_position) > 1e-9) {
      ++joint_cmd_clamp_count_total_;
    } else {
      ++joint_cmd_no_clamp_count_total_;
    }
    return clamped;
  }

  double SmoothJointCommand(size_t idx, double champ_position)
  {
    if (idx >= last_sent_champ_rad_.size()) {
      return champ_position;
    }
    const rclcpp::Time now = this->now();
    const int64_t now_ns = now.nanoseconds();
    if (first_command_time_by_joint_ns_[idx] <= 0) {
      first_command_time_by_joint_ns_[idx] = now_ns;
      last_command_time_by_joint_ns_[idx] = now_ns;
    }

    double target = champ_position;
    bool smoothing_active = false;
    if (
      enable_startup_smoothing_ &&
      startup_smoothing_duration_s_ > 1e-3 &&
      idx < boot_feedback_captured_.size() &&
      boot_feedback_captured_[idx] &&
      std::isfinite(boot_feedback_champ_rad_[idx]))
    {
      const double elapsed = static_cast<double>(now_ns - first_command_time_by_joint_ns_[idx]) * 1e-9;
      const double alpha = Clamp(elapsed / startup_smoothing_duration_s_, 0.0, 1.0);
      target = boot_feedback_champ_rad_[idx] + alpha * (champ_position - boot_feedback_champ_rad_[idx]);
      smoothing_active = (alpha < 0.999);
    }

    if (
      enable_feedback_step_limit_ &&
      feedback_step_limit_rad_ > 1e-6 &&
      idx < last_feedback_champ_rad_.size() &&
      std::isfinite(last_feedback_champ_rad_[idx]))
    {
      const int64_t stamp_ns = last_feedback_stamp_ns_[idx];
      const int64_t fresh_ns = static_cast<int64_t>(feedback_fresh_timeout_s_ * 1e9);
      if (stamp_ns > 0 && (now_ns - stamp_ns) <= fresh_ns) {
        const double delta_fb = target - last_feedback_champ_rad_[idx];
        if (std::fabs(delta_fb) > feedback_step_limit_rad_) {
          target = last_feedback_champ_rad_[idx] + std::copysign(feedback_step_limit_rad_, delta_fb);
        }
      }
    }

    const bool apply_velocity_limit = !limit_velocity_only_during_smoothing_ || smoothing_active;
    const double dt = std::max(
      static_cast<double>(now_ns - last_command_time_by_joint_ns_[idx]) * 1e-9,
      1e-3);
    const double max_step = apply_velocity_limit ?
      (std::max(0.0, command_max_velocity_rad_s_) * dt) :
      std::numeric_limits<double>::infinity();
    if (!has_last_sent_[idx]) {
      if (idx < boot_feedback_captured_.size() && boot_feedback_captured_[idx] && std::isfinite(boot_feedback_champ_rad_[idx])) {
        last_sent_champ_rad_[idx] = boot_feedback_champ_rad_[idx];
      } else {
        last_sent_champ_rad_[idx] = target;
      }
      has_last_sent_[idx] = true;
    }
    const double prev = last_sent_champ_rad_[idx];
    const double delta = Clamp(target - prev, -max_step, max_step);
    const double out = prev + delta;
    last_sent_champ_rad_[idx] = out;
    last_command_time_by_joint_ns_[idx] = now_ns;
    return out;
  }

  /// 由平滑后实际下发的位置指令差分得到 MIT 域速度前馈（θ_mit=sign*θ_champ+offset ⇒ dq_mit=sign*dq_champ）。
  double ComputeVelocityFf(size_t idx, double champ_smoothed, int64_t now_ns)
  {
    if (idx >= last_vel_ff_rad_s_.size()) {
      return 0.0;
    }
    if (!enable_velocity_ff_) {
      ResetVelocityFf(idx);
      return 0.0;
    }

    const double dt = static_cast<double>(now_ns - last_vel_sample_ns_[idx]) * 1e-9;
    if (!has_vel_sample_[idx]) {
      // 首帧 / 重启 / 门禁恢复：只记录采样点，不下发假速度
      last_vel_sample_champ_rad_[idx] = champ_smoothed;
      last_vel_sample_ns_[idx] = now_ns;
      has_vel_sample_[idx] = true;
      last_vel_ff_rad_s_[idx] = 0.0;
      return 0.0;
    }
    if (!std::isfinite(dt) || dt > 0.1) {
      // 长时间断帧（门禁关闭/上游停发）：重置采样，避免大 dt 造成假速度
      last_vel_sample_champ_rad_[idx] = champ_smoothed;
      last_vel_sample_ns_[idx] = now_ns;
      last_vel_ff_rad_s_[idx] = 0.0;
      return 0.0;
    }
    if (dt <= 1e-3) {
      // 重复/抖动帧：位置变化不可信，沿用上次滤波值
      return ClampMappedVelocityFf(idx, last_vel_ff_rad_s_[idx]);
    }

    const double raw =
      (champ_smoothed - last_vel_sample_champ_rad_[idx]) / dt;
    double filtered = raw;
    if (velocity_ff_lpf_hz_ > 1e-6) {
      const double tau = 1.0 / (2.0 * 3.141592653589793 * velocity_ff_lpf_hz_);
      const double alpha = dt / (tau + dt);
      filtered = last_vel_ff_rad_s_[idx] + alpha * (raw - last_vel_ff_rad_s_[idx]);
    }
    last_vel_sample_champ_rad_[idx] = champ_smoothed;
    last_vel_sample_ns_[idx] = now_ns;
    last_vel_ff_rad_s_[idx] = filtered;
    return ClampMappedVelocityFf(idx, filtered);
  }

  /// CHAMP 域速度 → MIT 域（乘 joint_signs）→ 乘比例系数 → 限幅。
  double ClampMappedVelocityFf(size_t idx, double champ_vel) const
  {
    const double sign = idx < joint_signs_.size() ? joint_signs_[idx] : 1.0;
    const double v_mit = sign * champ_vel * velocity_ff_scale_;
    const double lim = std::max(0.0, velocity_ff_max_clamp_);
    return Clamp(v_mit, -lim, lim);
  }

  void ResetVelocityFf(size_t idx)
  {
    if (idx >= last_vel_ff_rad_s_.size()) {
      return;
    }
    last_vel_ff_rad_s_[idx] = 0.0;
    last_vel_sample_ns_[idx] = 0;
    has_vel_sample_[idx] = false;
    last_commanded_mit_vel_rad_s_[idx] = std::numeric_limits<double>::quiet_NaN();
  }

  void ResetAllVelocityFf()
  {
    for (size_t i = 0; i < last_vel_ff_rad_s_.size(); ++i) {
      ResetVelocityFf(i);
    }
  }

  void RebuildMotorLimitTable()
  {
    if (!derive_motor_limits_from_joint_cmd_) {
      for (size_t i = 0; i < 12; ++i) {
        const double lo = std::min(joint_mit_min_rad_[i], joint_mit_max_rad_[i]);
        const double hi = std::max(joint_mit_min_rad_[i], joint_mit_max_rad_[i]);
        runtime_joint_mit_min_rad_[i] = lo;
        runtime_joint_mit_max_rad_[i] = hi;
      }
      return;
    }

    for (size_t i = 0; i < 12; ++i) {
      const double a = joint_signs_[i] * joint_cmd_min_rad_[i] + joint_offsets_rad_[i];
      const double b = joint_signs_[i] * joint_cmd_max_rad_[i] + joint_offsets_rad_[i];
      runtime_joint_mit_min_rad_[i] = std::min(a, b);
      runtime_joint_mit_max_rad_[i] = std::max(a, b);
    }
  }

  double ClampMotorCommand(size_t idx, double mit_position)
  {
    if (!use_motor_domain_limits_ || idx >= runtime_joint_mit_min_rad_.size()) {
      return mit_position;
    }
    const double clamped = Clamp(mit_position, runtime_joint_mit_min_rad_[idx], runtime_joint_mit_max_rad_[idx]);
    if (std::fabs(clamped - mit_position) > 1e-9) {
      ++motor_cmd_clamp_count_total_;
    } else {
      ++motor_cmd_no_clamp_count_total_;
    }
    return clamped;
  }

  static bool ParseKV(const std::string & token, std::string & key, std::string & value)
  {
    const auto pos = token.find('=');
    if (pos == std::string::npos || pos == 0 || pos + 1 >= token.size()) {
      return false;
    }
    key = ToLower(token.substr(0, pos));
    value = token.substr(pos + 1);
    return true;
  }

  void OnTuneCommand(const String::SharedPtr msg)
  {
    if (!msg) {
      return;
    }

    auto scope = TuneScope::ALL;
    bool do_reset = false;
    bool has_kp = false;
    bool has_kd = false;
    bool has_tau = false;
    bool has_vff = false;
    bool has_vff_scale = false;
    bool has_vff_max = false;
    double new_kp = 0.0;
    double new_kd = 0.0;
    double new_tau = 0.0;
    bool new_vff = false;
    double new_vff_scale = 0.0;
    double new_vff_max = 0.0;

    const auto tokens = SplitTokens(msg->data);
    for (const auto & token : tokens) {
      std::string key;
      std::string value;
      if (!ParseKV(token, key, value)) {
        continue;
      }
      if (key == "scope") {
        scope = ParseScope(value);
        continue;
      }
      if (key == "reset") {
        do_reset = ParseBool(value);
        continue;
      }
      if (key == "vff") {
        new_vff = ParseBool(value);
        has_vff = true;
        continue;
      }
      try {
        const double parsed = std::stod(value);
        if (key == "kp") {
          new_kp = Clamp(parsed, ProtocolCodec::kKpMin, ProtocolCodec::kKpMax);
          has_kp = true;
        } else if (key == "kd") {
          new_kd = Clamp(parsed, ProtocolCodec::kKdMin, ProtocolCodec::kKdMax);
          has_kd = true;
        } else if (key == "tau" || key == "tau_ff") {
          new_tau = Clamp(parsed, ProtocolCodec::kTMin, ProtocolCodec::kTMax);
          has_tau = true;
        } else if (key == "vff_scale") {
          new_vff_scale = Clamp(parsed, 0.0, 3.0);
          has_vff_scale = true;
        } else if (key == "vff_max") {
          new_vff_max = parsed;
          has_vff_max = true;
        }
      } catch (const std::exception &) {
        RCLCPP_WARN(this->get_logger(), "Ignore invalid tune token: %s", token.c_str());
      }
    }

    if (do_reset) {
      ResetRuntimeTuning();
      ResetAllVelocityFf();
      RCLCPP_WARN(this->get_logger(), "MIT tune reset to defaults from parameters.");
    }

    auto apply_scoped = [&](double & front, double & rear, double v) {
      if (scope == TuneScope::ALL) {
        front = v;
        rear = v;
      } else if (scope == TuneScope::FRONT) {
        front = v;
      } else {
        rear = v;
      }
    };

    if (has_kp) {
      apply_scoped(runtime_kp_can0_, runtime_kp_can1_, new_kp);
    }
    if (has_kd) {
      apply_scoped(runtime_kd_can0_, runtime_kd_can1_, new_kd);
    }
    if (has_tau) {
      apply_scoped(runtime_tau_can0_, runtime_tau_can1_, new_tau);
    }
    if (has_vff) {
      enable_velocity_ff_ = new_vff;
      ResetAllVelocityFf();
    }
    if (has_vff_scale) {
      velocity_ff_scale_ = new_vff_scale;
    }
    if (has_vff_max) {
      if (!std::isfinite(new_vff_max) || new_vff_max <= 0.0) {
        velocity_ff_max_rad_s_ = 8.0;
      } else {
        velocity_ff_max_rad_s_ = new_vff_max;
      }
      velocity_ff_max_clamp_ = std::min(
        std::fabs(velocity_ff_max_rad_s_), static_cast<double>(ProtocolCodec::kVMax));
    }

    RCLCPP_WARN(
      this->get_logger(),
      "MIT tune applied: raw='%s' | can0(kp=%.2f,kd=%.2f,tau=%.2f) can1(kp=%.2f,kd=%.2f,tau=%.2f) | vff=%d scale=%.2f max=%.2f",
      msg->data.c_str(),
      runtime_kp_can0_, runtime_kd_can0_, runtime_tau_can0_,
      runtime_kp_can1_, runtime_kd_can1_, runtime_tau_can1_,
      enable_velocity_ff_ ? 1 : 0, velocity_ff_scale_, velocity_ff_max_clamp_);
  }

  double kp_{30.0};
  double kd_{1.5};
  double default_velocity_{0.0};
  double default_tau_ff_{0.0};
  bool enable_velocity_ff_{false};
  double velocity_ff_scale_{1.0};
  double velocity_ff_max_rad_s_{8.0};
  double velocity_ff_lpf_hz_{20.0};
  bool publish_velocity_ff_{true};
  double velocity_ff_max_clamp_{8.0};
  std::string runtime_tune_topic_;
  bool publish_feedback_joint_states_{true};
  std::string feedback_joint_states_topic_;
  double feedback_joint_states_timer_hz_{50.0};
  bool publish_feedback_velocity_effort_{true};
  bool feedback_joint_fill_nan_{true};
  bool publish_motor_diagnostics_{false};
  std::string motor_diagnostics_topic_;
  bool enable_joint_tau_ff_{false};
  double gravity_ff_scale_{0.5};
  std::vector<double> tau_ff_nominal_nm_;
  PinocchioTauFfMode pinocchio_tau_ff_mode_{PinocchioTauFfMode::OFF};
  std::string pinocchio_tau_ff_topic_;
  double pinocchio_tau_ff_scale_{0.5};
  std::vector<double> pinocchio_tau_ff_gain_{std::vector<double>(12, 1.0)};
  double pinocchio_tau_ff_timeout_s_{0.2};
  double pinocchio_tau_ff_ramp_s_{1.0};
  std::vector<double> tau_signs_;
  bool tau_signs_explicit_{false};
  std::array<double, 12> model_tau_ff_urdf_{};
  std::array<bool, 12> model_tau_ff_valid_{};
  rclcpp::Time model_tau_ff_stamp_{0, 0, RCL_ROS_TIME};
  bool has_model_tau_ff_{false};
  double model_tau_ff_max_abs_{0.0};
  int64_t model_ff_ramp_start_ns_{0};
  bool use_joint_cmd_limits_{true};
  std::vector<double> joint_cmd_min_rad_;
  std::vector<double> joint_cmd_max_rad_;
  bool use_motor_domain_limits_{true};
  bool derive_motor_limits_from_joint_cmd_{true};
  std::vector<double> joint_mit_min_rad_;
  std::vector<double> joint_mit_max_rad_;
  std::array<double, 12> runtime_joint_mit_min_rad_{};
  std::array<double, 12> runtime_joint_mit_max_rad_{};
  bool enable_startup_smoothing_{true};
  double startup_smoothing_duration_s_{1.5};
  double command_max_velocity_rad_s_{6.0};
  bool limit_velocity_only_during_smoothing_{true};
  bool enable_mode_rising_smoothing_{true};
  int motor_enabled_mode_status_{2};
  bool enable_feedback_step_limit_{true};
  double feedback_step_limit_rad_{0.20};
  double feedback_fresh_timeout_s_{0.30};
  bool enable_rx_decode_log_{true};
  bool prefer_joint_name_mapping_{true};
  bool enable_power_sequence_gate_{true};
  std::string power_sequence_gate_topic_;
  bool power_gate_open_{false};
  bool tx_enable_can0_{true};
  bool tx_enable_can1_{true};
  bool enable_min_tx_refresh_{true};
  double min_tx_refresh_interval_s_{0.02};
  bool enable_max_tx_rate_limit_{true};
  double max_tx_rate_per_motor_hz_{60.0};
  std::vector<double> joint_signs_;
  std::vector<double> joint_offsets_rad_;
  std::vector<double> joint_cmd_offsets_rad_;
  bool publish_mit_mapped_{false};
  std::string mit_mapped_topic_;
  rclcpp::Publisher<JointState>::SharedPtr mapped_positions_pub_;
  std::array<double, 256> last_commanded_mit_rad_{};
  std::array<double, 12> last_vel_sample_champ_rad_{};
  std::array<double, 12> last_vel_ff_rad_s_{};
  std::array<double, 12> last_commanded_mit_vel_rad_s_{};
  std::array<int64_t, 12> last_vel_sample_ns_{};
  std::array<bool, 12> has_vel_sample_{};
  std::array<double, 12> last_feedback_champ_rad_{};
  std::array<double, 12> last_feedback_joint_vel_rad_s_{};
  std::array<double, 12> last_feedback_effort_nm_{};
  std::array<int, 12> last_feedback_mode_status_{};
  std::array<double, 12> last_feedback_temp_c_{};
  std::array<uint32_t, 12> last_feedback_fault_mask_{};
  std::array<double, 12> last_sent_champ_rad_{};
  std::array<double, 12> latest_input_champ_rad_{};
  std::array<double, 12> boot_feedback_champ_rad_{};
  std::array<bool, 12> has_latest_input_{};
  std::array<bool, 12> boot_feedback_captured_{};
  std::array<bool, 12> has_last_sent_{};
  std::array<int, 256> last_mode_status_{};
  std::array<bool, 256> has_mode_status_{};
  std::array<int64_t, 12> last_feedback_stamp_ns_{};
  std::array<int64_t, 12> first_command_time_by_joint_ns_{};
  std::array<int64_t, 12> last_command_time_by_joint_ns_{};
  std::array<int64_t, 12> last_tx_pub_stamp_ns_{};
  size_t error_sample_count_{0};
  double error_abs_sum_{0.0};
  double error_abs_max_{0.0};
  double runtime_kp_can0_{30.0};
  double runtime_kd_can0_{1.5};
  double runtime_tau_can0_{0.0};
  double runtime_kp_can1_{30.0};
  double runtime_kd_can1_{1.5};
  double runtime_tau_can1_{0.0};
  size_t joint_cmd_clamp_count_total_{0};
  size_t joint_cmd_no_clamp_count_total_{0};
  size_t motor_cmd_clamp_count_total_{0};
  size_t motor_cmd_no_clamp_count_total_{0};
  size_t traj_cb_count_window_{0};
  size_t traj_joint_count_window_{0};
  size_t tx_traj_total_window_{0};
  size_t tx_traj_can0_window_{0};
  size_t tx_traj_can1_window_{0};
  size_t tx_refresh_total_window_{0};
  size_t tx_refresh_can0_window_{0};
  size_t tx_refresh_can1_window_{0};
  size_t skip_max_rate_limit_window_{0};
  size_t skip_bus_disabled_window_{0};
  size_t skip_power_gate_window_{0};

  rclcpp::Subscription<JointTrajectory>::SharedPtr traj_sub_;
  rclcpp::Subscription<UInt8MultiArray>::SharedPtr rx_sub_;
  rclcpp::Subscription<String>::SharedPtr tune_sub_;
  rclcpp::Subscription<JointState>::SharedPtr model_tau_sub_;
  rclcpp::Subscription<Bool>::SharedPtr gate_sub_;
  rclcpp::Publisher<UInt8MultiArray>::SharedPtr tx_pub_;
  rclcpp::Publisher<String>::SharedPtr feedback_pub_;
  rclcpp::Publisher<JointState>::SharedPtr feedback_joint_states_pub_;
  rclcpp::Publisher<DiagnosticArray>::SharedPtr diagnostics_pub_;
  rclcpp::node_interfaces::OnSetParametersCallbackHandle::SharedPtr on_set_params_handle_;
  rclcpp::TimerBase::SharedPtr feedback_js_timer_;
  rclcpp::TimerBase::SharedPtr tx_refresh_timer_;
  rclcpp::TimerBase::SharedPtr tx_stats_timer_;
};

}  // namespace trotbot_can_bridge

int main(int argc, char ** argv)
{
  rclcpp::init(argc, argv);
  rclcpp::spin(std::make_shared<trotbot_can_bridge::MotorProtocolNode>());
  rclcpp::shutdown();
  return 0;
}
