deep-diary/trotbot_ws/src/trotbot/config/champ/gait.yaml

/**:
  ros__parameters:
    gait:
      knee_orientation : ">>"
      pantograph_leg : false
      odom_scaler: 1.0
      max_linear_velocity_x : 0.20
      max_linear_velocity_y : 0.20
      max_angular_velocity_z : 1.0
      com_x_translation : 0.0
      swing_height : 0.025
      stance_depth : 0.005
      stance_duration : 0.2
      nominal_height : 0.12
