deep-diary/trotbot_ws/src/trotbot/launch/trotbot_teleop.launch.py

#!/usr/bin/env python3
#
# SPDX-License-Identifier: Apache-2.0
#
# TrotBot Teleop Launch File
# Dedicated launch file for keyboard and joystick teleoperation of TrotBot
# This launch file provides the champ_teleop interface separately from the basic launch
#
# CONTROL INTERFACES:
# - Keyboard: Terminal-based keyboard control via champ_teleop
# - Joystick: Optional joystick integration with advanced pose control
# - Both interfaces can run simultaneously for flexibility
#
# USAGE:
#   Keyboard + Joystick（默认，含 PS4 灯条/振动反馈）:
#     ros2 launch trotbot trotbot_teleop.launch.py
#
#   Keyboard only（不启动 joy_node）:
#     ros2 launch trotbot trotbot_teleop.launch.py use_joystick:=false
#
#   Custom joystick device (/dev/input/jsN — N 会传给 ROS 2 joy_node 的 device_id):
#     ros2 launch trotbot trotbot_teleop.launch.py joystick_dev:=/dev/input/js1
#
# NOTE: This launch file only provides the teleop interface. You must also run:
#   ros2 launch trotbot trotbot_basic.launch.py
# to start the core TrotBot functionality (quadruped_controller, servo_interface, etc.)

import re

from launch import LaunchDescription
from launch.actions import DeclareLaunchArgument, IncludeLaunchDescription, OpaqueFunction
from launch.conditions import IfCondition
from launch.launch_description_sources import PythonLaunchDescriptionSource
from launch.substitutions import LaunchConfiguration, PathJoinSubstitution
from launch_ros.substitutions import FindPackageShare


def _include_champ_teleop(context, *args, **kwargs):
    """从 joystick_dev 路径解析 js 编号，传给 champ_teleop 的 joy_device_id。"""
    joystick_dev = context.launch_configurations.get("joystick_dev", "/dev/input/js0")
    m = re.search(r"js(\d+)\s*$", joystick_dev)
    joy_id = m.group(1) if m else "0"

    champ_teleop_launch_path = PathJoinSubstitution(
        [FindPackageShare("champ_teleop"), "launch", "teleop.launch.py"]
    )
    return [
        IncludeLaunchDescription(
            PythonLaunchDescriptionSource(champ_teleop_launch_path),
            launch_arguments={
                "use_sim_time": context.launch_configurations.get("use_sim_time", "false"),
                "use_joy": context.launch_configurations.get("use_joystick", "false"),
                "joy_device_id": joy_id,
                "use_xterm": context.launch_configurations.get("use_xterm", "true"),
                "block_body_pose_until_running": context.launch_configurations.get(
                    "block_body_pose_until_running", "true"
                ),
            }.items(),
        )
    ]


def generate_launch_description():
    use_sim_time_launch_arg = DeclareLaunchArgument(
        name="use_sim_time",
        default_value="False",
        description="Use simulation (Gazebo) clock if true",
    )

    use_joystick_launch_arg = DeclareLaunchArgument(
        name="use_joystick",
        default_value="true",
        description="Enable joystick/gamepad control (default: true; 纯键盘请传 use_joystick:=false)",
    )

    joystick_dev_launch_arg = DeclareLaunchArgument(
        name="joystick_dev",
        default_value="/dev/input/js0",
        description="Joystick device path; 末尾 jsN 中的 N 会作为 joy_node 的 device_id",
    )

    use_xterm_launch_arg = DeclareLaunchArgument(
        name="use_xterm",
        default_value="true",
        description="是否用 xterm 跑键盘遥控（桌面默认 true）；无 DISPLAY 时设 false 并配合 ssh -t 或改用 /cmd_vel",
    )

    use_ps4_feedback = LaunchConfiguration("use_ps4_feedback")
    use_ps4_feedback_launch_arg = DeclareLaunchArgument(
        name="use_ps4_feedback",
        default_value="true",
        description="是否启动 PS4 手柄灯条/振动反馈（无手柄时节点只发调试话题，可设 false 关闭）",
    )

    block_body_pose_until_running_launch_arg = DeclareLaunchArgument(
        name="block_body_pose_until_running",
        default_value="true",
        description="真机默认 true；仿真/台架无电源序列时设 false，允许手柄直接调 body_pose",
    )

    ps4_feedback_launch = IncludeLaunchDescription(
        PythonLaunchDescriptionSource(
            PathJoinSubstitution(
                [FindPackageShare("trotbot_status_led"), "launch", "ps4_feedback.launch.py"]
            )
        ),
        condition=IfCondition(use_ps4_feedback),
    )

    return LaunchDescription(
        [
            use_sim_time_launch_arg,
            use_joystick_launch_arg,
            joystick_dev_launch_arg,
            use_xterm_launch_arg,
            use_ps4_feedback_launch_arg,
            block_body_pose_until_running_launch_arg,
            OpaqueFunction(function=_include_champ_teleop),
            ps4_feedback_launch,
        ]
    )
