deep-diary/trotbot_ws/src/trotbot/test/test_leg_comprehensive.py

#!/usr/bin/env python3
"""
Comprehensive TrotBot Leg Testing System
Tests individual legs and coordinated multi-leg movements using TrotBot HAL
Supports all four legs with proper inverse kinematics and servo control
"""

import sys
import time
import numpy as np
import math
import argparse

# Import TrotBot HAL modules
from hal.hardware.hardware_interface import HardwareInterface
from hal.hardware.config import ServoParams, PWMParams


class TrotBotLegKinematics:
    """Inverse kinematics for TrotBot quadruped"""

    def __init__(self):
        """Initialize with TrotBot leg geometry"""
        # TrotBot leg geometry (similar to Mini Pupper but using TrotBot config)
        self.LEG_L1 = 0.0735  # Thigh length (m) - 73.5mm
        self.LEG_L2 = 0.060   # Calf length (m) - 60mm
        self.ABDUCTION_OFFSET = 0.03675  # Hip offset (m) - 36.75mm

        # Leg indexing: 0=Front-Right, 1=Front-Left, 2=Back-Right, 3=Back-Left
        self.leg_names = ["Front-Right", "Front-Left", "Back-Right", "Back-Left"]

        # Abduction offset signs for each leg (right legs negative, left legs positive)
        self.abduction_offsets = [-self.ABDUCTION_OFFSET, self.ABDUCTION_OFFSET,
                                 -self.ABDUCTION_OFFSET, self.ABDUCTION_OFFSET]

        # Working ranges from calibration (degrees) - same for all legs
        self.hip_range = (-30, 30)    # -30° to 30° (abduction limits)
        self.thigh_range = (0, 90)    # 0° to 90°
        self.calf_range = (-90, 0)    # -90° to 0°

        print(f"🔧 TrotBot Leg Kinematics initialized:")
        print(f"   Thigh length (L1): {self.LEG_L1*1000:.1f}mm")
        print(f"   Calf length (L2): {self.LEG_L2*1000:.1f}mm")
        print(f"   Hip offset: {self.ABDUCTION_OFFSET*1000:.1f}mm")
        print(f"   Total reach: {(self.LEG_L1 + self.LEG_L2)*1000:.1f}mm")

    def get_leg_name(self, leg_index):
        """Get human-readable leg name"""
        return self.leg_names[leg_index] if 0 <= leg_index < 4 else f"Invalid-{leg_index}"

    def leg_inverse_kinematics(self, foot_position, leg_index):
        """Calculate joint angles for given foot position and leg

        Parameters
        ----------
        foot_position : array_like
            Foot position [x, y, z] relative to hip joint (meters)
        leg_index : int
            Leg index (0=Front-Right, 1=Front-Left, 2=Back-Right, 3=Back-Left)

        Returns
        -------
        tuple
            (hip_angle, thigh_angle, calf_angle) in radians, or None if unreachable
        """
        x, y, z = foot_position
        abduction_offset = self.abduction_offsets[leg_index]

        # Distance from the leg origin to the foot, projected into the y-z plane
        R_body_foot_yz = math.sqrt(y**2 + z**2)

        # Check if foot position is reachable (must be outside hip offset)
        if R_body_foot_yz < abs(abduction_offset):
            return None

        # Distance from the leg's forward/back point of rotation to the foot
        R_hip_foot_yz = math.sqrt(R_body_foot_yz**2 - abduction_offset**2)

        # Interior angle of the right triangle formed in the y-z plane
        arccos_argument = abduction_offset / R_body_foot_yz
        arccos_argument = max(-0.99, min(0.99, arccos_argument))  # Clamp to valid range
        phi = math.acos(arccos_argument)

        # Angle of the y-z projection of the hip-to-foot vector
        hip_foot_angle = math.atan2(z, y)

        # Hip/abduction angle
        hip_angle = phi + hip_foot_angle

        # Angle between the tilted negative z-axis and the hip-to-foot vector
        theta = math.atan2(-x, R_hip_foot_yz)

        # Distance between the hip and foot
        R_hip_foot = math.sqrt(R_hip_foot_yz**2 + x**2)

        # Check if target is reachable by leg links
        max_reach = self.LEG_L1 + self.LEG_L2  # 73.5mm + 60mm = 133.5mm
        min_reach = abs(self.LEG_L1 - self.LEG_L2)  # |73.5mm - 60mm| = 13.5mm
        if R_hip_foot > max_reach or R_hip_foot < min_reach:
            return None

        # Angle between the line going from hip to foot and the thigh link L1
        arccos_argument = (self.LEG_L1**2 + R_hip_foot**2 - self.LEG_L2**2) / (2 * self.LEG_L1 * R_hip_foot)
        arccos_argument = max(-0.99, min(0.99, arccos_argument))  # Clamp to valid range
        trident = math.acos(arccos_argument)

        # Thigh angle relative to the tilted negative z axis
        thigh_angle = theta + trident

        # Angle between the leg links L1 and L2
        arccos_argument = (self.LEG_L1**2 + self.LEG_L2**2 - R_hip_foot**2) / (2 * self.LEG_L1 * self.LEG_L2)
        arccos_argument = max(-0.99, min(0.99, arccos_argument))  # Clamp to valid range
        beta = math.acos(arccos_argument)

        # Calf angle relative to the tilted negative z axis
        calf_angle = thigh_angle - (math.pi - beta)

        return (hip_angle, thigh_angle, calf_angle)

    def check_joint_limits(self, joint_angles_rad, leg_index):
        """Check if joint angles are within safe working ranges

        Parameters
        ----------
        joint_angles_rad : tuple
            (hip_angle, thigh_angle, calf_angle) in radians
        leg_index : int
            Leg index for identification in error messages

        Returns
        -------
        bool
            True if all angles are within safe limits
        """
        if joint_angles_rad is None:
            return False

        hip_angle, thigh_angle, calf_angle = joint_angles_rad

        # Convert to degrees for limit checking
        hip_deg = math.degrees(hip_angle)
        thigh_deg = math.degrees(thigh_angle)
        calf_deg = math.degrees(calf_angle)

        # Check hip limits (-30° to 30°) - abduction safety
        if not (self.hip_range[0] <= hip_deg <= self.hip_range[1]):
            return False

        # Check thigh limits (0° to 90°) - same for all legs
        if not (self.thigh_range[0] <= thigh_deg <= self.thigh_range[1]):
            return False

        # Check calf limits (-90° to 0°) - same for all legs
        if not (self.calf_range[0] <= calf_deg <= self.calf_range[1]):
            return False

        return True

    def validate_workspace_detailed(self, foot_position, leg_index):
        """Detailed workspace validation with diagnostic information

        Parameters
        ----------
        foot_position : array_like
            Foot position [x, y, z] relative to hip joint (meters)
        leg_index : int
            Leg index for identification

        Returns
        -------
        tuple
            (is_valid, diagnostic_info)
        """
        x, y, z = foot_position
        leg_name = self.get_leg_name(leg_index)

        # Calculate distance from hip
        distance_from_hip = math.sqrt(x**2 + y**2 + z**2)
        max_reach = self.LEG_L1 + self.LEG_L2  # 133.5mm
        min_reach = abs(self.LEG_L1 - self.LEG_L2)  # 13.5mm

        diagnostic = {
            'leg_name': leg_name,
            'position': f"x={x*1000:.1f}mm, y={y*1000:.1f}mm, z={z*1000:.1f}mm",
            'distance_from_hip': f"{distance_from_hip*1000:.1f}mm",
            'max_reach': f"{max_reach*1000:.1f}mm",
            'min_reach': f"{min_reach*1000:.1f}mm",
            'within_reach': min_reach <= distance_from_hip <= max_reach
        }

        # Try inverse kinematics
        joint_angles = self.foot_position_to_joint_angles(foot_position, leg_index)
        diagnostic['ik_successful'] = joint_angles is not None

        if joint_angles:
            hip_deg, thigh_deg, calf_deg = joint_angles
            diagnostic['joint_angles'] = f"Hip={hip_deg:.1f}°, Thigh={thigh_deg:.1f}°, Calf={calf_deg:.1f}°"
            diagnostic['hip_in_range'] = self.hip_range[0] <= hip_deg <= self.hip_range[1]
            diagnostic['thigh_in_range'] = self.thigh_range[0] <= thigh_deg <= self.thigh_range[1]
            diagnostic['calf_in_range'] = self.calf_range[0] <= calf_deg <= self.calf_range[1]

        is_valid = diagnostic['within_reach'] and diagnostic['ik_successful']
        return is_valid, diagnostic

    def foot_position_to_joint_angles(self, foot_position, leg_index):
        """Convert foot position to joint angles with safety checks
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
