deep-diary/trotbot_ws/(commit log)

2026-04-12 chore(repo): initialize colcon workspace repository
    - Add workspace-root .gitignore (colcon artifacts, Python, IDE, ROS data)
    - Import src packages: champ (ros2), champ_teleop, trotbot, minidog
    Made-with: Cursor
    [accessories.urdf.xacro, asus_camera.urdf.xacro, base.STL, base.stl, base_link.STL, base_simple.stl, champ.urdf, champ.urdf.xacro]
2026-04-12 feat(workspace): Minidog CHAMP support, launch URDF/gait selection, IK fallback
    - trotbot: add minidog_champ.urdf.xacro, gait_minidog.yaml, meshes/minidog STL assets
    - trotbot: parameterize champ_controllers and trotbot_basic (description_file, gait_config_file); wrap xacro Command in ParameterValue(str)
    - champ_base: zero-init IK buffer; reuse last finite joint solution when inverse() yields non-finite values
    - servo_interface: note Minidog joint limit tuning for real hardware
    - docs: add workspace README with colcon rebuild and Minidog launch hints
    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
    [base.STL, lf_calf.STL, lf_foot.STL, lf_hip.STL, lf_thigh.STL, lr_calf.STL, lr_foot.STL, lr_hip.STL]
2026-04-14 doc: add the develop plan and motor instrunction
2026-04-23 feat(can_bridge): send the trajectory to motor through can bus
    [accessories.urdf.xacro, asus_camera.urdf.xacro, base.STL, base.stl, base_link.STL, base_simple.stl, champ.urdf, champ.urdf.xacro]
2026-04-23 feat(can): hex line trace, bus counters, and teleop body height
    - can_transport: optional String topics for TX/RX hex lines; per-can0/can1 stats; protocol FrameLineHex()
    - config: extend bridge.yaml and control_gains defaults; install el05_motor_cansend.sh
    - docs: workspace README (standalone bridge, EL05/cansend); package README with captured frames
    - champ_teleop: keyboard t/b adjusts body_pose z like gamepad axis; quaternion doc fix
    - Fix README colcon package name typo (trotbot_can_bridge)
    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
    [control_gains.yaml]
2026-04-23 docs(can): consolidate MIT dual-CAN runbook and raise default kp
    Unify the root runbook with the latest MIT dual-CAN bring-up workflow and set the bridge default kp to 30.0 to match the current protocol-side control baseline.
    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
2026-04-26 feat(trotbot): tune minidog bring-up and expand motor protocol controls
    Refine launch/URDF/RViz defaults for Minidog operation and extend can-bridge protocol behavior with updated gains and documentation so bring-up and motion tuning are more consistent.
    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
    [minidog_champ.urdf.xacro]
2026-04-26 feat(can_bridge): add mode-aware smoothing and motor-domain safety limits
    Improve motor protocol robustness by adding motor-domain clamping, enable-mode rising-edge smoothing resets, and optional feedback-based step limiting; update launch/rviz visuals and bridge docs/config to match the new behavior.
    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
    [control_gains.yaml, motor_protocol_node.cpp, trotbot_basic.launch.py]
2026-04-27 docs(can): reorganize trotbot docs and sync CAN calibration updates
    Move and refine trotbot documentation structure while carrying forward local architecture and runbook edits. Keep CAN bridge gain/calibration notes aligned with the latest merged runtime behavior.
    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
2026-04-27 chore(backup): snapshot current build before front-leg stutter fix
    Create a full backup commit of the current workspace state before investigating the front-leg stutter issue, including latest bridge, gait, and tracking doc updates.
    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
    [can_transport_node.cpp, control_gains.yaml, gait_minidog.yaml, motor_protocol_node.cpp]
2026-04-28 feat(hal): add EL05 DBC generator and strict/full protocol files
    Add a script to generate single-motor EL05 DBC definitions and include refreshed strict/full DBC artifacts for CAN protocol validation and tooling.
    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
2026-04-29 feat(can_bridge): align DDS QoS and 200Hz tx pacing
    Switch can_tx_frames to reliable deep-queue QoS on both protocol and transport nodes, raise per-motor tx rate cap to 200Hz, and add diagnostics/scripts/docs to verify end-to-end frequency behavior and bus balance.
    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
2026-05-01 feat(can_bridge): add power sequence node and align launch stack
    Introduce power_sequence orchestration with config and launch wiring, extend motor protocol and bridge integration, and sync trotbot/teleop plus project documentation.
    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
    [gamepad_controller.yaml]
2026-05-01 fix(can_bridge): refine power sequence config and docs
    Tune power_sequence behavior and YAML defaults, update bridge README and project docs to match current bring-up flow.
    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
    [power_sequence.yaml, power_sequence_node.cpp]
2026-05-01 docs(trotbot): sync architecture and run guides with current stack
    Refresh root and package READMEs plus trotbot docs index, architecture, requirements, issue tracking, and local run guide to match the latest CAN bridge and power-sequence workflow.
    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
2026-05-01 feat(can_bridge): extend power sequence and protocol codec
    Expand power_sequence_node behavior and YAML options, adjust protocol codec details, refresh bridge README and trotbot requirement/architecture/issue docs.
    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
    [power_sequence.yaml, power_sequence_node.cpp, protocol_codec.hpp]
2026-05-02 docs(trotbot): add audio guide and sync bridge config defaults
    Add audio usage doc, link it from trotbot docs and local run guide, update root README and can_bridge README, and align control_gains/power_sequence YAML with current bring-up.
2026-05-02 docs(trotbot): refresh software requirements checklist
    Update the requirements document with current implementation status and details aligned with the latest stack.
2026-05-02 docs: add PS4 key guide and sync power sequence docs
    Add PS4 button documentation and images, refresh README/architecture/requirements/run guides, tune champ teleop mapping notes, and extend power_sequence behavior with README/config updates.
2026-05-03 feat(can_bridge): extend motor protocol and add trotbot reference docs
    Expand motor_protocol_node behavior and config; update package build metadata and bridge README. Add ros node/topic details and job role documents, and sync architecture and software requirements.
2026-05-03 docs(trotbot): update software requirements checklist
    Refresh requirement entries and completion notes to match the current implementation baseline.
2026-05-03 feat(trotbot_status_led): add status LED package and board pin docs
    Introduce trotbot_status_led with config and launch integration, add LubanCat-4-V1 pin reference images and doc, and sync issue tracking, architecture, and software requirements.
    [status_led_node.cpp, status_led_params.yaml, trotbot_basic.launch.py, ws2812_gpiod.cpp]
2026-05-04 feat(trotbot_status_led): add SPI spidev backend for WS2812
    Wire ws2812_spidev implementation into status_led_node with CMake/package docs, expand params YAML, and document LubanCat SPI0 overlay plus RK3588 SPI WS2812 notes alongside synced project docs.
2026-05-04 docs(status_led): add udev rules and document integrated launch
    Add spidev udev rules under trotbot_status_led, optional systemd snippets under trotbot config, refresh README/SPI docs and manual test script, and update root README with status_led launch flags.
2026-05-05 feat(trotbot_status_led): extend status LED behavior and add restart script
    Expand status_led_node mapping and parameters, add restart_trotbot_basic.sh and install rules, update power_sequence_node touch points, and sync README and trotbot documentation.
2026-11-02 feat: add one-time motor init, PS4 feedback and stack control script
    - power_sequence: Share+Options long-press writes zero_sta=1, saves to flash and verifies
    readback; start now holds MIT at feedback angle and requires fresh 12/12 feedback
    - status_led: add ds4_feedback_node for PS4 lightbar/rumble synced to power state
    - trotbot: add trotbot_ctl.sh / main.sh for start/stop/restart/status with sim mode
    - teleop: split body_z limits (max +0.015 / min -0.08) and force joy_node evdev layout
    - docs: update PS4 mapping, launch usage and requirements
2026-11-03 feat: remap PS4 controls, add calibration CLI and split-body URDF
    - power_sequence: edge-triggered keys — L3 start, Square stand, Circle idle-prone,
    R3 shutdown; L1+R1 long-press now runs motor_init with set_zero before zero_sta
    write/save/readback; Options-triggered set_zero removed
    - urdf/rviz: split base.STL into body/head meshes with per-part colour args
    - scripts: trotbot_ctl.sh gains motor/calib/led-test subcommands;
    restart_trotbot_basic.sh forwards to the unified ctl script
    - docs: sync PS4 mapping, launch usage and troubleshooting
2026-11-03 docs: document joint feedback topic and latest PS4 controls
    - 说明查看 12 个电机角度使用 /joint_states_feedback（备选 /motor_feedback）
    - 同步 power_sequence 最新按键（L3 上电、□ 站起、○ 趴下、R3 下电、L1+R1 设零）
    - 补充 champ_teleop 轴/键映射与仿真模式说明
    - 纳入 .trae 规则与计划文档
2026-11-03 feat(can_bridge): add motor_monitor_node for per-joint torque logging
    - subscribe /motor_feedback and print 12 joints (position/torque/both) at print_hz
    - track per-joint peak |torque| since node start, keep signed value
    - README: document the monitor node and candump / hex-line frame inspection
2026-11-04 feat(dynamics): add Pinocchio fixed-base gravity feedforward (RQ-025)
    - new trotbot_dynamics package: pinocchio_tau_ff_node builds the URDF model,
    computes g(q) at 50Hz and publishes /model_tau_ff (URDF joint signs)
    - motor_protocol_node: pinocchio_tau_ff_mode off|replace|add, scale, timeout,
    ramp and tau_signs, runtime-tunable with stale-data fallback
    - launch: use_pinocchio_tau_ff threaded through trotbot_basic/can_bridge
    - docs: RQ-025 status, architecture/README updates and add development roadmap
2026-11-04 feat(can_bridge): add velocity feedforward and gravity calibration tooling
    - motor_protocol: velocity FF from smoothed position derivative with scale,
    clamp and LPF; add pinocchio_tau_ff_gain (12-dim) and runtime vff toggle
    - control_gains: per-joint calibrated gravity gains, pinocchio mode=replace
    - can_bridge launch: wrap pinocchio mode in ParameterValue(str) so 'off' is not
    parsed as bool and rejected at startup
    - trotbot_ctl: add check subcommand for CAN bridge/12-motor health, run it after
    a real start; install plot_velocity_ff.py
    - trotbot_dynamics: add calibrate_gravity.py record/sweep/fit helper
2026-11-04 tune(can_bridge): raise MIT gains and enable velocity feedforward
    - control_gains: kp 50->100, kd 2.5->4.0; enable_velocity_ff on with
    scale 0.7 and 6.0 rad/s clamp
    - docs: document per-joint pinocchio_tau_ff_gain and its calibration output
2026-11-05 feat: add thermal protection and command offsets, split README into topic docs
    - power_sequence: over-temperature protection with debounce, latch and recovery
    hysteresis, triggering an R3-equivalent safe-park then disable; use SmoothStep
    on stand/prone height ramps to avoid kd torque spikes
    - motor_protocol: joint_cmd_offsets_rad applied only to outgoing targets
    - motor_monitor: speed/temp/all modes, motor_ids filter and decimals option
    - control_gains: tuned per-joint command offsets for standing balance
    - docs: move root README details into docs/trotbot topic pages and update
    navigation
2026-11-05 chore: add design plan docs and measurement data
    - .trae/documents: RQ-025, thermal protection, velocity feedforward and
    roadmap authoring plans
    - analysis: velocity-FF A/B traces, stand jolt and foam sweep measurement CSVs
