deep-diary/trotbot_ws/(notices)

Notices in the files:
src/trotbot/README.md:
License: MIT
